mteichtahl/trace/templates/scaffold/empty/README.md

# __TR_NAME__

Run by [trace](https://github.com/mteichtahl/trace): pushes open their own pull requests, which merge themselves when the build passes; failures are triaged and fixed by the worker. The rules for agents are in `.trace/rules.md`.
