mteichtahl/trace/templates/scaffold/kicad/hardware/README.md

# Hardware

Put the KiCad project here (File → New Project in KiCad, saved in this folder). The build runs ERC and DRC on every project it finds (`tracectl check`).
