mteichtahl/trace/templates/scaffold/kicad/firmware/README.md

# Firmware

Put the firmware here. `tracectl firmware detect` recognises Cargo (embedded Rust), PlatformIO, Zephyr, ESP-IDF, the Pico SDK, Arduino and Makefiles; register a target with `tracectl config set firmware.targets ...`.
