mteichtahl/trace/docs/user-journey.md

# trace: user journey from definition to fabrication

Oct 27, 2026 · @Marc Teichtahl

A trace project moves through nine stages, from a written intent to a board running its own tests on the bench, and every stage ends at a gate a person passes. The agents do the measuring; people make the calls that cost money or cannot be undone.

## Who uses it and how it behaves

Three roles, mapped onto trace's existing permission classes:

| Role | Permission class | What they do in the journey |
| --- | --- | --- |
| Owner | admin | States the intent, signs every gate, approves spend (the order) |
| Contributor | user | Captures schematics, places parts, answers agent questions, raises issues |
| Reviewer | guest | Reads the design record, comments at gates, never changes the design |

Principles the journey follows:

1. **One record.** Requirements, decisions, runs and evidence live in the project database. Every screen is a view of it; nothing lives only in a chat.
2. **Evidence, not claims.** A stage is done when its gate criteria are measured, each linked to a run id. An agent's opinion never passes a gate.
3. **People decide, agents prepare.** Agents propose and measure; a person approves requirements, architecture, the layout, the release and the order. Every task a person does runs through a guided skill that enforces a minimum quality bar, and every decision a person is asked to make comes with trace's recommendation and the reasons for it.
4. **Every requirement is traceable.** From the line in the brief, through the part and the net, to the test that proved it on the bench.
5. **Going back is normal.** A failure at any stage reopens the earliest stage it touches, and the record shows why.
6. **The user is told only when it matters.** A gate is ready, an agent is stuck, or a decision is needed. Everything else is in the record. Whatever trace does say leads with a short summary in plain words, with the detail one tap away.

## The journey at a glance

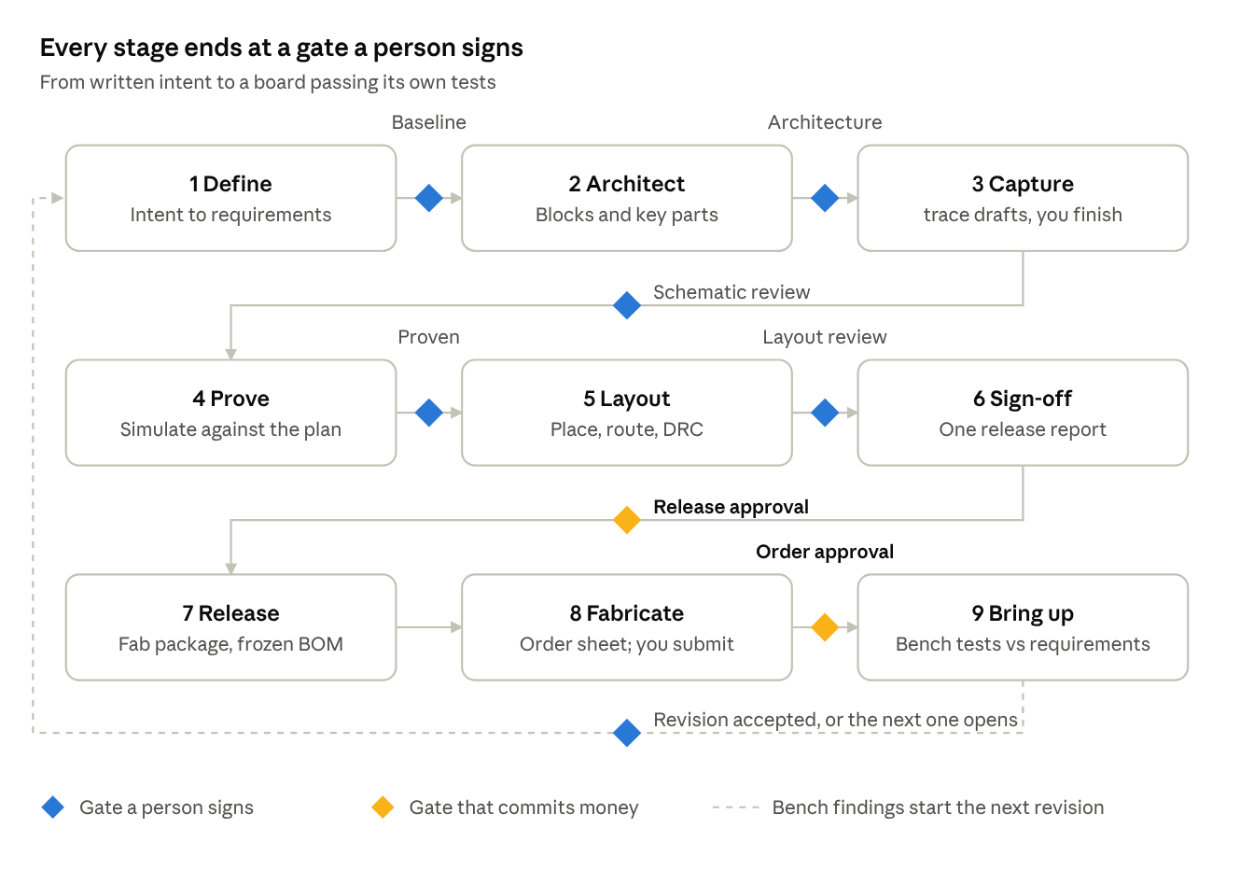
[picture p35: docs/ux/journey.png]
The journey: nine stages and eight gates


*the journey · 9 stages, 8 gates*

Stages 1 to 6 are where the design changes; from Release on, the design is frozen and the gates commit money. Bench findings loop back as a new revision rather than edits to the released one.

## Stage by stage

Each stage lists what the person does, what trace does, what the person sees, and the gate that closes it. Tool names are the ones trace has today.

### 1. Define

- **Person:** writes the intent in plain words (what it does, where it lives, power, interfaces, size, cost, quantity) and attaches any specs or reference datasheets.
- **trace:** the Verification agent extracts candidate requirements (`verify.requirements extract`), the AMS agent drafts analog specs (`ams.spec`), and each asks about gaps: missing limits, conflicting numbers, untestable wording.
- **Sees:** a requirements list, each with kind, acceptance criterion and source line, marked proposed or accepted.
- **Gate, requirements baseline:** every requirement accepted or struck, each has a measurable criterion, and the owner signs.

### 2. Architect

- **Person:** chooses between architectures the agents propose, or sketches one.
- **trace:** proposes a block diagram, sizes the key circuits (`calc.*`), picks candidate parts (`parts.search`, `parts.lookup`), pulls their datasheets into the library, and checks stock and lifecycle. Key parts follow the same in-stock order as Capture: in stock at JLCPCB/LCSC for the build quantity, then in stock elsewhere, and only then out of stock, with the reason written on the part.
- **Sees:** the block diagram, a key-parts list with price, stock and lifecycle, and the trade-offs between options.
- **Gate, architecture review:** blocks and key parts approved; every requirement maps to at least one block; every key part in stock for the build quantity or its exception signed.

### 3. Capture

- **trace:** drafts the schematic from the approved architecture: one sheet per block, parts from the key-parts list with MPN and LCSC fields filled, and every other part chosen in stock first, in the same order as key parts: in stock at JLCPCB/LCSC for the build quantity, then in stock elsewhere, and only then out of stock, with the reason written on the part, support circuits sized with `calc.*`, and each sheet annotated with the requirements it serves.
- **Person:** finishes and corrects the sheets in KiCad and pushes them. trace re-checks every push: ERC, each part's use against its datasheet limits (cited by page), missing fields, and BOM cost.
- **Sees:** the drafted sheets, then a review list per sheet: what the person changed from the draft, ERC findings, datasheet conflicts, BOM gaps, and any part not in stock with an in-stock alternative (parts.alternatives).
- **Gate, schematic review:** ERC clean or waived with a reason, no open datasheet conflicts, every part in stock for the build quantity (parts.bom\_check) or its exception signed, and the firmware pin plan matches the schematic.

### 4. Prove

- **Person:** reviews results and waives what cannot be simulated.
- **trace:** writes the test plan (`verify.plan`) and runs it: SPICE, corners and Monte Carlo yield, op-amp stability and noise (`ams.*`), logic and formal checks for any HDL (`verify.*`), and FPGA synthesis and timing (`fpga.*`).
- **Sees:** the coverage matrix, requirement by requirement: verified, failing, untested or waived, each linked to its run.
- **Gate, design proven:** every pre-layout requirement verified or waived; no failing item.

### 5. Layout

- **Person:** sets the outline, stackup and fixed parts (connectors, mounting holes, anything mechanical), then adjusts trace's placement.
- **trace:** proposes a placement from the floorplan (blocks grouped, decoupling at its pins, connectors on the edge), re-checks the person's adjustments (`pcb.placement_check`), routes (`pcb.autoroute`: OrthoRoute for the dense core, then Freerouting), matches lengths, runs DRC with schematic parity, and renders the board.
- **Sees:** the proposed placement as a render and an overlay, then the routing report, unrouted count, DRC and length-match findings.
- **Gate, layout review:** zero unrouted, DRC clean or waived, length groups in tolerance, mechanical fit passes or each clash is waived, renders approved.

### 6. Sign-off

- **Person:** reviews the release report and decides.
- **trace:** runs EMC prechecks and, where warranted, an openEMS model (`emc.*`), checks signal integrity, re-runs the whole plan on the final files, and checks the BOM for the build quantity (`parts.bom_check`).
- **Sees:** one release report: coverage, EMC pre-compliance estimates, BOM cost and stock for N boards, open waivers.
- **Gate, release approval:** the owner approves. This is the last point where change is cheap.

### 7. Release

- **Person:** nothing beyond approving.
- **trace:** builds the fabrication and assembly package (`kicad.fab`: Gerbers, drill, BOM, placement, JLCPCB files), freezes a BOM snapshot with prices, tags a release, and stores it all as one artifact set.
- **Sees:** the release, with its files, its revision and the report that approved it.
- **Gate:** none; the package is a product of the approval.

### 8. Fabricate

- **Person:** signs the order gate, then uploads the package and pays on JLCPCB's site, and records the order number in trace.
- **trace:** prepares everything JLCPCB needs (Gerbers, BOM and CPL in its columns, board options), re-checks LCSC stock and price on the day, and tracks the order once its number is recorded.
- **Sees:** an order sheet with the files, options, expected cost and any stock change since sign-off; then the order's status.
- **Starts:** signing the release approval starts the Implementation agent on the package (`kicad.fab`) and today's stock check (`parts.bom_check`, then `fabricate.order.stock`). The person's "The order sheet matches the release" waits for both: until they are met, the next step is trace's, and trace starts that work itself when nothing is working on it.
- **Gate, order approval:** an admin signs before the files are handed over. trace never pays. The stage closes at a second gate, boards received and inspected with firmware and bench ready (see Using the fab wait).

### 9. Bring up

- **Person:** puts the board on the bench and wires the instruments.
- **trace:** steps through a bring-up checklist with current-limited supplies (`hil.psu`), builds and flashes firmware (`firmware.*`), runs the plan's hardware items (`hil.*`), and records results against requirements.
- **Sees:** the same coverage matrix, now with bench evidence, and any failures turned into issues routed to a specialist.
- **Gate, revision accepted:** every requirement verified on hardware or carried to the next revision as an issue.

## Beyond the core journey

The nine stages cover a new design up to its first accepted board. Seven additions close the gaps around them: a way in for existing designs, a firmware track, mechanical fit, deliberate change, work during the fab wait, the stages after acceptance, and a running view of cost and schedule. Hard gates still hold for every stage; the firmware track and the fab-wait work are the current stage's own work, not the next stage started early.

### Starting from an existing design

A project can start from an existing KiCad design instead of an intent. The Design import skill reads what exists, rebuilds the record the journey needs, and enters the journey at the earliest stage whose gate the design cannot yet pass.

1. **Read:** trace reads the schematic, board, BOM and any docs, firmware or test results in the repository (`kicad.*`, the knowledge base).
2. **Reverse-build:** it drafts the intent and requirements from what the design does (rails, interfaces, parts and their ratings), and the architecture from the sheet hierarchy.
3. **Confirm:** the person corrects the drafted intent and requirements through Intent builder and Requirements review, marking each requirement as stated by a person or inferred from the design.
4. **Assess:** trace runs every gate's checks against the design as it stands (ERC, DRC, the datasheet-limit check, stock, coverage) and shows which gates it would pass today.
5. **Enter:** the project starts at the first gate that fails; earlier gates are signed on the import evidence.

An imported board that is already built enters at Bring up as revision A, so its bench results become the first evidence.

### The firmware track

Firmware runs as a track beside the hardware stages, with its work tied to each stage's gate, so a board arrives with firmware ready to flash and tests ready to run. Its gate criteria are added to the hardware gates; it has no gates of its own.

| Stage | Firmware work | Added to the gate |
| --- | --- | --- |
| Define | Firmware requirements: behaviours, timing, power states, update method | Firmware requirements accepted with the rest |
| Architect | Toolchain, RTOS or bare metal, peripheral budget per block | Every interface has a peripheral; no peripheral claimed twice |
| Capture | Pin plan agreed with the schematic: each MCU pin's function, alternate function and net | Pin plan matches the schematic; no conflicting alternate functions |
| Prove | Drivers and logic built and unit-tested on the host; the MCU simulated where a model exists (Renode for STM32 is the natural first) | Firmware builds clean; unit tests pass; size fits flash and RAM (`firmware.size`) |
| Layout | Nothing new; pin swaps made for routing are checked against the pin plan | Pin plan still matches after pin swaps |
| Fabricate | Bring-up firmware and test scripts finished while boards are made | Release build tagged with the hardware revision |
| Bring up | Flash, run, fix (`firmware.*`, `hil.*`) | Firmware requirements verified on hardware |

The firmware-only template keeps this track and drops Capture, Layout and Fabricate. A firmware change after release is a change request against the firmware alone, without reopening the hardware.

### Mechanical fit

When the intent names an enclosure, the board is checked against it in 3D before the layout gate, so a connector that misses its cut-out is found on screen, not in the hand.

- **Define:** the intent builder asks for the enclosure as a model (STEP or STL) or as limits (inside size, mounting points, cut-out positions, height above and below the board).
- **Board setup:** the outline, mounting holes and fixed parts are taken from the enclosure model where one exists.
- **Layout:** trace exports the board as STEP (`kicad.export`), places it in the enclosure, and checks clearances: parts against walls and lids, connectors against cut-outs, height against the limits. A new fit-check tool does the geometry; `render.model` renders the result.
- **Gate:** the layout gate adds "mechanical fit passes, or each clash is waived", and the release stores the board-in-enclosure render.

Without an enclosure, the intent's size and height limits are checked against the board alone.

### Changing the design on purpose

A deliberate change (a new or changed requirement, a part going end of life, a better idea) goes through a change request, so its effect on the work already done is known before anyone edits the design.

1. **Raise:** anyone on the project raises a change request through the Change request skill, stating what changes and why.
2. **Analyse:** trace follows the traceability chains from the change to every requirement, block, sheet, board area, test and piece of evidence it touches, and marks that evidence stale.
3. **Show the impact:** the earliest stage that must reopen, the gates that will need signing again, the stale evidence to re-run, and the expected cost and time from the running view, with trace's recommendation (approve, reject, or defer to the next revision) and its reasons.
4. **Decide:** an admin approves or rejects it, like a gate.
5. **Apply:** the project returns to the earliest affected stage; only stale evidence is re-run, and everything else carries forward.

A released revision is never edited. A change after release always opens the next revision, and a firmware-only change opens a firmware revision without reopening the hardware.

### A stage is signed only when its work is settled

A gate checks the design as it will stand, so no stage is reviewed or signed while its work is still moving (src/core/journey.ts `pendingBlockers`, `withPending`; src/api/pending-changes.ts `pendingOf`, `stillWorking`). The current stage's gate is locked while:

- **a change is open** for that stage or an earlier one: a change trace made, or a person's own edit (a change whose stage is not known holds it too; one from a later stage does not). Accept or discard it first. A change with no design content does not hold it: one that carries only the project's record (a finished job's runs) or only the documents (src/core/change-contents.ts `changeContent`, read from its files). What the gate is signed on cannot change with it: evidence a criterion cites from it counts only once it is accepted, and a requirement its record edits still takes the project back to Define when it is accepted. The documents still hold Sign-off, which checks them, and the gates into Fabricate wait for every change (test-esp32 #101, #116).
- **an agent is still working** on the project: a job queued, running or paused (the weekly look for work and a specialist's own sub-jobs aside). Let it finish, or stop it.
- **trace cannot look** (GitHub or the job list not answering): it stays locked rather than guessing.

While any of these holds, the gate page shows what is pending and how to settle it instead of the review: no evidence is opened, nothing is signed, and gate.sign refuses with the same words. The next step becomes settling it: reviewing the change, or watching the job. The page opens for review on its own once nothing is pending.

### Nothing goes to Fabricate while it is changing

What is ordered must be the design as accepted, with nothing still moving. Three rules hold this (src/core/journey.ts `guardsFabricate`, `pendingBlockers`, `applyChange`):

- **Fabricate is locked while anything is pending.** The gates that lead into Fabricate (the release approval at Sign-off, whose signature passes Release, and the order approval) cannot be signed while a change trace made is still open (accept or discard it first), while a requirement changed after the baseline is not agreed again, or while trace cannot check (GitHub not answering): it stays locked rather than guessing. The gate shows each reason, and the next step becomes settling the change instead of signing.
- **A changed requirement or architecture takes the project back to its stage.** When a requirement or the intent behind it changes after the requirements baseline (a person strikes or rewords it, or a change trace made alters it and is accepted), the project returns to Define; when the architecture criteria or the chosen architecture change after the architecture review, it returns to Architect. The signatures from that stage on stop counting, the stage's own person criteria are agreed again (Requirements review, Architecture choice), its trace-owned evidence is checked again, and every stage after it is done again, since it was built on what changed. A decision made again the same way, with the same words, changes nothing. A requirement change found only when a gate is about to be signed (an agent's change merged on its own) does the same, and the signature is refused with the reason.
- **After a requirement change, only what it reaches is redone** (src/api/reopen-scope.ts). Every gate from Define is still signed again, but signing one does not start the next stage's agents from the top. A stage whose work the changed requirements do not reach keeps its evidence: its criteria are met again as they were, it starts no agent and no documents job, and its gate is ready to sign at once. What a change reaches comes from the record's traceability: a change of a requirement's words reaches the architecture blocks and schematic sheets that serve it (and the stages built on them, and the layout, which is not traced); a change of its acceptance criterion alone reaches none of them, since Prove checks the design against the new criterion. Prove and Sign-off are reached by any change, and Prove runs again only the changed requirements' tests. A stage that is redone is asked to redo only that part and say what it kept. The Overview lists the gates to sign again and which keep their evidence. A reopen for anything else (a failure, a changed decision) still redoes every stage after it.
- **After release, a change starts the next revision.** A released revision (its release cut, or the project past Release) is never edited. The same changes start the next revision (A → B) at that stage instead (src/core/journey.ts `applyChange`, `startRevision`): the gates before it carry into the new revision signed, saying so; the stages from it on start again; waivers taken for "this revision only" from that stage on are closed. The released revision's signatures, orders and boards stay exactly as they were.

### Using the fab wait

The Fabricate stage now runs until the boards are on the bench, and its work fills the one to three weeks JLCPCB takes, so bring-up starts the day the boards arrive. This is Fabricate's own work, so hard gates still hold.

- **Firmware:** the bring-up and release builds finished and tagged with the hardware revision.
- **Bring-up plan:** the power-on sequence with expected readings and limits per step, built from the schematic and the test plan.
- **Bench:** the bench wiring view drawn and the Bench setup skill run against a powered-off bench, so instruments, limits and wiring are ready.
- **Test scripts:** every hil test item scripted and dry-run against recorded or simulated data.
- **Incoming inspection:** when boards arrive, the Incoming inspection skill checks them against the release (count, visible assembly faults, parts JLCPCB did not place, photos against the render).

The Fabricate gate becomes "boards received and inspected, firmware and bench ready", signed before Bring up starts.

### After the first board

An accepted revision can continue through three more stages, chosen per project. A one-off prototype stops at acceptance; a product carries on.

| Stage | What happens | Gate |
| --- | --- | --- |
| 10 Certify | trace builds the lab test pack from the compliance requirements (standards, test setups, firmware test modes, the pre-compliance estimates); the person books an accredited lab; results come back as evidence against the requirements | Every compliance requirement passed at the lab, or a change request raised |
| 11 Produce | Design-for-manufacture and design-for-test review; a manufacturing test and programming procedure (and fixture, if needed) from the test plan; a golden board; volume quotes at the production quantity | Production release signed: the files, the test procedure and the programming image for volume |
| 12 Sustain | A scheduled task re-checks every part's stock and lifecycle weekly; a part going short or end of life raises a change request with in-stock alternatives; field issues are raised against requirements | No gate; it runs until the product is retired |

Certify replaces pre-compliance estimates with real results, which is why it needs a person to book and attend the lab. Sustain is the only stage that runs on its own schedule rather than a person's request.

### Cost and schedule

The design record carries a running view of what the project has spent, what it has committed and what it is forecast to cost, beside where its time went and when the next gate is expected. A person sees the cost of a decision before making it, and the change request and gate skills show the same figures.

**Cost**, by revision and stage:

- **Spent:** orders paid (recorded by Order submit), lab fees (Certify), and cloud use: GPU and CPU jobs and agent model use, attributed to the project through its AWS cost-allocation tags.
- **Committed:** signed orders not yet paid, booked lab time.
- **Forecast:** the BOM at the build quantity from today's prices, the next order's quote, and the cloud use of the remaining stages at this project's own past rate.
- **Budgets:** two, each optional and per revision, never added together. The build budget is what the order may cost (boards, parts, case; the project's budget requirement): orders paid, committed and the order's forecast count against it. The cloud-work allowance is what trace's own cloud work may cost: the Overview warns as the current stage nears its share of it. Raising one never raises the other.

**Schedule**, by stage:

- **Actual:** each stage's start and end, split into time the agents and people were working and time it waited on a person (a question or a gate).
- **Forecast:** the next gate's expected date, from the remaining work, JLCPCB's quoted lead time, and how long this project's gates have taken to sign.
- **Waiting:** what is waiting on whom right now, oldest first.

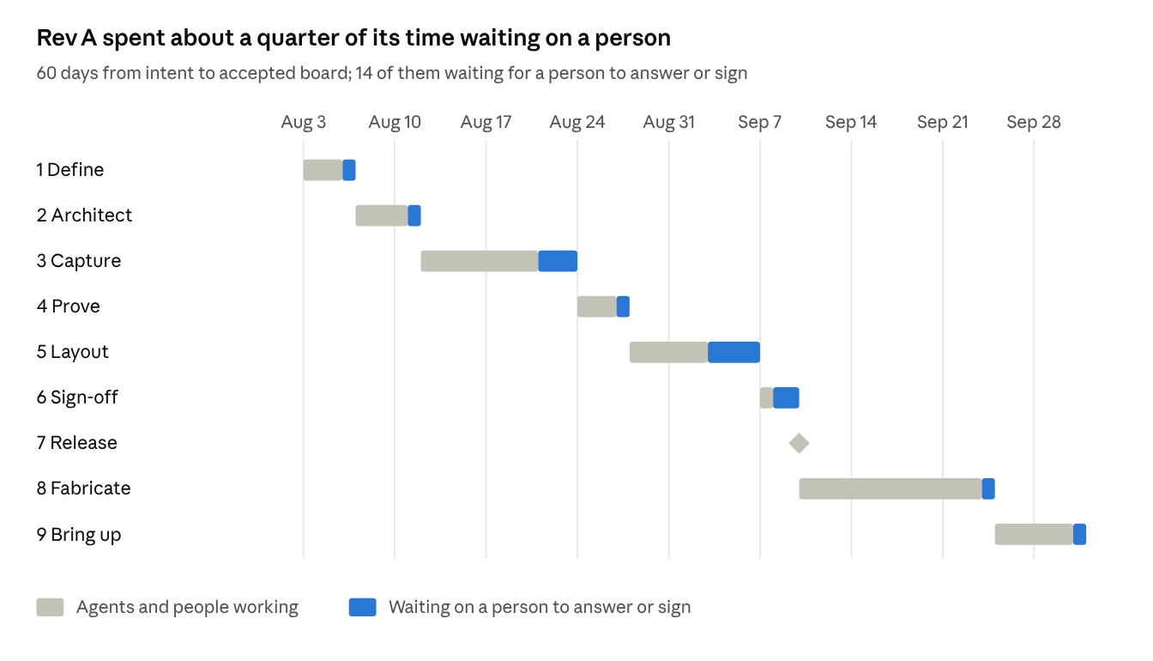
[picture p36: docs/ux/schedule-timeline.png]
Cost and schedule: stage timeline example


*stage timeline · soil sensor rev A, illustrative dates*

In the example, the blue segments are the time to fix: Capture and Layout each waited days for a signature. The view makes that visible, and the notifications rule (a gate is ready to review) is what shortens it.

## Across every stage

**The design record.** One project page holds the stage the project is in, the next gate and what it still needs, the requirements with their status, open questions for people, and the run history. Each gate leaves a signed snapshot: who approved, when, the evidence, and the waivers taken.

**Revisions.** A release starts a revision (rev A, rev B). Bring-up findings open the next one, and requirements, waivers and test results carry forward so nothing is re-proven by hand.

**Gates are hard.** No work in a stage starts until the gate before it is signed; agents queue the next stage's work but do not run it. Any admin may sign a gate, with one signature, and the signature records who, when, the evidence and the waivers.

**Templates.** Each project starts from a template that keeps only the stages it needs: board (all nine), FPGA (no Capture or Layout; Prove covers synthesis and timing, Release is a bitstream), firmware (Define, Architect, Prove, Release, Bring up) and mixed (all nine, with FPGA and firmware items in Prove).

**Going back.** Any failure reopens the earliest stage it touches:

| Found at | Typical cause | Reopens |
| --- | --- | --- |
| Prove | Circuit misses a spec at a corner | Capture, or Architect if a part must change |
| Layout | Cannot route, or EMC precheck fails | Layout, or Capture for a pinout or part change |
| Sign-off | A key part goes out of stock or end of life | Architect, with `parts.alternatives` as a starting point |
| Fabricate | Stock gone on order day | Sign-off, with a substitute re-proven |
| Bring up | A requirement fails on the bench | The stage the root cause lives in, as a new revision |

**Asking people.** Agents ask through the project's issues and the web app, never by stopping silently. A question names what it blocks, offers options where it can, and cites what it already read (knowledge base, datasheets). A gate never opens on a timeout.

**Notifications.** The person hears about four things only: a gate is ready to review, an agent is stuck, a question blocks progress, and money is about to be spent.

**Events, not polling.** trace acts when something happens, not by checking on a timer: a push, a finished run, a signed gate, a reply to a question, a review comment. The web app keeps one live connection open, so every screen changes the moment the record changes and nobody refreshes a page. trace checks on a timer only where the other side sends no event, and then it says so.

**Fast, and the person in control.** Every click is answered at once, even when the work behind it takes hours: what started, what it is doing now, and how long it is likely to take. Long work can be paused, cancelled or moved up the queue at any time; a cancel stops within seconds and says what was kept. Nothing runs that a person, or a rule a person set, did not start, and trace never changes a design out of sight.

**Saying when trace will look next.** Wherever trace has to check on a timer, the screen shows what it is waiting for, when it last looked, when it will look next, and a Check now button. For example: "Waiting for JLCPCB to confirm the order. Checked 2 minutes ago; next check in 13 minutes." When checks slow down because nothing is changing, the next-check time shows that too.

| What trace waits on | How trace hears about it | What the person sees |
| --- | --- | --- |
| Pushes, pull requests, reviews, test runs | GitHub sends an event | The change, at once |
| Agent and worker jobs | The job reports each step as it happens; a specialist waiting on the worker hears the moment it ends | Live progress and the current step |
| The pull-request update queue | GitHub sends an event on each merge and each finished build; a half-hourly run is a safety net | The queue moves at once |
| Graphics card jobs (renders, routing) | AWS sends a job-state event to a queue made for that job; one check at 30 seconds, one at 90 seconds, then every 5 minutes in case an event is lost | Live state, the moment it changes |
| Building the agents' container image (installer) | Checked every 30 seconds: the installer runs on your computer, where AWS cannot send it events | Last checked, a live countdown to the next check, Check now |
| Knowledge base updates | Checked every 10 seconds while one runs (Bedrock sends no event when an ingestion job finishes) | Each check as it happens, with the next check time and Check now |
| Part stock and prices at JLCPCB | Checked daily and at every gate (no event feed known) | Last checked, next check, Check now |
| JLCPCB order status | Checked on a timer once an order is placed (no event feed known) | Last checked, next check, Check now |
| Bench instruments (for example a scope capture) | Checked every tenth of a second; the instrument sends no event | A progress bar during the capture |

**Summary first, detail on request.** Every interaction leads with a summary a person can act on, and keeps the detail behind it, one tap away. This holds for messages, questions, notifications, findings, gate cards, reports and skill steps alike.

- **The summary:** one or two sentences that say what happened or what is needed, and the recommendation when a decision is asked for.
- **The detail:** the evidence, numbers, runs, sources and alternatives, opened by tapping the summary. Nothing a person needs to decide is only in the detail; nothing in the summary lacks detail behind it.
- **Visuals follow the same rule:** a small picture in the summary, the full-size view with its data behind it.

**Plain, contextual language.** trace writes the way a good colleague talks, fitted to the reader and the moment.

- **Simple and clear:** short sentences, everyday words, one idea per sentence, the point first.
- **No unexplained acronyms:** a term is spelled out in words, or explained the first time it appears in an interaction (for example "the parts list (BOM)"), and every technical term can be tapped for a one-line definition from the glossary at the end of this document.
- **Contextual:** wording fits the stage and the person. A notification names the board, the stage and what is needed; a reviewer who has not seen the project gets the context a regular contributor does not need.
- **Checked like everything else:** a writing check runs on what trace sends a person (summary present, acronyms explained, sentence length), and a message that fails it is rewritten before it is sent.

**Visuals.** Wherever a picture can show what words describe, trace shows it, and a person can ask for one at any point ("show me the power sheet", "render the bottom side"). Skills open with the visual for their step, findings point at a place on a picture rather than a coordinate, and every image is stored with the run that made it, so it is evidence like any other. Slow images (photographic renders, turntables) are made when asked or at a gate, never on every push.

| Stage | Shown by default | On request | Made by |
| --- | --- | --- | --- |
| Define | Requirements traced to the intent | A requirement's source page from a spec or datasheet | `datasheets.page_image`; traceability view (new) |
| Architect | Block diagram per option; key parts side by side | Datasheet figures for a part; a comparison chart of the scores | Block diagram (new); `datasheets.page_image` |
| Capture | Each drafted sheet, with notes and findings marked on it | Any sheet; a part's datasheet figure beside its symbol | `kicad.export` (sch\_svg, sch\_pdf); finding overlays (new) |
| Prove | Waveforms and sweep plots per test; the coverage matrix | Any run's waveforms; corner and Monte Carlo spreads | Plots from `sim.*` and `ams.*` run data (new) |
| Layout | Placement by block; DRC and placement findings on the board | Top and bottom renders; a single net highlighted; a 3D view | `kicad.export` (pcb\_svg, render); `render.board` |
| Sign-off | Release report with coverage and EMC charts | Photographic renders; a turntable; field plots | `render.board`, `render.turntable`; `emc.run` output |
| Release | Board renders stored with the release | The Gerber layers as images | `render.board`; `kicad.export` |
| Fabricate | The order sheet with board renders | JLCPCB's preview beside trace's render | `render.board` |
| Bring up | Wiring diagram for the bench; scope captures per step | Any capture or measurement plotted against its limits | `hil.scope_capture`; bench wiring view (new) |

Most images come from tools trace already has; the rows marked new (traceability, block diagrams, finding overlays, plots from run data, the bench wiring view) need building; each is specified, with an example, in the next section.

## The five new visuals

Each new visual is specified below with an example drawn for the soil sensor from the walkthrough. The examples are illustrative: the parts, values and findings are made up to show the shape of each view.

### Traceability view

The traceability view shows every requirement between the intent it came from and the evidence that proves it, so a person can follow any line from a sentence in the brief to a run on the bench. It is the main view in Define and the backbone of every gate.

- **Columns:** intent statements, requirements, evidence. Waivers and test items appear in the evidence column with their own marks.
- **Status:** each evidence box is verified, failing, untested or waived; a failure colours its whole chain back to the intent, so the person sees what promise is at risk.
- **Interaction:** tap any box to open its source (the intent line, the requirement record, the run with its plots); filter to one stage, one kind or one status.
- **Data:** the `requirements`, `test_items` and `test_results` tables, plus a new link from each requirement to its intent line.

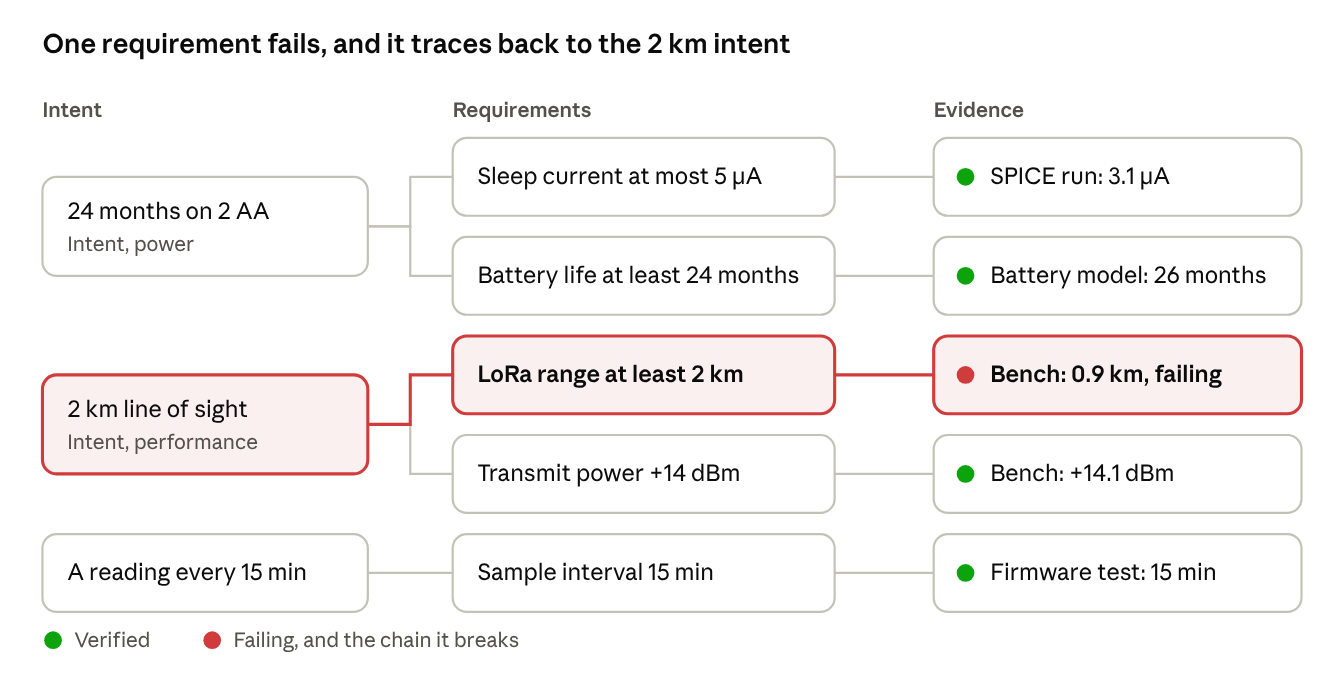
[picture p37: docs/ux/traceability-view.png]
Traceability view example


*traceability view · soil sensor rev A, illustrative*

In the example, the bench range test fails and the chain lights up back to "2 km line of sight": that is the intent the next revision has to keep.

### Architecture block diagram

The block diagram is how the Architecture choice skill shows each option, and the map trace drafts the schematic from. One diagram is drawn per option, in the same layout, so options can be compared side by side.

- **Each block shows:** its name, the key part with its stock status, and the requirements it serves.
- **Each connection shows:** what flows along it (a rail and its voltage, a bus, an RF path).
- **Interaction:** tap a block for the part's datasheet, price breaks and alternatives; tap a requirement to jump to its traceability chain; switch between options with the layout held still.
- **Data:** a new architecture record in the project database (blocks, connections, key parts, requirement mapping), written by the architecture step and read by schematic drafting, which turns each block into a sheet.

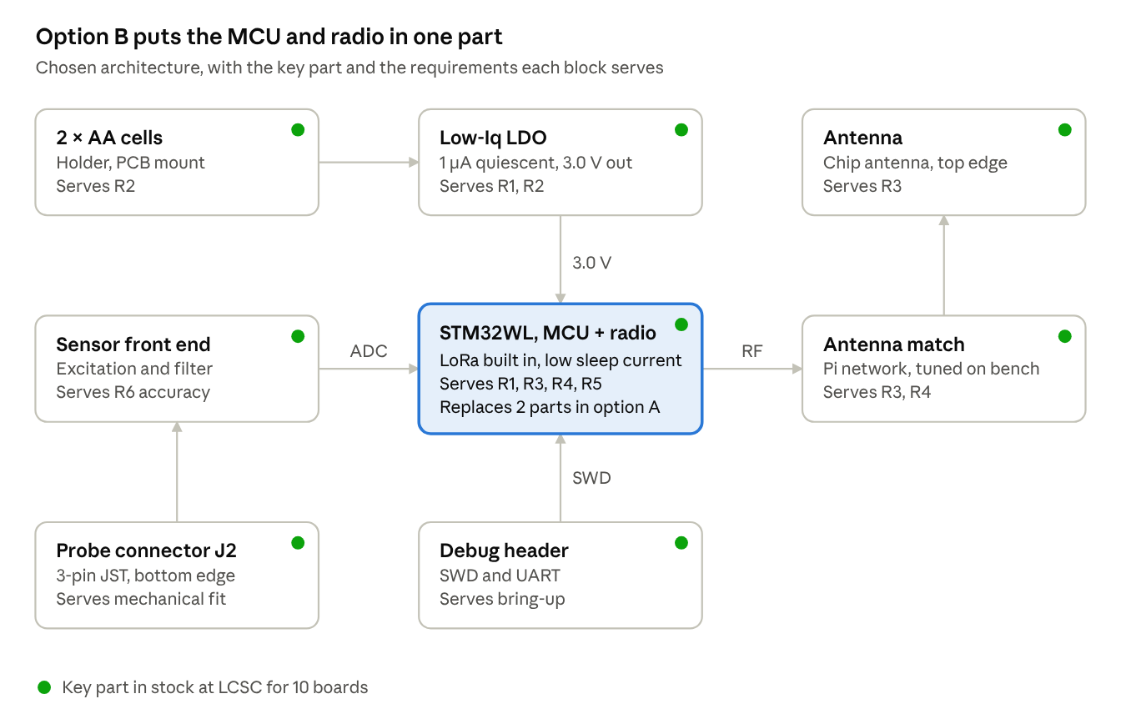
[picture p38: docs/ux/block-diagram.png]
Architecture block diagram example


*architecture block diagram · soil sensor option B, illustrative*

A requirement served by no block, or a key part not in stock, shows on the diagram before the architecture gate, not after.

### Findings marked on sheets and boards

Every finding from ERC, DRC, the placement check, the datasheet-limit check and the EMC precheck is drawn where it is, on the schematic sheet or the board, with a numbered marker that matches its entry in the list beside it. A person fixes what they can see instead of hunting for a coordinate.

- **On sheets:** the symbol, pin or net is circled; a datasheet conflict links to the cited page image.
- **On boards:** the part, track, zone or gap is marked, with the measured distance drawn when the finding is a distance.
- **Severity:** findings that block the gate are red; findings that must be fixed or waived are amber; waived findings stay visible but grey.
- **Interaction:** tap a marker or a list entry to zoom to it; after the next push, fixed findings fade out and new ones appear.
- **Data:** the findings trace already records with each run (type, location, items, evidence), drawn over the `kicad.export` SVG of the sheet or board layer.

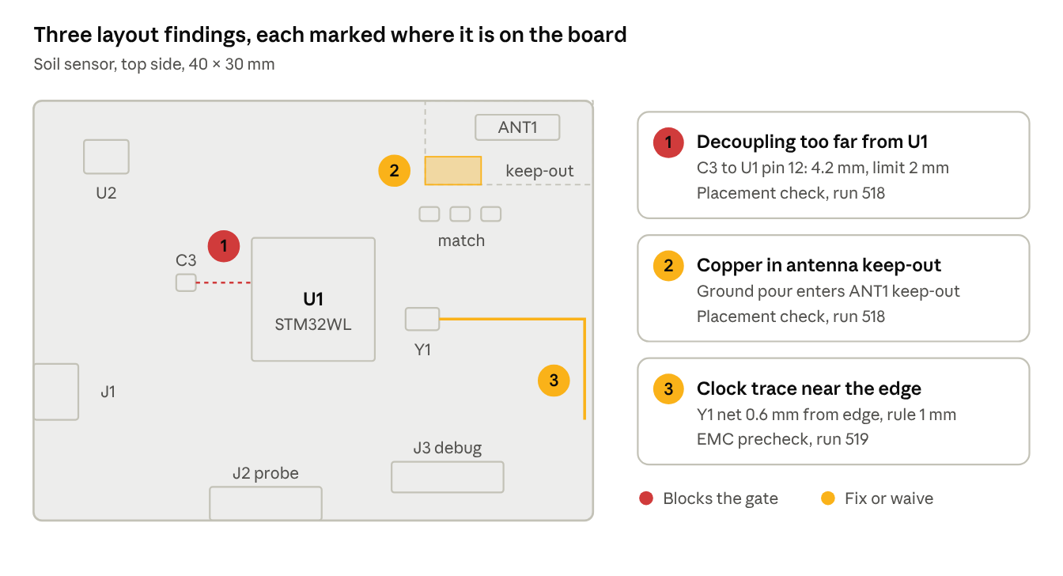
[picture p39: docs/ux/findings-overlay.png]
Findings overlay example


*findings overlay · soil sensor board, illustrative*

In the example, finding 1 blocks the layout gate; findings 2 and 3 can be fixed or waived through the Waiver skill.

### Plots from run data

Every simulation and measurement run gets a plot drawn from its own recorded data, with the requirement it is judged against drawn on it. The person reads the verdict and the margin at a glance, and the plot stays with the run as evidence.

- **Plot types:** waveforms (transient runs, scope captures), sweeps (one value against a parameter), spreads (corners and Monte Carlo as a median with a range), Bode plots (op-amp loop gain), and spectra (EMC estimates against the CISPR limit line).
- **Always on the plot:** the limit or target from the requirement, the margin to it, and the run id.
- **Interaction:** hover a point for its value and conditions; tap it to open the run; overlay the same plot from an earlier revision to see what changed.
- **Data:** the measurements trace already stores with each run (`sim.*`, `ams.*`, `hil.*`), with the requirement's acceptance criterion as the reference line.

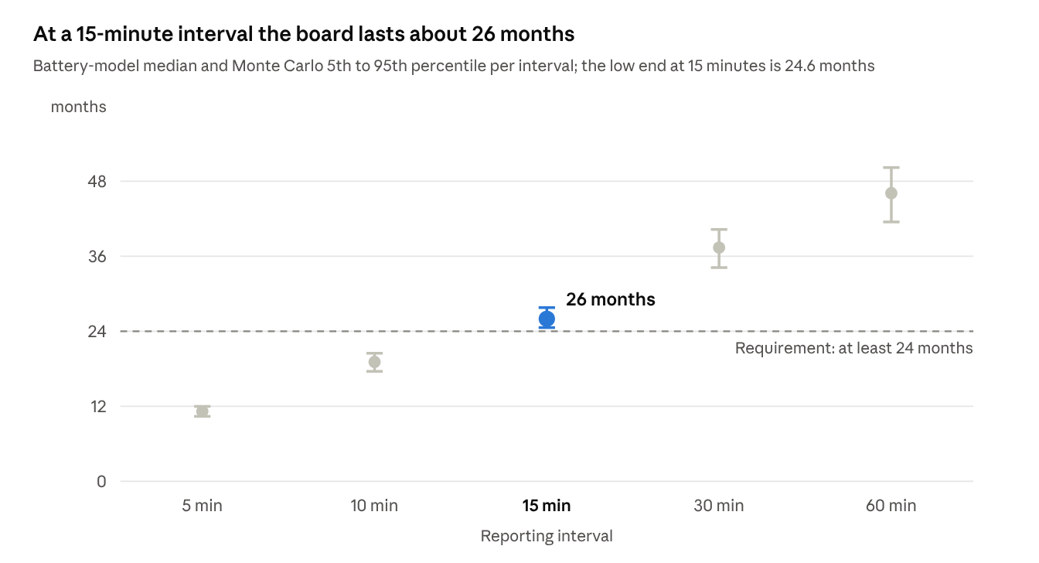
[picture p40: docs/ux/run-plot.png]
Plot from run data example


*battery-life model and Monte Carlo sweep · soil sensor rev A, illustrative values*

In the example, even the low end of the Monte Carlo spread at the chosen 15-minute interval stays above the requirement; a 10-minute interval would fail it.

### Bench wiring view

The bench wiring view is how the Bench setup skill shows the person what to connect, and the record of how the bench was wired when the results were taken. trace builds it from the test plan's hardware items and the bench configuration.

- **Shows:** each instrument with its settings, each wire with what it carries, and each connection point on the board by its reference and net (connector pin or test point).
- **Safety marks:** power paths are drawn apart from signal wires and carry their current limit; a supply without a limit cannot be drawn as connected.
- **Checks:** the three Bench setup checks appear under the drawing and tick as each passes: supply limits set, every instrument answered its identity query, every wire matched to a net.
- **Interaction:** tap a connection point to see it on the board render; tap an instrument for its saved settings; the person ticks each wire as connected.
- **Data:** the bench configuration (`hil.instruments`, `hil.serial`, `hil.can`), the test plan's hil items and the board's net and test-point list; a new record links each wire to a net.

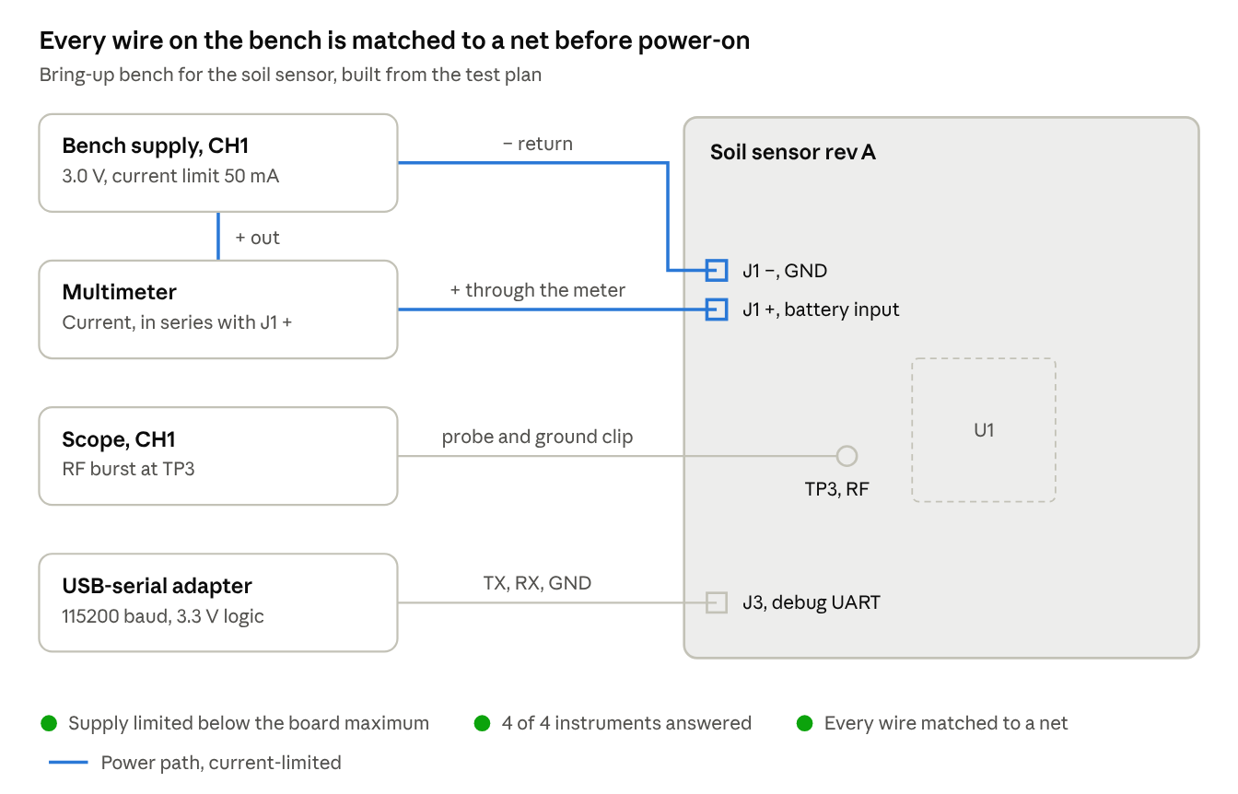
[picture p41: docs/ux/bench-wiring.png]
Bench wiring view example


*bench wiring view · soil sensor rev A bring-up, illustrative*

The view is stored with each bring-up run, so a later reader knows exactly how the board was wired when a result was taken.

## Guided skills for every person's task

Every task a person does is run by a skill that guides them through it and will not accept the result until it meets a minimum quality bar. The bar is checked by a tool that returns pass or fail with the reasons, never by the model's opinion; what passes is written to the project database, and what fails says exactly what is missing.

**Every decision comes with a recommendation.** Whenever trace asks a person to decide, in a skill, a question, a gate or a notification, it states which option it recommends and why. A recommendation has four parts:

- **The option:** one clear choice, never "it depends".
- **Why:** the evidence behind it, cited (the requirement, the run, the datasheet page, the stock or price, the cost and time from the running view).
- **What it gives up:** the trade-off the person accepts by taking it.
- **The alternatives:** each other option with the reason it was not recommended.

The person is always free to choose otherwise. When they do, the skill asks for their reason in a line and records it beside the recommendation, so a later reader sees both. Where a choice is purely the person's preference (a colour, a name), trace says so instead of inventing a recommendation. Every skill's quality bar includes: a decision that differs from the recommendation has a recorded reason.

| Skill | Stage | Guides the person through | Will not submit until |
| --- | --- | --- | --- |
| Design import | Start | Bringing an existing design into trace | Every drafted requirement is confirmed or struck; the entry stage is shown with the failing gate checks that set it |
| Intent builder | Define | Writing the product intent | Every item below is answered (spec follows the table) |
| Requirements review | Define | Accepting, editing or striking each proposed requirement | Each accepted requirement has one testable criterion with number and unit, a kind and a source; no duplicates or conflicts left open |
| Architecture choice | Architect | Comparing the proposed architectures and picking one | Each option was scored on the same criteria; the choice states why; every requirement maps to a block |
| Schematic finish | Capture | Correcting and completing trace's drafted sheets | Every change from the draft has a reason; ERC run on the final push; no part without MPN and LCSC fields |
| Pin plan review | Capture | Agreeing each MCU pin between schematic and firmware | Every used pin has a function and net; no alternate-function conflicts; schematic and firmware agree |
| Waiver | Any | Waiving a requirement, finding or check | States the reason, the risk if wrong, and where it will be verified instead (a later stage or the bench) |
| Change request | Any | Proposing a deliberate change to the design | What changes and why are stated; the impact (stages, gates, stale evidence, cost, time) has been reviewed |
| Board setup | Layout | Outline, stackup, mounting and fixed parts | Outline closed; stackup has layer count, thickness and copper weights; each fixed part has a mechanical reason |
| Placement adjust | Layout | Moving parts trace placed | Each move has a reason; placement check passes, or its findings are waived |
| Case design | Layout | The board's enclosure: process, clearances, the case and its order files | Process and material within JLC3DP's limits; every clearance change has a reason; the fit check passes or each clash is waived; the case is within the process's design rules |
| Gate signing | Every gate | Reviewing the evidence before signing | Every criterion shows its evidence run; every waiver taken at this stage has been opened and acknowledged |
| Release review | Sign-off | Reading the release report | Coverage, EMC estimates, BOM cost and stock and open waivers each acknowledged |
| Order submit | Fabricate | Placing the order on JLCPCB | The options entered match the order sheet; the order number and paid cost are recorded |
| Incoming inspection | Fabricate | Checking delivered boards against the release | Count, assembly faults and unplaced parts recorded; each board has a serial; photos stored |
| Bench setup | Bring up | Wiring instruments and buses | Each power supply has voltage and current limits; every instrument answers its identity query; wiring matches the plan |
| Bring-up run | Bring up | Powering up and running the hardware tests | Each power-on step passed its limits before the next; every failure is recorded as an issue |
| Certification run | Certify | Preparing for, attending and recording the lab test | The lab, standard and test setups are recorded; every compliance requirement has a lab result or a change request |
| Production release | Produce | Handing the design to volume manufacture | DFM and DFT findings closed or waived; the test procedure ran on the golden board; the volume quote is recorded |
| Question answer | Any | Answering a question an agent raised | The answer is specific enough to unblock the agent, and cites its source when it is a fact |

### Intent builder

The intent builder is a conversation, not a form. It asks one topic at a time, reflects back what it heard as draft statements, and pushes back on vague answers. The person can stop and return; the draft is kept.

Each statement trace drafts from an answer goes into the person's draft at once and shows in the Draft intent panel as Draft, where the quality bar checks it and the person can accept, edit or reject it. No agent job, branch or change is needed to write the intent. Submit intent records the statements in the person's words, beside people's other decisions in the journey record (a person's own statement is theirs, like an edit of an agent's line), so they are live at once; the agents' own proposals stay in the project database. trace's chat makes the same decisions on a statement already in the record as the panel's Accept, Edit and Reject: asked to fix a missing connector, a unit or an untestable line, it rewords the statement or sets its interface fields in the person's draft, where it shows as Not submitted and the quality bar checks it, and Submit intent records it like the person's own edit. A topic that does not matter is marked by a "don't care" statement in it, which the chat notes the same way.

Topics it covers, in order:

1. **Purpose:** what the product does, in one sentence, and who uses it.
2. **Environment:** operating and storage temperature, enclosure, ingress protection, vibration, where it is installed.
3. **Power:** source, input voltage range, power budget, battery life if any, behaviour on brown-out.
4. **Interfaces:** each one with type, connector, protocol, rate and direction.
5. **Performance:** the numbers that define success (accuracy, latency, resolution, range, throughput).
6. **Physical:** board size limits, mounting, height, connector positions, and the enclosure as a model or as limits.
7. **Compliance:** target standards and class (for example CISPR 32 class B), safety, markings.
8. **Build:** quantity per run, target unit cost, assembly preference.
9. **Constraints:** parts or vendors that must be used or avoided, reuse of earlier designs.
10. **References:** attached specs, datasheets, sketches, prior boards.

Quality bar, all checked before the intent can be submitted:

- Every topic is answered or explicitly marked "don't care", or "unknown, decide by" a named stage.
- Every quantity has a number and a unit; ranges have both ends.
- No vague words stand alone: "fast", "small", "low power", "robust" and similar are flagged until a number replaces them.
- Every interface is fully specified (type, connector, protocol, rate, direction). The draft panel shows the five fields
  under each interface statement and names the ones not given. Editing an interface statement shows the fields beside
  the words: a field the person changes is kept as typed, and the others are read again from the new words, so fixing
  a missing field never needs an agent's job.
- No internal conflicts: the power budget fits the source, the size fits the connectors, the cost fits the quantity.
- Each statement can become a testable requirement; those that cannot are flagged for rewording.
- Open questions are listed with an owner.

What it produces: the intent document in the project record, and the candidate requirements that open Requirements review.

### Requirements review

The skill walks the person through trace's candidate requirements one at a time, each shown beside the intent line or spec page it came from. For each, the person accepts, edits, merges or strikes it; the skill rewrites vague wording with them until it can be tested.

Steps:

1. **Read the source:** the candidate is shown with the sentence or table row it was drawn from.
2. **Decide:** accept, edit, merge with another, or strike with a reason.
3. **Make it testable:** one criterion per requirement, with a number, a unit, the conditions it holds under, and the method that will verify it (sim, formal, spice, hil, inspection, drc).
4. **Classify:** kind (functional, electrical, timing, emc, mechanical) and priority (must or should).
5. **Resolve conflicts:** the skill pairs requirements that cannot both hold (a power budget and a battery life, a size and a connector count) and asks which one gives.
6. **Cover the intent:** every intent statement maps to at least one requirement, or is marked as covered by none, with a reason.

Quality bar:

- Every accepted requirement has exactly one testable criterion with number, unit, conditions and verification method.
- No two accepted requirements conflict or duplicate each other.
- Every requirement cites its source (intent line, spec page or person).
- Every intent statement is covered or explicitly left out with a reason.
- Struck requirements keep their reason, so a later review can see why.

Produces: the requirements baseline in `requirements`, ready for the baseline gate.

### Architecture choice

The skill sets two or three proposed architectures side by side and has the person score each against the same criteria before choosing. It will not let a choice be made on a single criterion, or on one that was not stated before scoring started.

Steps:

1. **Agree the criteria:** start from cost, risk, part availability, power, size and schedule; the person adds, removes or weights them before seeing any scores.
2. **Read each option:** block diagram, key parts with stock and price, how each requirement is met, and the risks trace sees.
3. **Score:** each option on each criterion, with a one-line reason per score.
4. **Choose and state why:** trace recommends one option, with the scores and evidence behind it and what it gives up; the person takes it or picks another, and states the deciding criteria in their own words. A reason is asked for whenever the choice is not the recommendation, or another option scores higher than it.
5. **Map:** confirm every requirement maps to a block in the chosen option; unmapped ones go back to Requirements review or get a block.
6. **Accept the key parts:** each key part of the option going ahead, with its part number, supplier code, stock against the build quantity and unit price from its newest parts check, follows the in-stock order, or its exception is written.

Quality bar:

- At least two options were compared, unless the person states why only one is possible.
- Criteria and weights were fixed before scoring.
- Every score has a reason; the choice names the criteria that decided it.
- Every requirement maps to at least one block.
- Every key part is in stock for the build quantity or carries a written exception.

Produces: the chosen architecture, the decision record with rejected options, and the key-parts list.

### Schematic finish

The skill takes the person sheet by sheet through trace's drafted schematic, pointing at what the draft left for a person and what it was unsure of. Every push is re-checked, and the skill shows what the person changed from the draft so each change carries its reason.

Steps:

1. **Walk each sheet:** the block it implements, the requirements it serves, and trace's open notes (assumptions, values it could not size, parts it was unsure of).
2. **Resolve the notes:** confirm, correct or replace each one.
3. **Edit in KiCad and push:** trace re-runs ERC, the datasheet-limit check and the BOM check on every push.
4. **Explain the changes:** every difference from the draft (part swapped, value changed, net added) gets a one-line reason.
5. **Clear the findings:** fix or waive each ERC finding and each datasheet conflict (through the Waiver skill).
6. **Check sourcing:** every part has MPN and LCSC fields and follows the in-stock order.

Quality bar:

- No draft note left open.
- Every change from the draft has a reason.
- ERC run on the final push: clean, or each finding waived.
- No datasheet conflict open; each cites its page.
- Every part has MPN and LCSC fields, and is in stock for the build quantity or carries an exception.
- Every sheet names the requirements it serves.

Produces: the finished schematic at a recorded commit, with its change log against the draft, ready for the schematic gate.

### Waiver

The skill runs whenever a person wants to set aside a requirement, a check finding or a test. A waiver is a decision to accept a risk, so the skill makes the person state the risk and where it will be caught instead.

Steps:

1. **Name what is waived:** the requirement, finding or test item, shown with its evidence and trace's recommendation (waive, or fix now) with its reasons.
2. **Give the reason:** why it cannot or need not be met or checked now.
3. **State the risk:** what goes wrong if the reason is mistaken, and how bad that would be (cosmetic, degraded, failure, safety).
4. **Say where it is caught instead:** a later stage, a bench test, or nowhere (accepted for good).
5. **Set the scope:** this revision only, or until a named condition changes.

Quality bar:

- Reason, risk and severity are all given; "not needed" alone is refused.
- A waiver rated safety must name where it is verified instead; it cannot be accepted for good.
- Every waiver names its scope.
- A waiver with a later check creates that check as a test item in the plan.

Produces: a waiver record linked to what it waives; it is listed at every later gate until it closes.

**Withdrawing or correcting a waiver** (src/core/journey.ts `withdrawWaiver`, `withdrawProblem`; the app's components/waiver-actions.tsx). Each waiver in force, wherever it is listed (the Decisions page, the gate), has two actions for its author or an admin; anyone else reads who may. A waiver recorded by answering a question is the person's own and behaves the same.

- **Withdraw** asks why in a sentence, kept in the decisions log with who and when. What it waived counts again: a criterion it covered is not met unless another waiver covers it, and a finding is open again where the rule check is read.
- **Take it again** opens this skill filled in from the waiver, to correct what was wrong (its severity, its reason). Taking the new one withdraws the old one in the same step, and the record keeps both.
- **A signed gate stands on it.** A waiver a live signature acknowledged cannot be withdrawn or taken again, since a signature is never edited: an admin reopens that stage first (return the current gate and reopen it), which takes the signature back, and the gate is signed again on what the record then holds. The refusal says so.

### Board setup

The skill sets up everything trace's placer needs before it can place: the outline, the stackup, the mounting and the parts whose position is fixed by the mechanics. It draws the answers from the intent's physical section and asks only for what is still open.

Steps:

1. **Outline:** size and shape from the intent, corner radii, cut-outs and keep-out zones.
2. **Stackup:** layer count, board thickness, copper weights and dielectric, chosen from JLCPCB's standard stackups unless there is a reason not to; trace shows the impedance each gives for the controlled-impedance nets (`calc.impedance`).
3. **Mounting:** hole positions, sizes and clearances.
4. **Fixed parts:** connectors, switches, LEDs, displays and anything else whose position the enclosure sets, each with its position and side.
5. **Rules:** minimum track, gap, via and annular ring set to what JLCPCB can build for the chosen options.

Quality bar:

- The outline is a closed shape and matches the intent's size limits.
- The stackup states layer count, thickness, copper weights and dielectric, and every controlled-impedance net has a width that meets its target.
- Every fixed part has a mechanical reason (an enclosure drawing, a panel cut-out or a stated position).
- Design rules are within JLCPCB's capability for the chosen options.

Produces: the board file with outline, stackup, rules and fixed parts, ready for trace to place the rest.

### Placement adjust

The skill presents trace's proposed placement as a render with an overlay of blocks, critical nets and its placement findings, and guides the person through moving what is wrong. Each move is re-checked at once so the person sees what it fixed or broke.

Steps:

1. **Review by block:** each block's group, its critical parts (regulators, crystals, high-speed interfaces) and trace's reasons for where they sit.
2. **Check the critical items:** decoupling at its pins, crystal near its pins, switching loops tight, connectors on the edge, thermal parts with room to shed heat.
3. **Move parts in KiCad and push:** the placement check and floorplan re-run on every push.
4. **Explain the moves:** each moved part gets a one-line reason (mechanical, thermal, routing, assembly).
5. **Lock:** the person locks what must not move before routing starts.

Quality bar:

- Every moved part has a reason.
- Placement check passes: no courtyard overlaps, nothing outside the edge or in a keep-out, decoupling within distance; or each finding is waived.
- Fixed parts from Board setup have not moved.
- Parts the router must not move are locked.

Produces: the placed board at a recorded commit, ready for autorouting.

### Case design

The skill builds the board's enclosure with trace (docs/enclosure-cad.md; built as docs/enclosure-build.md describes)
and shows the case as a render beside its fit check. The case is a script in the repository, rebuilt from the board.

Steps:

1. **Process and material:** trace recommends MJF PA12-HP at JLC3DP and says why; the person can pick another print
   process or CNC, within the service's size and wall limits.
2. **Clearances:** 0.5 mm from board edge to wall and 1.0 mm above the tallest part by default; a part that needs more
   room (a mating face, a heatsink) gets its own, with its reason.
3. **Review the case:** the case around the board, its openings and screws; changed by its settings, in chat, by
   editing `mechanical/case.py`, or by handing in a STEP.
4. **Fit check:** every clash and every gap under its clearance, named by part, with the process's design rules.
5. **Order files:** the files to upload and the options, on an order sheet a person submits and pays.

Quality bar:

- Process and material within JLC3DP's limits.
- Every clearance change has a reason.
- Fit check passes, or each clash is waived.
- Within the process's design rules.

Produces: `mechanical/case.json`, `mechanical/case.py`, the case's STEP, STL and 3MF files, the fit check that is the
layout gate's evidence for "the board fits its enclosure", and the order sheet.

### Gate signing

The skill runs at every gate. Because gates are hard and need only one admin's signature, it is the only check before work moves on, so it makes the signer open the evidence rather than sign a summary.

Steps:

1. **See the criteria:** the gate's criteria, each marked met, not met or waived by the checker tool, and trace's recommendation to sign or return, with its reasons.
2. **Open the evidence:** for each criterion, the run or record behind it (a coverage row, a DRC report, a BOM check); the skill records that each was opened.
3. **Acknowledge the waivers:** every waiver taken in this stage, with its reason, risk and where it will be caught.
4. **Note concerns:** anything the signer is uneasy about but will not block on, recorded as a note or an issue.
5. **Sign or return:** sign, or send the stage back with the reasons.

Quality bar:

- The checker tool reports every criterion met or waived; the sign button is disabled otherwise.
- The signer opened the evidence for every criterion and every waiver.
- A return names what must change.
- The signer is an admin on the project.

Produces: the gate record (signer, time, criteria with evidence, waivers acknowledged, notes) and the start of the next stage's work.

### Release review

The skill guides the person through the release report before the release gate, the last point where change is cheap. It reads the report in a fixed order so nothing is skimmed, and ends in Gate signing.

Steps:

1. **Coverage:** every requirement verified or waived, with the waivers listed by severity.
2. **EMC and signal integrity:** prechecks and openEMS estimates against the compliance target, each labelled as a pre-compliance estimate.
3. **BOM:** cost per board and for the build quantity, stock today, lifecycle, and parts with a single source.
4. **Fabrication:** board options, DRC against JLCPCB's capability, assembly coverage (parts JLCPCB can place, parts placed by hand).
5. **Changes since the last revision:** what changed and why, for a revision after the first.
6. **Decide:** release, or return to the stage the concern belongs to; trace recommends one, with its reasons.

Quality bar:

- Each of the five areas is acknowledged in turn, on its own step.
- No requirement is untested; failing requirements block release, and only waivers can stand in.
- Every part with a single source, or not active in lifecycle, is acknowledged. The parts check (`parts.bom_check`) records each line's lifecycle and the sellers that have it in stock; a part it has neither for is shown as not known, and the person checks it.
- The expected cost for the build quantity is stated.
- The decision is made: release, or return to a stage with a note saying what has to change. A return needs only that: the release gate is returned with the note, and the stage it names is reopened.

Produces: the approved release report, which the Release stage stores with the package. The report is the `report.md` of the Verification agent's newest `verify.report` run, read from the record: coverage, the interference prechecks and estimates, the parts list check against the build quantity, and every waiver still open. Its open items say "None" only when nothing is open. The review's evidence names that run.

### Order submit

The skill guides the person through placing the order on JLCPCB's site, since trace prepares the order but never pays. It works from trace's order sheet and checks that what was ordered matches what was released.

Steps:

1. **Re-check stock:** trace re-checks LCSC stock and price for the build quantity; any change since sign-off is shown, and a part now short sends the project back to Sign-off.
2. **Download the package:** Gerbers, BOM and CPL from the release.
3. **Enter the options:** the skill lists each board option (layers, thickness, colour, finish, copper weight, impedance control, quantity, assembly side) for the person to enter on JLCPCB.
4. **Review JLCPCB's part matching:** confirm each BOM line matched the intended LCSC part, and record any part JLCPCB will not place.
5. **Pay and record:** after paying, the person enters the order number, the paid cost and the quoted ship date.

Quality bar:

- Stock was re-checked on the day of the order and every line is available.
- Every option entered matches the order sheet; the person confirms each one.
- Every BOM line matched the intended LCSC part, or the substitute is acknowledged.
- Order number, paid cost and ship date are recorded.

Each step shows what the record holds for it (src/api/order-submit.ts, web/src/components/skills/order-steps.tsx): today's parts check line by line with what changed since the parts check the release was approved on; the package's files (the newest `kicad.fab` run) with the three to upload first, each opening in the app; every option to enter, from the board check (`kicad.board`), the build plan and the package, with the options no record decides marked as JLCPCB's defaults, each ticked as entered; the package's parts list with each line's LCSC part, marked matched or not placed by JLCPCB; and the order gate and the order. Submitted before the order gate is signed, once the options are entered and the parts matched, it meets "The order sheet matches the release" and keeps the draft; after paying, the order is recorded and the skill submitted again.

Produces: the order record, linked to the release; trace tracks it from the order number.

### Bench setup

The skill guides the person through wiring the bench before the first power-on, so trace can drive it safely. It builds the wiring list from the test plan's hardware items and checks each instrument as it is connected.

Steps:

1. **See what the plan needs:** the instruments, buses and probe points the bring-up and hardware tests call for.
2. **Connect and identify:** each instrument is connected and answers its identity query (`hil.idn`); serial and CAN ports are found (`hil.ports`).
3. **Set the supply limits:** voltage and current limits per supply channel, starting from the board's expected draw with a margin, never above the board's absolute maximum.
4. **Wire to the board:** each probe, supply and bus connection matched to its net and test point, confirmed by the person.
5. **Record the bench:** the configuration is saved (`hil.instruments`, `hil.serial`, `hil.can`) so tests reuse it.

Quality bar:

- Every power supply channel has a voltage limit and a current limit, below the board's absolute maximum.
- Every instrument the plan needs answers its identity query.
- Every connection is matched to a named net or test point.
- Hardware use is enabled (`TRACE_HARDWARE=1`) only on this bench machine.

Produces: the saved bench configuration, ready for the bring-up run.

### Bring-up run

The skill steps the person and trace through the first power-on of a new board, one stage at a time, so a fault is caught at the step that exposes it, not after it has damaged something. trace drives the instruments; the person watches, probes and confirms.

Steps:

1. **Inspect:** a visual check for solder bridges, missing or rotated parts and polarity, against the render and placement file.
2. **Unpowered checks:** resistance from each rail to ground, to catch shorts before power is applied.
3. **Power each rail:** one at a time where the design allows, current-limited, with voltage and current read back and compared with the expected values.
4. **Clocks and reset:** oscillators running, reset released.
5. **Firmware:** build and flash (`firmware.*`), then confirm the board talks (serial or CAN).
6. **Run the hardware tests:** the plan's hil items, in order, each recorded as a result against its requirement.
7. **Record failures:** each failure becomes an issue routed to a specialist, with the run evidence attached.

Quality bar:

- Each step passed its limits before the next started; any reading out of limits stops the run.
- No rail was powered with a short reading or without a current limit.
- Every hardware test item has a recorded result (pass, fail, or blocked with a reason).
- Every failure is an issue linked to its requirement and evidence.

Produces: bench results in the coverage matrix and the issues that open the next revision, or the evidence for the revision-accepted gate.

### Question answer

The skill runs when an agent raises a question it cannot answer from the record, the knowledge base or the datasheets. It shows what the agent already looked at and what the question blocks, so the person answers once and in enough detail.

Steps:

1. **See the context:** what the agent is doing, what the question blocks, and the sources it already searched.
2. **Pick or write:** the agent offers its options with the one it recommends and why; choose one, or write an answer.
3. **Make it specific:** a quantity gets a number and unit; a choice names the option; a fact names its source.
4. **Say whether it lasts:** a one-off answer, a rule for the project, or a requirement change. trace adds a rule to `.trace/rules.md` through a change of its own, saying who decided it and which question it answers; every agent follows it from the default branch once the change is accepted, and Settings lists each rule and where it stands. A requirement change goes through Requirements review.

Quality bar:

- The answer resolves what the question blocks; "it depends" or "you decide" is refused unless it names what to decide on.
- Quantities have numbers and units.
- A stated fact cites its source.
- An answer that changes a requirement goes through Requirements review rather than straight into the design.

Produces: the answer on the agent's job, and when it lasts, a rule or a requirement change.

### Design import

The skill brings an existing design into trace and decides where it enters the journey. It shows what trace inferred beside where it inferred it from, so the person corrects the record rather than writing it from nothing.

Steps:

1. **Point at the design:** the KiCad project, plus any firmware, docs and test results in the repository.
2. **Review the inferred intent:** each statement shown with the sheet, part or document it came from; correct it, or mark it unknown.
3. **Review the inferred requirements:** through Requirements review, each marked stated or inferred.
4. **See the assessment:** every gate's checks run against the design as it stands, with pass or fail per criterion.
5. **Confirm the entry stage:** the first failing gate, or Bring up for a board already built; trace recommends the entry stage and says why.

Quality bar:

- Every inferred requirement is confirmed, edited or struck; none stays merely inferred.
- The entry stage matches the first failing gate, or the person states why it should be later.
- Gates before the entry stage are signed on the import evidence through Gate signing.

Produces: an intent, a requirements baseline, an architecture record and gate records for the earlier stages, with the project placed at its entry stage.

### Pin plan review

The skill sits between the schematic and the firmware, so a pin that works on the drawing but cannot carry its function in silicon is found before layout. It shows the MCU as a pin map coloured by function.

Steps:

1. **See the map:** every MCU pin with its net, the function the firmware expects, and the alternate functions the part allows.
2. **Resolve conflicts:** two functions on one peripheral instance, a function on a pin that cannot carry it, a boot or debug pin used for something else, an off-board module whose pin order differs from its connector's; trace proposes a fix for each and says why.
3. **Keep room:** spare pins brought to test points or a header where the person wants them.
4. **Agree:** the schematic and the firmware pin configuration are generated from or checked against the same plan.

Quality bar:

- Every used pin has a net and a function the part supports on that pin.
- No peripheral instance is claimed twice.
- Boot, reset and debug pins keep their roles, and a boot strapping pin something else drives has an external pull
  (not the part's internal pull alone), or the change is waived.
- Every off-board part (a display module, a sensor board, a battery) has the pin order its datasheet gives, pin for pin
  the same as the connector it plugs into, or the difference is waived (a straight cable would reverse its supply).
- The firmware pin configuration matches the schematic.

Produces: the pin plan, checked again after any pin swap in Layout.

### Change request

The skill runs whenever someone wants to change the design on purpose. It shows the cost of the change before anyone commits to it.

Steps:

1. **State the change:** what changes (a requirement, a part, a block, the firmware) and why.
2. **See the impact:** trace follows the traceability chains and shows the stages that reopen, the gates to re-sign, the evidence that goes stale, and the expected cost and time from the running view, with trace's recommendation (approve, reject, or defer to the next revision) and its reasons.
3. **Choose the scope:** this revision (if not yet released) or the next one; hardware and firmware, or firmware only.
4. **Submit for approval:** an admin approves or rejects it through Gate signing.

Quality bar:

- The reason is stated, and a changed requirement goes through Requirements review.
- The impact was shown and acknowledged before submission.
- A change to a released revision opens the next revision; it never edits the released one.

Produces: an approved or rejected change request; on approval, the project returns to the earliest affected stage with stale evidence marked for re-run.

### Incoming inspection

The skill runs when boards arrive from JLCPCB, before any of them are powered. It compares what arrived with what was released.

Steps:

1. **Count:** boards received against boards ordered.
2. **Look:** a photo of each side of each board, compared with the release render; the skill points at areas to check closely (fine-pitch parts, polarised parts, the parts JLCPCB did not place).
3. **Record faults:** bridges, missing or rotated parts, damage, each against its board and reference.
4. **Fit hand-placed parts:** the parts JLCPCB did not place, listed with their positions.
5. **Label:** a serial for each board, so every later result belongs to one board.

Quality bar:

- The count is recorded, and every board has a serial and photos.
- Every fault is recorded against a board and a reference.
- Every part JLCPCB did not place is fitted or marked as not fitted.

Produces: the inspection record per board, and the boards cleared for bring-up.

### Certification run

The skill guides the person through formal compliance testing at an accredited lab. trace prepares everything it can; the person books the lab and attends.

Steps:

1. **Read the test pack:** the standards and classes from the requirements, the test setups, the firmware test modes, and the pre-compliance estimates with their margins.
2. **Book:** the lab, the dates and the test plan agreed with the lab, recorded in trace.
3. **Prepare:** boards and firmware for the test modes, cables and support equipment as the setups list.
4. **Record results:** each test's result against its requirement, with the lab's report attached.
5. **Handle failures:** each failure raises a change request with the lab's data attached.

Quality bar:

- The lab, standard and test setups are recorded before testing.
- Every compliance requirement has a lab result or a change request.
- The lab's report is stored with the results.

Produces: compliance evidence against the requirements, and the Certify gate's record.

### Production release

The skill hands a certified design to volume manufacture. It makes sure the factory can build and test the board without the people who designed it.

Steps:

1. **Review for manufacture:** DFM findings from trace (panelisation, fiducials, part orientation, spacing for volume assembly) fixed or waived.
2. **Review for test:** every requirement that needs a production test has a test point and a test step; programming access is reachable.
3. **Write the procedure:** the manufacturing test and programming procedure, built from the test plan, with pass limits.
4. **Prove it on a golden board:** the procedure run end to end on a known-good board.
5. **Quote:** the volume quote at the production quantity, recorded with its lead time.

Quality bar:

- DFM and DFT findings are closed or waived.
- The test procedure ran on the golden board and every step passed.
- The production files, procedure, programming image and quote are stored together as the production release.

Produces: the production release, and the start of Sustain.

All nineteen are defined in `src/core/skills.ts`. Each check is computed from the record (`src/api/skill-checks.ts`), and the web app runs every skill in Focus mode. A check the record cannot answer yet says so and names what is missing: for example the import assessment in Design import, the bench wiring in Bench setup and the lab's records in Certification run.

## What trace is missing for this journey

This list was drawn up against `main` at commit `b2d6f29` (27 October), when trace was strongest in Prove, Layout and Sign-off, and the journey's ends (Define, Architect, Fabricate) and its spine (stages and gates) were thin. The last column says where each gap stands at `a9a80e6` (30 October): the spine is built; drafting, placement and two of the checks behind the gates are not.

| Gap | Stage | At `b2d6f29` | Needed | At `a9a80e6` |
| --- | --- | --- | --- | --- |
| No notion of stage or gate | All | Work is routed per issue or PR; nothing tracks where a project is | A project state machine with hard gates and gate records (signer, date, evidence, waivers) in the project database | Built: the journey record (`src/core/journey.ts`), kept in the central bucket: stages, gates with their criteria and signatures, waivers and the decisions log; `gate.sign` and `gate.return` |
| No project templates | All | One shape for every project | Board, FPGA, firmware and mixed templates, each with its own stages, and Certify, Produce and Sustain as options | Built: board, FPGA, firmware and mixed, with Certify, Produce and Sustain as options |
| No import of existing designs | Start | Nothing infers intent or requirements from a design | Reverse-building intent, requirements and architecture from a KiCad project; gate assessment to pick the entry stage | Partly: the Design import skill; the assessment that runs every gate's criteria against the imported design is not in the record yet |
| No intent intake | Define | `verify.requirements extract` works from a spec's text by rules | A guided intake that turns a plain-language brief into requirements and questions | Built: the Intent builder skill and the intent record (`design.intent`): statements by topic, open questions with an owner, and each requirement's link to the statements it comes from |
| No architecture agent | Architect | Parts, datasheets and calculators exist; nothing proposes a block diagram or compares options | An architecture step, or a sixth specialist, that writes blocks and maps requirements to them | Built as a record every specialist proposes into (`design.architecture`: options, criteria, scores, blocks and the requirements each serves), chosen through the Architecture choice skill; the sixth specialist is Thermal |
| No schematic drafting | Capture | KiCad tools only read and check | Writing KiCad schematic sheets from the architecture: symbols, MPN and LCSC fields, support circuits, net labels. The largest new build | Not built |
| No datasheet-limit check | Capture | Datasheet params and part fields are readable | A check of each part's operating point against its datasheet limits, cited by page | Not built: the schematic gate names it as the evidence for its datasheet criterion |
| No firmware track before bring-up | Capture to Fabricate | `firmware.build`, `firmware.size`, `firmware.flash` exist | A pin plan checked against the schematic; host unit tests; MCU simulation (Renode is the natural first) | Partly: the pin plan and its check against the schematic's netlist (`design.pins`), and firmware criteria on the gates; no MCU simulation |
| No placement | Layout | `pcb.placement_check` and `pcb.floorplan` only report | A placer that writes footprint positions from the floorplan, respecting parts the person fixed | Not built: the `pcb.*` checks still only report |
| No mechanical fit check | Layout | `kicad.export` writes STEP; `render.model` renders models | A fit-check tool for clearances between the board and the enclosure | Not built; the engine is chosen ([enclosure-cad.md](enclosure-cad.md)) |
| No change requests | All | Changes arrive as issues and PRs with no impact analysis | Change requests that walk the traceability chains and mark stale evidence | Partly: the Change request skill (what changes, why, which revision) hands the request to the agents; nothing walks the traceability chains or marks evidence stale yet |
| No release object | Release | `kicad.fab` writes a package to a folder | A release record: revision, package, frozen BOM, approving report, git tag | Partly: signing the gate the Release stage follows copies the record into the repository on a `trace/release-…` branch, and Build lists each release by revision and commit; no frozen BOM or git tag yet |
| No order preparation or inspection | Fabricate | `kicad.fab` writes JLCPCB files | A JLCPCB order sheet, order tracking by order number, and incoming inspection records per board serial | Mostly built: orders recorded by people and followed by DHL tracking, and boards by serial with their incoming inspection (`board.record`, `board.check`); the order sheet reads its board options from the release package's run (`kicad.fab` records them, JLCPCB defaults marked as not decided) and its parts from the newest parts check at the build quantity, and says "ready to place" only once both are met; its cost is the build plan's target, said as such, as no quote is recorded yet |
| No bring-up checklist | Bring up | `hil.*` and `firmware.*` exist; `verify.plan` supports hil items | A staged power-on sequence with limits and stop conditions, built from the plan | Partly: bring-up readings against each step's limits, checked by the Bring-up run skill (the unpowered step first, a current limit on every rail); linking each failure to its issue is not in the record yet |
| No revisions | All | One design, versioned by git only | Revisions that carry requirements, waivers and results forward | Partly: stages, signatures, orders and releases carry their revision (A first), and returning a gate can reopen an earlier stage; nothing opens the next revision or carries requirements, waivers and results forward yet |
| Nothing after acceptance | Certify to Sustain | Pre-compliance estimates only | A lab test pack, DFM and DFT review, a manufacturing test procedure, and a scheduled lifecycle watch | Partly: Certify, Produce and Sustain are optional stages, Certify and Produce with their gates; the lab test pack, DFM and DFT review, manufacturing test procedure and lifecycle watch are not built |
| No cost or schedule view | All | Run records hold no cost; nothing records stage times | A ledger of spent, committed and forecast cost (with AWS cost-allocation tags per project) and stage timing with waits | Built: the cost ledger per project, priced from the AWS price list, with Cost Explorer's actuals and the stage timeline (`cost.get`, `usage.month`) |
| No screen follows the live updates yet | All | Job status and tools' waits can be held until something changes (the API's `job` and `tools.waits`), with each wait's line and Check now; nothing shows them yet | The web app follows them: each wait's line, a countdown to its next check, and a Check now button | Built: the web app's Wait line and live connection (`web/src/components/wait-line.tsx`, `web/src/lib/live.ts`) |

## Decisions

Decided with Marc on 27 October 2026; the stages and gaps above reflect them.

| Question | Decision | What follows |
| --- | --- | --- |
| Who draws the schematic? | trace drafts, a person finishes | Schematic drafting becomes the largest new build |
| Who places parts? | trace proposes, a person adjusts | A placer that respects parts the person fixed |
| How strict are gates? | Hard everywhere | Agents queue the next stage but do not start it |
| Who signs a gate? | Any admin, one signature | No second signature, even on Release and Order approval |
| First fab and assembler | JLCPCB | Builds on the files `kicad.fab` already writes |
| Does trace order? | Prepares only; a person submits and pays | No payment handling in trace |
| Fixed or per-project journey? | Templates per project type | Board, FPGA, firmware and mixed |

## Glossary

The terms trace explains when a person taps them. Each definition is the one-line version shown in the app.

| Term | In plain words |
| --- | --- |
| ADC | Analogue-to-digital converter: the part of a chip that turns a voltage into a number |
| BOM | Bill of materials: the full parts list for a board, with quantities and part numbers |
| CISPR 32 | The international standard for the radio interference electronic equipment may give off |
| CPL | Component placement list: where each part sits on the board, for the assembly machine |
| DFM | Design for manufacture: checking a board can be built reliably in volume |
| DFT | Design for test: making sure each board can be tested in the factory |
| DRC | Design rule check: KiCad's check that the board layout obeys its spacing and size rules |
| EMC | Electromagnetic compatibility: not causing, and not suffering from, radio interference |
| End of life | A part the maker has stopped making, or soon will |
| ERC | Electrical rule check: KiCad's check that the schematic's connections make sense |
| Gerbers | The files a board maker uses to make the bare board, one per layer |
| HIL | Hardware in the loop: tests that run against the real board on the bench |
| JLCPCB | The board maker and assembler trace prepares orders for first |
| KiCad | The open-source electronics design program trace reads and writes |
| LCSC | JLCPCB's parts supplier; its part codes tell JLCPCB which part to fit |
| LDO | Low-dropout regulator: a simple part that lowers a supply voltage to a steady level |
| MCU | Microcontroller: the small computer chip that runs the firmware |
| Monte Carlo | Running a simulation many times with parts varied within their tolerances, to see the spread of results |
| MPN | Manufacturer part number: the maker's own code for a part |
| Pin plan | Which job each pin of the microcontroller does, agreed between schematic and firmware |
| RF | Radio frequency: the radio side of a design, such as the antenna and its matching parts |
| SPICE | The standard way to simulate an electronic circuit before building it |
| STEP | A 3D file format used to share models of boards and enclosures |
| SWD | Serial wire debug: the connection used to load and debug firmware on an Arm chip |
| UART | A simple two-wire serial connection, often used for log messages |
