mteichtahl/trace/docs/external-access.md

# External access: letting other systems talk to trace

Status: built, October 2026: merged to `main` on 28 October from the branch `claude/external-access`.

## Summary

Other systems reach trace through **connected systems**: an admin creates one per outside system, gives it a name,
what it may do (read, or read and write) and which projects it is on (as a contributor or a reviewer, like a person).
trace gives back a client id and a secret, shown once. The system swaps them for a short-lived token at the
installation's sign-in address and calls trace in one of two ways:

| Way in | For | Address | Speaks |
| --- | --- | --- | --- |
| **External API** | scripts, pipelines, other services | the `external` runtime's `/invocations` | the same `{ action, ...args }` JSON as the people's API |
| **MCP endpoint** | AI agents and MCP clients | the `mcp` runtime's `/invocations` | MCP (streamable HTTP), one tool per allowed action |

Both are off until an admin turns on **External access** in the installer (`external.enabled`). With it off nothing
below exists in the account. With it on but no connected systems, nothing can get in: every token must come from a
connected system that is enabled.

People keep using the existing API runtime and web app. Nothing about how a person signs in changes.

```
  outside system ──client id + secret──▶ Cognito /oauth2/token ──access token (1 h)──┐
                                                                                      │ Bearer
           ┌──────────────────────────────────────────────────────────────────────────┤
           ▼                                                                          ▼
  trace-external (AgentCore, HTTP)                                   trace-mcp (AgentCore, MCP)
    authorizer: scope trace-external/read|write                        authorizer: same scopes
    verifies again; looks up the connected system                      no AWS permissions of its own
    perform(action) with the system's principal  ◀──── forwards each tool call with the caller's token
    (the API's code and checks, its own role:
     no Cognito, only what systems' actions need)
```

## Decisions

Each has the recommendation that was taken, and the alternative not taken.

| Decision | Taken | Why | Not taken |
| --- | --- | --- | --- |
| How a system proves who it is | OAuth client credentials: one Cognito app client per connected system, with a secret | The standard for machine-to-machine; every MCP client and HTTP library supports it; Cognito rotates secrets (two at a time) and revokes by deleting the client | API keys stored by trace: a second credential system to build and secure; signing in as a "robot person": passwords and refresh tokens, and no scopes |
| Where systems come in | Two new AgentCore runtimes, `external` and `mcp`, beside the people's API runtime | The people's runtime keeps its exact authorizer (its two app clients). A mistake in the new door can't lock people out | Widening the people's runtime's authorizer to scopes: one door for both, but a fault there stops every person |
| How the MCP endpoint enforces access | It forwards every tool call to the `external` runtime with the caller's own token | One place decides access (the `external` runtime, running the API's `perform`); the MCP runtime holds no AWS permissions | Running `perform` in the MCP runtime too: one hop less, but a second copy of the API role to keep tight |
| What the `external` runtime may do in AWS | A role of its own, made by the same function as the API's (`src/infra/api-grants.ts`) with only what the actions open to systems touch, and no Cognito at all | It faces the internet: a bug in the allow-list must not hand an outside system the people's admin powers (creating people, changing groups, signing people out, managing app clients) | Running it with the API's role: one role less, but every Cognito admin action one bug away from the internet |
| Library gateway | Unchanged | It runs with its own role and can't tell callers apart, so it stays internal (README "Library gateway") | Opening it to systems: it would reach the shared library for anyone with a token |
| What a system can be on | Projects, with a part, exactly like a person; never an admin | The existing access model applies unchanged: a reviewer reads, a contributor writes; a project it's not on does not exist for it | A per-system policy language: more to learn, and a second model to audit |
| What a system can do at all | A fixed list of actions (below), further limited by its scopes | Some actions are a person's by nature: signing gates, answering questions asked of a person, waivers, decisions, orders, chats, preferences. An allow-list fails closed when new actions are added | A deny-list: every new action would be open to systems by default |
| Revocation | Disabling a system stops it at once; deleting it also deletes its Cognito client | The `external` runtime checks the access store on every call (cached 30 s), so a disabled system's tokens stop working within 30 seconds, not when they expire | Waiting for the token to expire (up to an hour) |
| Secrets | Shown once, never stored by trace. Rotation adds a second secret; the old one is removed when the admin says so | Cognito holds the secret; nothing to leak from trace's stores | Keeping secrets in Secrets Manager for later display: a store of every outside system's keys |
| Token lifetime | 1 hour; systems should reuse a token until it nears expiry | Cognito charges per machine-to-machine token request; reuse keeps cost near zero | 5 minutes: safer if leaked, but twelve times the requests |
| Address | The AgentCore runtime URLs, given in full on the admin screen with copy buttons and ready-made snippets | Works with no extra infrastructure | A friendly `/api/external` and `/mcp` on the web app's address through CloudFront: a later step, noted below |

## Connected systems

A connected system is a row in the access store (`services` table) plus a Cognito app client:

| Field | Meaning |
| --- | --- |
| `client_id` | the Cognito app client id; also the system's `sub` (Cognito sets a client-credentials token's `sub` to its client id) |
| `name` | a short name, unique, `^[a-z][a-z0-9-]{1,39}$` (for logs and the app: "service:ci-dashboard") |
| `description` | what it is for, up to 500 characters |
| `scopes` | `read`, or `read` and `write` |
| `disabled` | stops it at once |
| `created_by`, `created_at` | for the audit trail and the admin screen |
| last used | not a column: one small object per system beside the store, `access/services-seen/<client_id>.json` (below, "External API") |

Its project assignments live in the existing `assignments` table, keyed by its `sub`, with a part. Its class is
derived, never stored as admin: a system with the `write` scope counts as a **user** (so it can be a contributor), one
with only `read` counts as a **guest** (always a reviewer). Taking `write` away writes every part it holds down to
reviewer (logged as a part change), and the class caps it at every check besides. The assignment log records every
change, as for people; the system's own changes (connected, scopes, disabled, secrets added and removed, deleted, never
a secret's value) go to a `service_log` table beside it. `classOf` never answers admin for a service principal,
whatever groups it carries.

Cognito side: one resource server `trace-external` with scopes `read` and `write`, created by the stack. Each
connected system's app client is created by the API runtime when an admin asks (`CreateUserPoolClient`, client
credentials only, a secret, the chosen scopes, access tokens of one hour), named `<prefix>-svc-<name>`.

## The principal

A verified service token becomes a `Principal` like a person's, with two more fields:

```ts
{ sub: client_id, email: null, groups: ['trace-users'] | ['trace-guests'], kind: 'service', name: 'ci-dashboard',
  scopes: ['read'] | ['read', 'write'] }   // scopes: the token's, within what the system has now
```

`src/api/service-auth.ts` (`ServiceVerifier`) builds it: `Verifier.verifySigned` checks signature, issuer, time and
`token_use` without a client list, and the access store decides the client. `whoami` answers `kind`, `name` and
`scopes` for a system.

So every existing check (`require_`, `partIn`, `projectsFor`, the `job` ownership check) works unchanged. Logs and
records show `service:<name>` where they would show a person's email. A token is accepted only when all of these hold:

1. signature, issuer and time, as today (`src/api/jwt.ts`);
2. `token_use` is `access`, there is no `username` claim (a person's token always has one), and `scope` contains
   `trace-external/read` or `trace-external/write`;
3. `client_id` is a connected system in the access store, and it is not disabled;
4. the token's scopes are a subset of the scopes the system has now (an admin who removed `write` is obeyed at once).
   Write always brings read: a token that asked for `write` alone is given both, as the store holds them.

## What a system may do

The allow-list (`SERVICE_ACTIONS` in `src/api/service-policy.ts`) and the scope each needs. Anything not here answers
"no access", the same words as a project that isn't yours.

| Scope | Actions |
| --- | --- |
| `read` | `whoami`, `projects`, `installation.layout`, `status`, `settings.get`, `runs`, `run`, `artifact`, `jobs.list`, `job`, `journey.get`, `requirements.trace`, `design.get`, `build.get`, `cost.get`, `files.list`, `files.url`, `graph.neighbourhood`, `ontology.describe`, `record.get`, `artifact.lineage`, `artifact.stale`, `kb.search`, `tools.list`, `tools.waits`, `tool` (read-only tools) |
| `write` | `task` (at most 3 queued or running per project), `job.control` (its own jobs), `settings.set` (opens a pull request a person merges), `kb.sync`, `tool` (tools that record runs) |

The ontology's four (`src/api/actions-ontology.ts`, docs/ontology.md) let a system read trace's records the way
trace names them: `ontology.describe` lists every class and property in plain words, with its Si2 alignments (with
`term`, one term and the tables that store it); `record.get` gives one record of a project as JSON-LD, named by its
identifier (`urn:trace:…`) or as `<kind>:<key>` (`requirement:REQ-001`, `criterion:capture.erc`); `artifact.lineage`
gives what a run was made from, what it made and the runs made from that; `artifact.stale` says whether the newest
run of each tool still stands against the default branch's files, and why not.

`tool` never runs the tools of the shared datasheet library or the parts search (`parts.*`, `datasheets.*`,
`SHARED_TOOL_PREFIXES`), whatever the scope: they read and write the library every project shares, and the parts
search spends the installation's paid distributor quota. `tools.list` leaves them out for a system and the MCP tools'
descriptions never offer them; a person still uses them as before.

`task` by a system is refused, in words, when it already has three tasks queued or running on that project ("This
system already has 3 tasks running on owner/repo. Wait for one to finish."), counted from the project's job index
(`taskCap`). A running job whose heartbeat stopped is not counted, so a lost one never blocks a system for good.

Never, whatever the scope: anything that needs an admin; signing or returning gates; answering questions; waivers;
design decisions; orders; chats; preferences and `me.*`; memory; prompts; skills; people and assignments; voice; the
inbox. These are a person's by the rules in `docs/user-journey.md` (gates are signed by a person; trace prepares orders
and a person submits them).

The scope is checked first, then the project part, so `write` on a project where the system is a reviewer still reads
only. In `perform` (`src/api/actions.ts`) a service principal is refused an action off the list before its arguments
are parsed, then the scope is checked on the parsed arguments (`tool`: by the tool), then the usual access check runs;
so the policy holds wherever a service principal comes from. A test enumerates every action not on the list and checks
it is refused to a system with both scopes. `job.control` by a system also needs write on the job's project and the job
must be one it started (the job index's `requestedBySub` is its client id).

## External API

`POST /invocations` on the `external` runtime, exactly the people's API contract (`src/api/server.ts`): body
`{ action, ...args }`, `Authorization: Bearer <access token>`, answers `{ ok, result | error }`, 401 for a token that
isn't accepted, 403 `no access`. `GET /ping` for health. One difference: an unexpected error answers
`internal error (ref <8 hex digits>)`, and the detail is only in the runtime's log, on the line with that `ref`; the
people's runtime still says what went wrong.

Same code: `TRACE_AGENT_MODE=external` starts the API server (`startExternal` in `src/api/server.ts`, the same handler
with the principal resolution injected) with the service verifier in place of the people's. It runs with its own role
(below, "Infrastructure") and reads the API runtime's environment plus `TRACE_EXTERNAL_RESOURCE_SERVER` (default
`trace-external`) and `TRACE_RATE_TABLE`; services.* answer "External access is off" there (a system is never an admin
anyway, and the role could not do them).

Request limits, per system, in two lines (`src/api/rate-limit.ts`); over either, 429 with `Retry-After`:

- **In the container**: a token bucket, 10 requests a second bursting to 20. Cheap, and it turns a flood away before
  anything else is asked. On its own it would not be enough: AgentCore starts a container per runtime session, and the
  caller picks the session id, so a system that sends a new one with every request reaches a fresh container each time.
- **Shared, across every container**: fixed windows counted in DynamoDB (`<prefix>-external-limits`,
  `TRACE_RATE_TABLE`): at most 10 requests in any one second and 300 in any one minute. Each window is one item
  (`<client_id>#s#<second>`, `<client_id>#m#<minute>`), counted with `UpdateItem ADD n :1` on the condition
  `attribute_not_exists(n) OR n < :limit`; a refused condition is the limit (`Retry-After` 1 s, or the rest of the
  minute). Items expire by TTL a few minutes after their window. **When DynamoDB itself fails** (throttled,
  unreachable, the table missing) the request goes ahead (**fail open**) and the runtime logs it once, then again
  only after it has answered and failed anew. The limit protects capacity and cost, not access (the verifier and the
  allow-list decide that on every call); failing closed would let an outage of the counter shut every system out,
  and the container's bucket still holds.

Every request is logged as the API logs (who is `service:<name>`). When a system last called is written as one small
object per system beside the access store, `access/services-seen/<client_id>.json`, with a plain put, at most once
every five minutes per system per container; `services.list` reads them. Never a write to the access store on the
request path: its writes are a download, a change and a conditional put, and racing them from every fresh container
could make people's admin changes fail.

The API copies a project's database from GitHub to read it. In the external runtime those copies go in a fresh
temporary folder under `/tmp/trace-external/svc-<hash of the client id>/`, never in the session storage
(`/mnt/workspace`): AgentCore keeps that per runtime session id, which the caller chooses, so two systems sending the
same id would otherwise share it.

## MCP endpoint

`TRACE_AGENT_MODE=mcp` on an AgentCore runtime with the MCP protocol: a stateless streamable-HTTP MCP server on
`0.0.0.0:8000/mcp` (what AgentCore requires).

- **Tools**: one per allowed action the caller's scopes permit, named `trace_<action>` with dots as underscores
  (`trace_journey_get`), described in plain words (`src/mcp-remote/descriptions.ts`), with an input schema made from
  the action's zod arguments (`z.toJSONSchema`). `tools/list` hides write tools from a read-only system.
- **Calls**: forwarded to the `external` runtime with the caller's own bearer token
  (`src/api/runtime-url.ts`), and the answer returned as pretty JSON text (cut above about 200 KB, saying so). An
  `ok: false` answer (and a 429) is a tool result with `isError` set, so the model reads it and adjusts. A 401 or 403
  becomes an MCP error ("not allowed: …"). Timeout 120 s. The runtime session id sent onward is a hash of the token's
  `client_id` claim and the client's `mcp-session-id` when it sends one, else random; never the client's own id, so
  two systems that pick the same MCP session id never share a runtime session (or its storage).
- The token's `scope` and `client_id` claims are read **unverified**, only to shape `tools/list` and the session id
  (AgentCore's authorizer has checked the token before the request arrives); access is decided by the `external`
  runtime on every call.
- The runtime's role can write its own logs and traces and nothing else; it makes no AWS call. It finds the `external` runtime
  from `TRACE_EXTERNAL_RUNTIME_ARN` and `AWS_REGION` (`invocationUrl`), or `TRACE_EXTERNAL_URL` when set (an override).
  `GET /ping` answers health.

Connecting an MCP client (Claude Code, for example):

```json
{ "type": "http", "url": "<mcp url>", "headers": { "Authorization": "Bearer <access token>" } }
```

Clients that do OAuth themselves are pointed at the token address with the client id and secret.

## Managing connected systems

API actions, admins only:

| Action | Arguments | Result |
| --- | --- | --- |
| `services.list` | | `{ enabled, services, token_url, api_url, mcp_url, resource_server }`: every system with its scopes, projects and parts, disabled, last used (to within about five minutes), and `secrets: [{ id, created_at }]` (never a value) |
| `services.create` | `name`, `description?`, `scopes`, `projects?: [{ repo, part? }]` | `{ service, client_id, secret (only here), token_url, api_url, mcp_url, resource_server, scope }`; the app client is deleted again if the record cannot be written |
| `services.update` | `name`, `description?`, `scopes?`, `disabled?` | `{ service }`; a scope change updates the app client (full configuration); down to read only, every part becomes reviewer |
| `services.assign` | `name`, `repo`, `part?` | `{ name, repo, part, … }` (a read-only system is always a reviewer) |
| `services.unassign` | `name`, `repo` | `{ removed }` |
| `services.rotate` | `name` | `{ secret, secret_id, … addresses }`, shown once; the old one keeps working |
| `services.retire_secret` | `name`, `secret_id` | `{ removed: true }`; never the last secret |
| `services.delete` | `name` | `{ deleted, app_client: 'deleted' \| 'already gone' }`: disables the system first, then deletes the Cognito client (already gone: fine), then the record and every assignment; logged. A failure part way leaves it disabled, never still let in |
| `services.history` | `name` | `{ entries: [{ at, by, action, repo, detail, text }] }`: its assignment log and its own log, newest first, in words |

With external access off (no `TRACE_EXTERNAL_RUNTIME_ARN` on the API runtime), every one but `list` and `history`
answers "External access is off for this installation. Turn it on in the installer (External access)."

App clients are created with `GenerateSecret`, `AllowedOAuthFlows: ['client_credentials']`,
`AllowedOAuthFlowsUserPoolClient: true`, `AllowedOAuthScopes` (`<rs>/read`, and `<rs>/write`), `AccessTokenValidity: 60`
with `TokenValidityUnits.AccessToken: 'minutes'`, `ExplicitAuthFlows: ['ALLOW_REFRESH_TOKEN_AUTH']`,
`PreventUserExistenceErrors: 'ENABLED'`, `EnableTokenRevocation: true`. `UpdateUserPoolClient` resets whatever is left
out, so every update sends that whole configuration again (`serviceClientBody` in `src/api/aws.ts`).

The same from the command line: `tracectl services create NAME --scope read|write --project OWNER/REPO[:reviewer]`,
`list`, `show`, `disable`, `enable`, `assign`, `unassign`, `rotate`, `retire-secret`, `delete`.

In the web app: **Admin → Connected systems**, a table (TanStack, like People) and a create sheet. After creating,
one screen shows the client id and the secret with copy buttons and the words "This secret is shown once", the token,
API and MCP addresses, and three ready-made snippets: get a token with curl, call the API, and add the MCP endpoint
to an MCP client. Each system's page shows its projects and parts, scopes, last used, secrets (by id and date, never
the value), its history, and Disable, Rotate secret and Delete (with a typed confirmation).

### A leaked secret

Disable the system first (it is shut out within 30 seconds, whatever its tokens), then rotate (a new secret), retire
the old secret, give the new one to the system, and enable it again. Rotating alone is not enough: the old secret keeps
working until it is retired, and a token already issued with it lasts up to an hour, which disabling stops. The admin
screen's Keys section and `tracectl services rotate` say the same.

## Infrastructure

Only with `external.enabled` (`src/infra/external.ts`, the `ExternalAccess` construct; the installer's **External
access** switch). With it off the template is the same as without the feature (`test/infra/external.test.ts`).

- A Cognito resource server on the people's pool, identifier `trace-external`, scopes `read` ("read the projects the
  system is on") and `write` ("start work and change settings on the projects the system contributes to").
- `CfnRuntime` `<prefix>_external` (dashes become underscores, as for `<prefix>_api`): the agent image, its own role
  `<prefix>-agent-external-<region>` (below), HTTP protocol, the API's network, session limits and file system,
  `Authorization` passed through. Authorizer
  `{ discoveryUrl (the API's), allowedScopes: ['trace-external/read', 'trace-external/write'] }`, with no
  `allowedClients`: connected systems' clients are made at run time, and AgentCore requires every configured check to
  pass. Its environment is the API's (built once in `stack.ts`) with `TRACE_AGENT_MODE=external`, plus
  `TRACE_TOKEN_URL`, `TRACE_EXTERNAL_RESOURCE_SERVER` and `TRACE_RATE_TABLE` (the rate-limit table). It is never told
  its own ARN or the MCP runtime's.
- `CfnRuntime` `<prefix>_mcp`: same image, MCP protocol, the same authorizer, its own role `<prefix>-agent-mcp-<region>`
  (pull the agent image, write its own runtime's logs, X-Ray spans, `cloudwatch:PutMetricData` in the
  `bedrock-agentcore` namespace, and the span destination's `logs:PutResourcePolicy`; nothing else). Environment:
  `AWS_REGION`, `TRACE_AGENT_MODE=mcp`, `TRACE_PREFIX`, `TRACE_EXTERNAL_RUNTIME_ARN` (the external runtime: the code
  makes its address with `src/api/runtime-url.ts`), `TRACE_EXTERNAL_RESOURCE_SERVER`, `TRACE_COGNITO_ISSUER`,
  `TRACE_TOKEN_URL`, and the observability settings every runtime gets. It listens on port 8000; `TRACE_EXTERNAL_URL`
  overrides the address when set.
- The external runtime's role, `<prefix>-agent-external-<region>`: `grantApiRuntime` in `src/infra/api-grants.ts`, the
  function that also makes the people's API role, without what only people's actions need. Traced from each allowed
  action: pull the image, its own runtime's logs and spans, the GitHub token, the access store read only (the
  verifier's lookup, `projects`), `PutObject` on `access/services-seen/*` only (last used, below), each project's
  journey record (read, conditional writes: its first import, `job.control`'s holds), the agents' facts, job index
  and bench (read), the shipped orders' watches (read: `build.get`'s wait lines), the memory records and their inactive
  marks (read: `graph.neighbourhood` with `memory`), Retrieve on the knowledge bases, `InvokeAgentRuntime` on the
  workers, and `dynamodb:UpdateItem` on the rate-limit table. **No `cognito-idp:*` at all**, nothing of the central
  database, prompts, chats, pending projects, cost actuals, the order watch or its key, integrations or dictation.
- A DynamoDB table `<prefix>-external-limits` (on demand, TTL attribute `ttl`): the shared rate limit's counters
  (below). Only the external role may update it; it holds nothing worth keeping and is deleted with the stack.
- The people's API role gains one statement, `ManageConnectedSystemClients`: `cognito-idp:CreateUserPoolClient`,
  `UpdateUserPoolClient`, `DeleteUserPoolClient`, `AddUserPoolClientSecret`,
  `DeleteUserPoolClientSecret`, `ListUserPoolClientSecrets` on the pool's ARN. Nothing else of it changes. Under that
  grant the code holds a backstop (`HttpCognito` in `src/api/aws.ts`): a new client must be named
  `<prefix>-svc-<name>`, and every other of those calls must name a client that is a connected system in the access
  store, with the name its record gives (one exception: `services.create` may delete a client it has just made, before
  its record exists). So a bug in `services.*` can never change or delete the people's CLI or web client.
- The people's API runtime gets `TRACE_EXTERNAL_RUNTIME_ARN`, `TRACE_MCP_RUNTIME_ARN`, `TRACE_TOKEN_URL`
  (`<the pool's domain>/oauth2/token`) and `TRACE_EXTERNAL_RESOURCE_SERVER` (it has `TRACE_PREFIX` already), so
  `services.create` can give the addresses.
- Outputs: `ExternalApiUrl` and `McpUrl` (the full invocation URLs,
  `https://bedrock-agentcore.<region>.amazonaws.com/runtimes/<ARN, ':' and '/' encoded>/invocations?qualifier=DEFAULT`,
  made in the template with `Fn::Split`/`Fn::Join`: what `encodeURIComponent` makes of a runtime ARN), `TokenUrl`,
  `ExternalResourceServer`.
- Observability: both runtimes join the dashboard and get `ExternalLogGroup` and `McpLogGroup` outputs, as the API's
  `ApiLogGroup`.
- Names: the prefix must make runtime names AgentCore accepts (`^[a-zA-Z][a-zA-Z0-9_]{0,47}$`); the settings refuse one
  that doesn't, rather than cutting it short. Every prefix the settings accept (21 characters at most) fits.

## Cost

AgentCore runtimes cost nothing while idle. Cognito charges for machine-to-machine use per app client and per token
request: a system that reuses its token for the hour makes about 720 requests a month. The admin screen says so beside
**Create**.

## Later

- A friendly address on the web app's domain (CloudFront `/api/external/*` and `/mcp`), so systems don't see AgentCore
  URLs.
- People connecting their own MCP clients (Claude, for example) with their own sign-in, through OAuth authorization
  code on the CLI's hosted domain. Today a person uses `tracectl mcp` locally.
- Events out: webhooks to a connected system when a gate is signed or a job finishes, from the journey events that
  exist already.
