mteichtahl/trace/web/src/mock/docs/high-level-design.pdf

HIGH LEVEL DESIGN

# Soil sensor

Revision B · 2026-11-05

Made by trace from the project’s records at commit a41e9d0c2b17

Every figure and value in this document names the record it came from. A value marked pending has not been worked out yet.

Soil sensor · High level design · Revision B

## Revisions

Revision | Date | Commit | What changed
A | 2026-10-21 | 9c02e1f | First release
B | 2026-11-05 | a41e9d0 | Released

## Contents

## 1 Overview

The soil sensor measures soil moisture and temperature in a field and reports them over a long-range radio (LoRa) link to a gateway every 15 minutes. It runs for two years on two AA cells and sits in a sealed printed case on a stake.

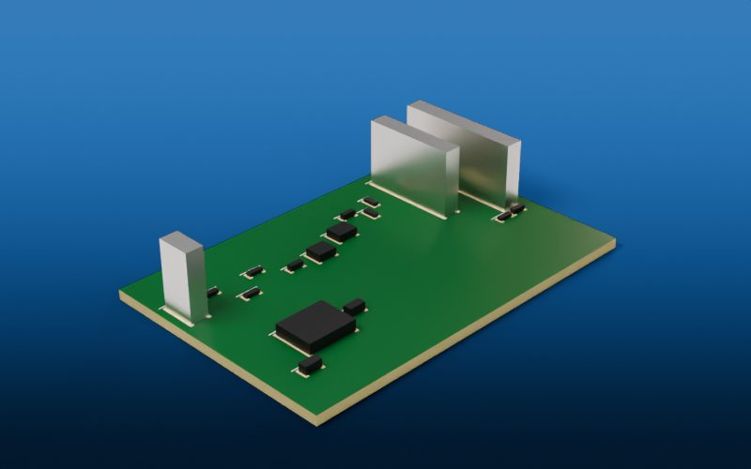
[picture p52: figure]

Figure 1: The populated board, Rev B, from the front left.

Commit a41e9d0c2b17 | Page 1 of 3

## 2 System context

Figure 2: What the sensor talks to: the probe in the soil, the gateway over the radio, and a laptop over USB-C when it is set up.

## 3 Requirements

Id | Requirement | Status
R-001 | Reports moisture within 3 % volumetric water content | accepted
R-002 | Runs two years on two AA cells | accepted
R-004 | Runs from one lithium cell, 3.3 V out | verified
R-006 | Reaches a gateway 2 km away in open field | accepted

## 4 Architecture

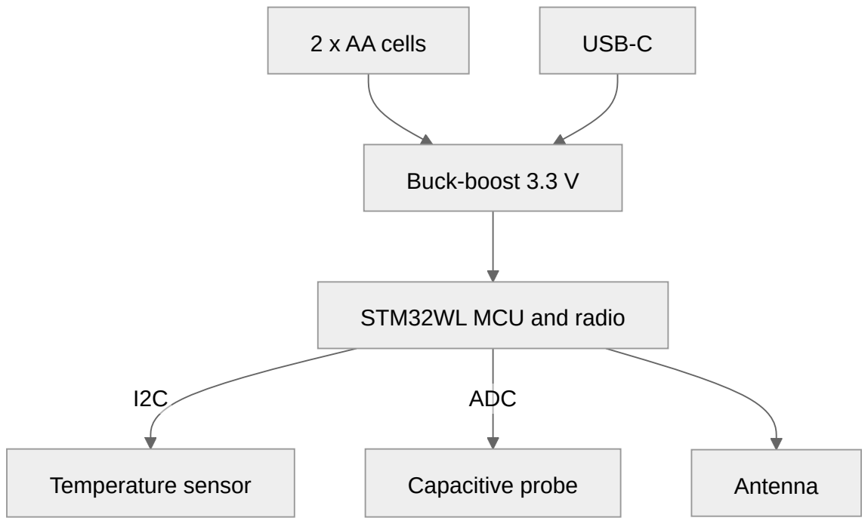
[picture p53: figure]
ADC; 2 x AA cells; Buck-boost 3.3 V; USB-C; STM32WL MCU and radio; Temperature sensor; Capacitive probe; Antenna

Figure 3: The board’s blocks: power from the cells or USB-C, one microcontroller with its own radio, and the two sensors.

## 5 Data flow

Probe reading | Average of 8 | Frame: moisture, temperature, battery
LoRa uplink | Gateway

Figure 4: How one reading becomes one uplink every 15 minutes.

## 6 Key parts

Pending: The key parts, why each was chosen, and their stock.

## 7 Power and thermal summary

Pending: The power budget at a glance and the tightest margins.

## 8 Mechanical summary

Pending: Size, mounting and the case, with the in-case render.

## 9 Journey

Define | Architect | Capture | Prove | Layout

Figure 5: Where the project is: Capture, with the schematic being finished.

## 10 Decisions

- One chip for the controller and the radio (STM32WL55): fewer parts and lower sleep current than a separate radio.
- Buck-boost regulator (TPS63900): keeps 3.3 V from fresh cells down to 1.8 V.

## 11 Risks and open questions

Pending: What could still go wrong and who owns each open question.

## 12 Glossary

Pending: Every acronym and term used in this document.
