mteichtahl/trace/web/src/mock/renders/board-bottom.jpg

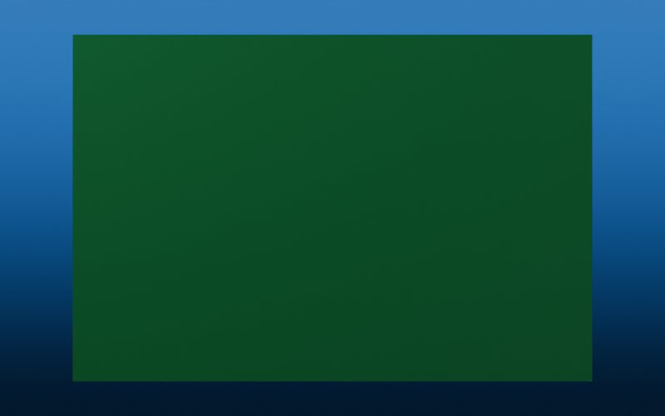
web/src/mock/renders/board-bottom.jpg
