mteichtahl/trace/web/src/mock/renders/board-in-case.jpg

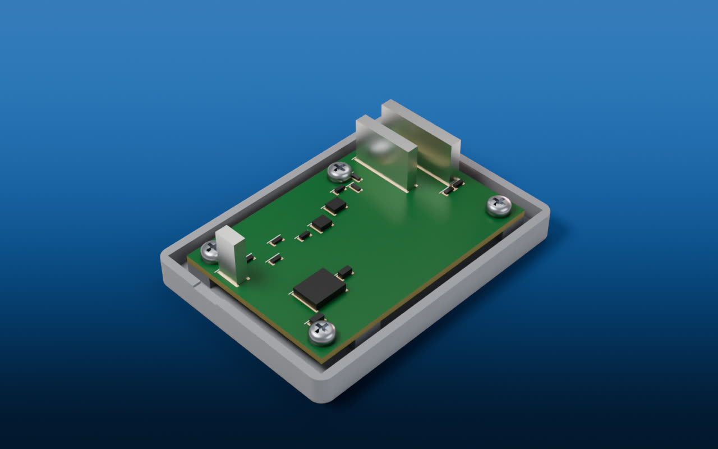
web/src/mock/renders/board-in-case.jpg
