mteichtahl/trace/web/src/mock/renders/board-top.jpg

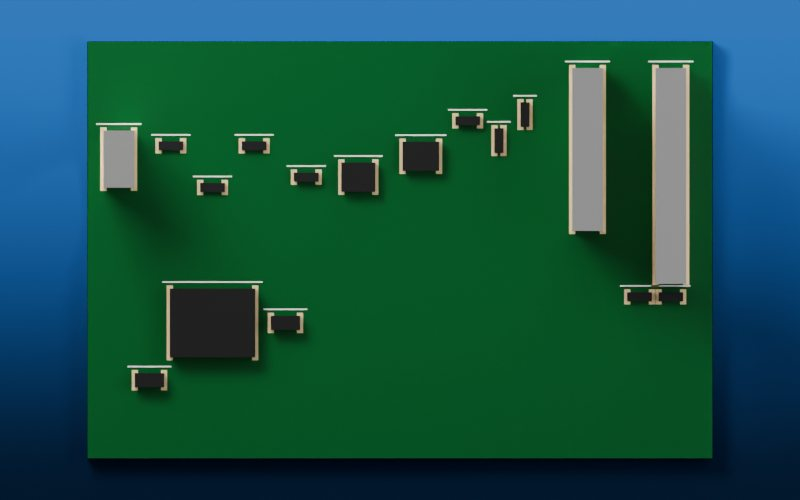
web/src/mock/renders/board-top.jpg
