mteichtahl/trace/web/src/mock/renders/case.jpg

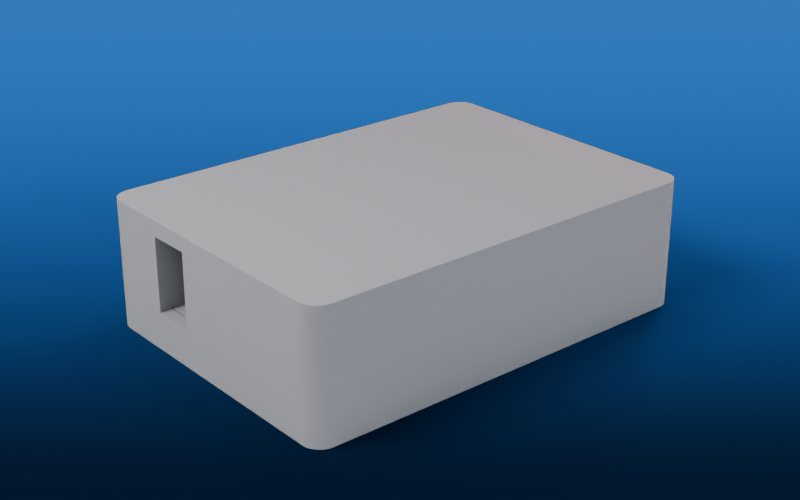
web/src/mock/renders/case.jpg
