mteichtahl/trace/web/src/mock/renders/exploded.jpg

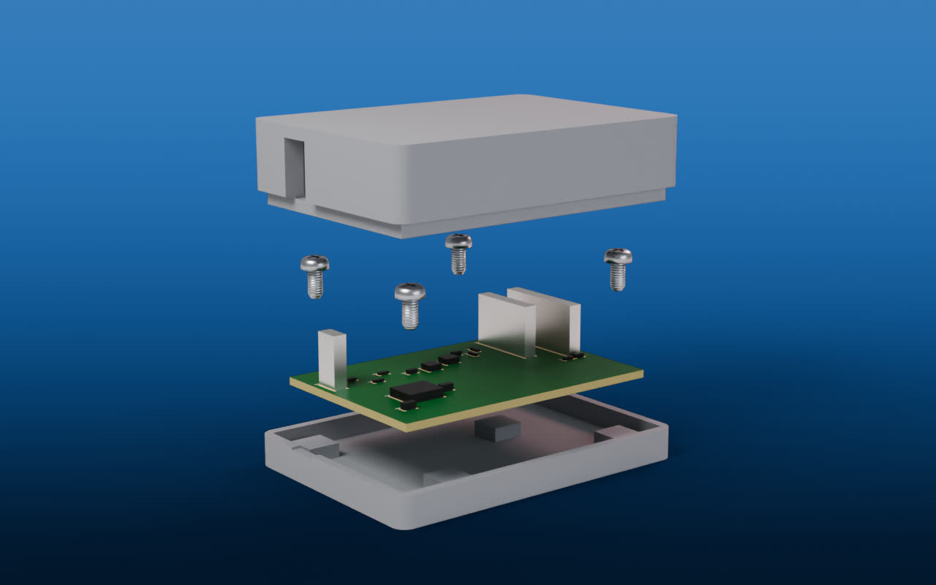
web/src/mock/renders/exploded.jpg
