mteichtahl/trace/templates/sample/mech/enclosure.stl

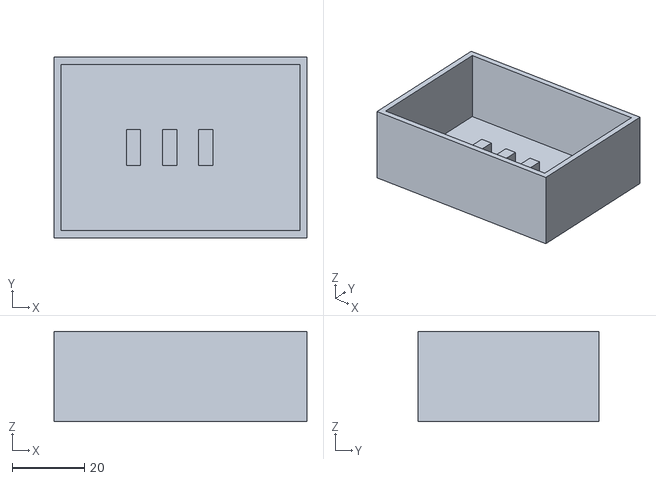
[picture p65: CAD file, 2026-10-27]
templates/sample/mech/enclosure.stl
70.0 x 50.0 x 25.0
