mteichtahl/trace/test/fixtures/showcase/case-base.stl

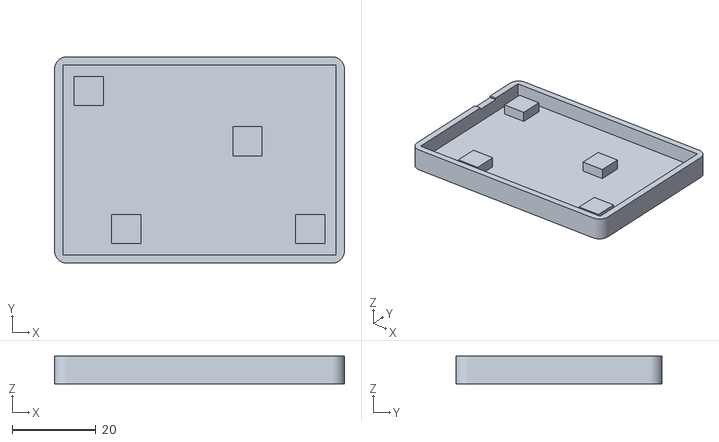
[picture p66: CAD file, 2026-11-04]
test/fixtures/showcase/case-base.stl
69.4 x 49.4 x 6.60
