mteichtahl/trace/test/fixtures/showcase/case-lid.stl

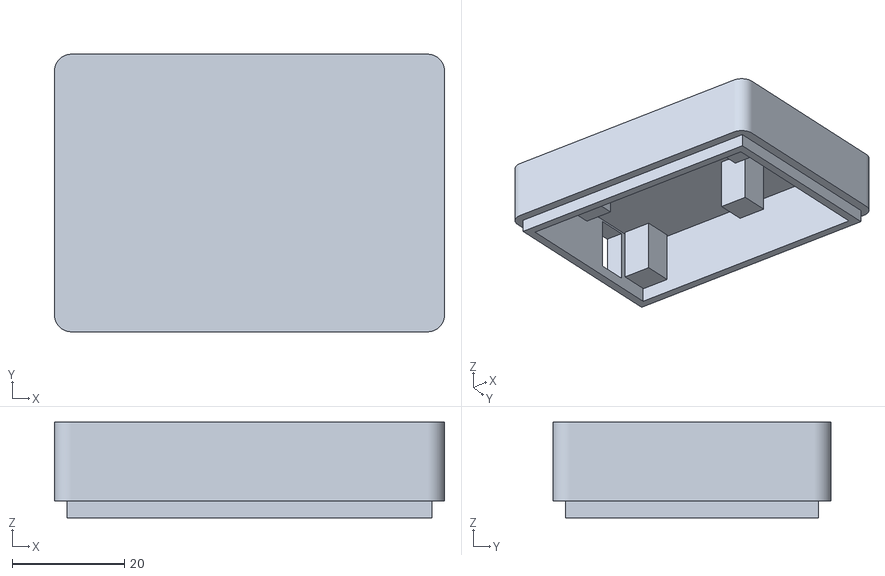
[picture p67: CAD file, 2026-11-04]
test/fixtures/showcase/case-lid.stl
69.4 x 49.4 x 17.0
