mteichtahl/trace/(list of files, drawings)

Other design files:
test/fixtures/vendor3d/easyeda-C165948.json
