mteichtahl/trace/web/src/mock/files/soil-sensor.kicad_pcb

## KiCad design web/src/mock/files/soil-sensor.kicad_pcb (2026-10-26)

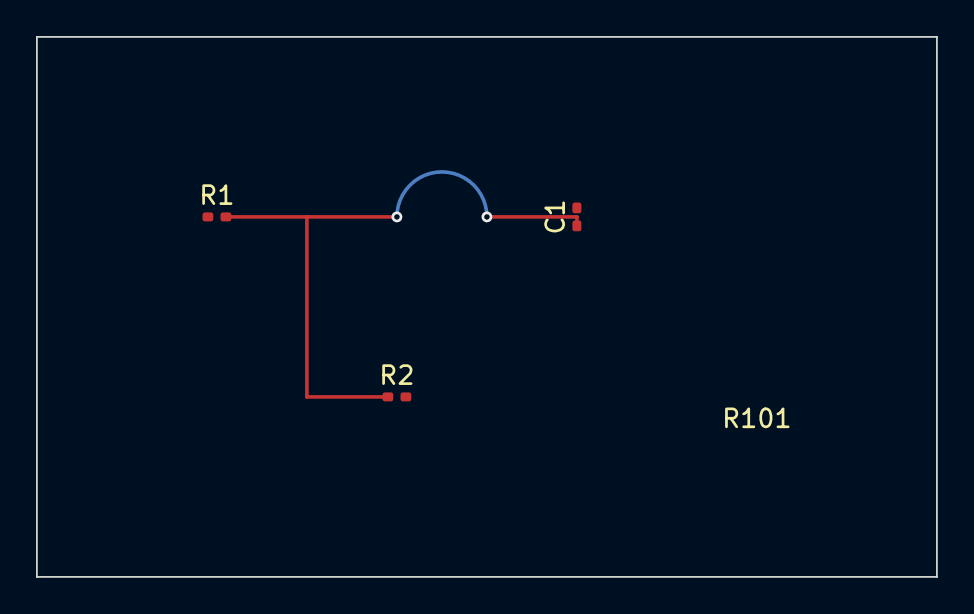
[picture p68: board soil-sensor.kicad_pcb from above]

Board: 4 copper layers, 50.0 x 30.0 mm, 4 parts (1 on the bottom side), 2 nets.

Parts:
C1: 100n; C_0402_1005Metric
R1, R2: 10k; R_0402_1005Metric
R101: 4k7; R_0402_1005Metric

Connections:
GND: C1.2, R2.2
MID: C1.1, R1.2, R2.1, R101.1
