mteichtahl/trace/examples/sensor-node/hardware/sensor-node.kicad_pcb

## KiCad design examples/sensor-node/hardware/sensor-node.kicad_pcb (2026-10-26)

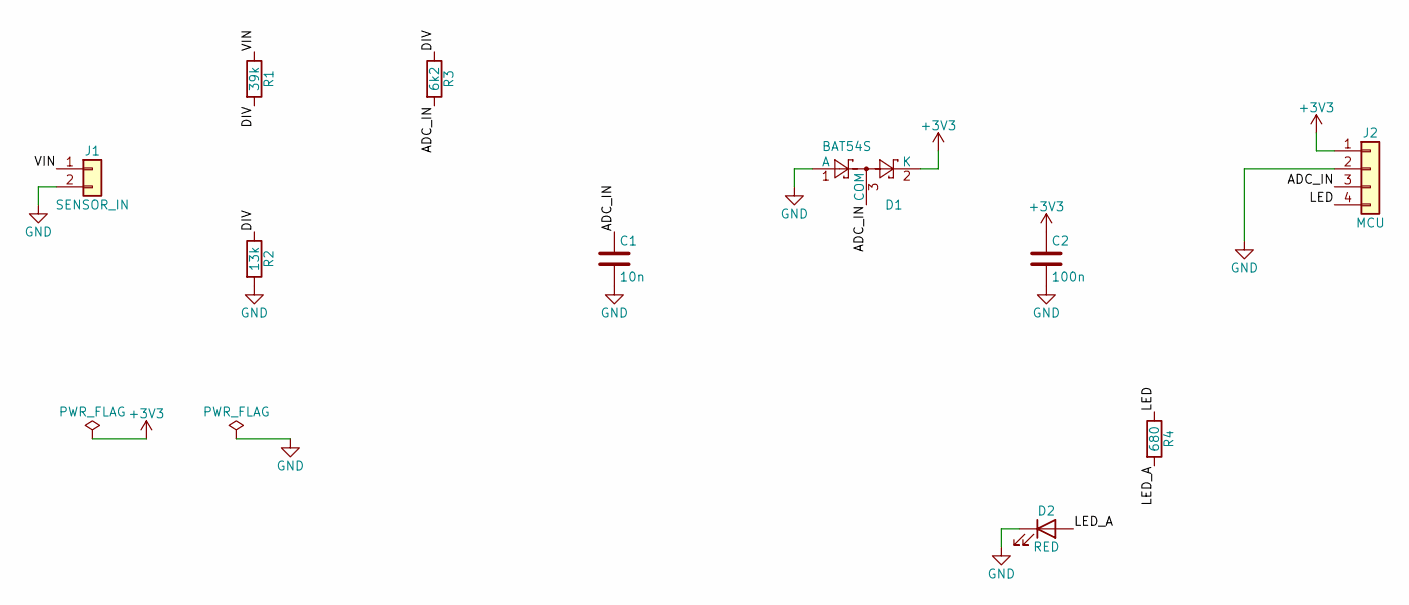
[picture p69: schematic sensor-node.kicad_sch, Sensor node: 12 V sensor input to a 3.3 V ADC]

Parts:
C1: 10n; C_0603_1608Metric; MPN CL10B103KB8NNNC; LCSC C1589
C2: 100n; C_0603_1608Metric; MPN CC0603KRX7R9BB104; LCSC C14663
D1: BAT54S; SOT-23; MPN BAT54S-7-F; LCSC C83574
D2: RED; LED_0603_1608Metric; MPN KT-0603R; LCSC C2286
J1: SENSOR_IN; PinHeader_1x02_P2.54mm_Vertical; MPN PZ254V-11-02P; LCSC C492401
J2: MCU; PinHeader_1x04_P2.54mm_Vertical; MPN PZ254V-11-04P; LCSC C2691448
R1: 39k; R_0603_1608Metric; MPN 0603WAF3902T5E; LCSC C23153
R2: 13k; R_0603_1608Metric; MPN 0603WAF1302T5E; LCSC C22797
R3: 6k2; R_0603_1608Metric; MPN 0603WAF6201T5E; LCSC C4260
R4: 680; R_0603_1608Metric; MPN 0603WAF6800T5E; LCSC C23228

Connections:
+3V3: C2.1, D1.2 (K), J2.1
/ADC_IN: C1.1, D1.3 (COM), J2.3, R3.2
/DIV: R1.2, R2.1, R3.1
/LED: J2.4, R4.1
/LED_A: D2.2 (A), R4.2
/VIN: J1.1, R1.1
GND: C1.2, C2.2, D1.1 (A), D2.1 (K), J1.2, J2.2, R2.2

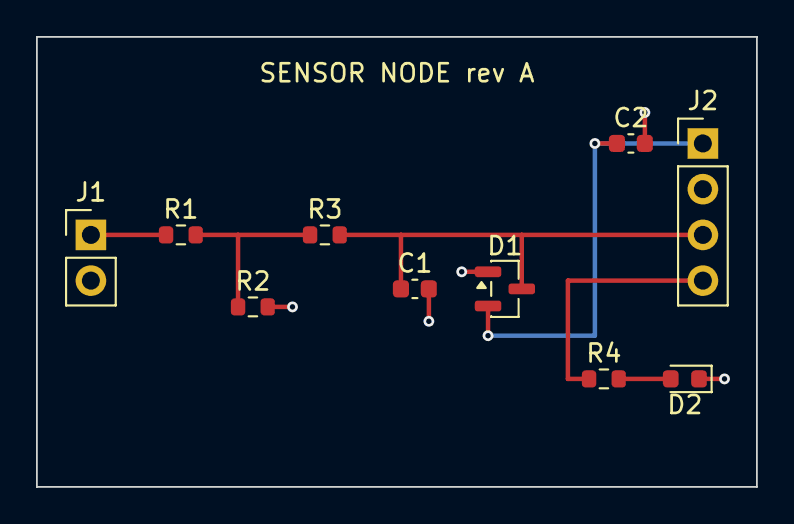
[picture p70: board sensor-node.kicad_pcb from above]

Board: 2 copper layers, 40.0 x 25.0 mm, 10 parts (0 on the bottom side), 7 nets.
