mteichtahl/trace/test/fixtures/vendor3d/board.kicad_pcb

## KiCad design test/fixtures/vendor3d/board.kicad_pcb (2026-11-07)

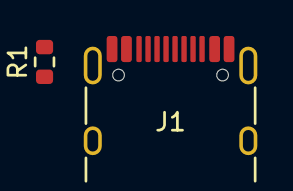
[picture p71: board board.kicad_pcb from above]

Board: 0 copper layers, 3 parts (0 on the bottom side), 5 nets, no tracks yet.

Parts:
H3: MountingHole_2.2mm_M2
J1: TYPE-C-31-M-12; USB_C_Receptacle_HRO_TYPE-C-31-M-12
R1: 5.1k; R_0603_1608Metric

Connections:
/USB_DN: J1.A7, J1.B7
/USB_DP: J1.A6, J1.B6
/usb/CC1: J1.A5, R1.1
GND: J1.A1, J1.A12, J1.B1, J1.B12, J1.SH, R1.2
VBUS: J1.A4, J1.A9, J1.B4, J1.B9
