mteichtahl/trace/test/tools/kicad/fixtures/demo/filter.kicad_sch

## KiCad design test/tools/kicad/fixtures/demo/filter.kicad_sch (2026-10-26)

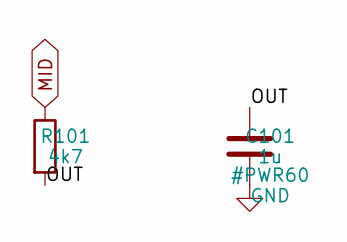
[picture p72: schematic filter.kicad_sch]

Parts:
C101: 1u; C_0603_1608Metric; MPN CL10A105KB8NNNC
R101: 4k7; R_0402_1005Metric; MPN RC0402FR-074K7L

Connections:
GND: C101.2
MID: R101.1
OUT: C101.1, R101.2
