mteichtahl/trace/python/blender/render_board.py

"""Render a PCB exported by kicad-cli (GLB from `pcb export glb`, or VRML from `pcb export vrml --units m`).

    blender -b --factory-startup --python-exit-code 1 -P render_board.py -- job.json result.json board.glb top.png iso.png ...

The exporter's own colours say what each surface is (KiCad writes the board body, copper, mask and silkscreen as
separate shapes with conventional colours); each is re-made as a clean physical surface: the solder mask in
`mask_color`, matte silkscreen, metallic pads, an FR4 edge. Component bodies keep their colours with sensible
roughness. Geometry is never changed: the renders show the board KiCad exports, nothing more.
"""
import os
import sys

sys.path.insert(0, os.path.dirname(os.path.abspath(__file__)))
import common as C  # noqa: E402

from mathutils import Euler  # noqa: E402
import bpy  # noqa: E402


def lum(c):
    return 0.2126 * c[0] + 0.7152 * c[1] + 0.0722 * c[2]


def sat(c):
    mx, mn = max(c[:3]), min(c[:3])
    return (mx - mn) / (mx + 1e-6)


MASK_ALPHA = 0.6
COPPER_METAL, COPPER_ROUGH = 0.3, 0.45


def film(rgba):
    """The colour a mask film passes: its own hue at full brightness (light through green mask comes out green)."""
    m = max(rgba[:3]) or 1.0
    return tuple(c / m for c in rgba[:3]) + (1.0,)


def surfaces(job):
    P = C.principled
    mask = C.hex_rgba(job.get("mask_color", "#1f6b3a"))
    return {
        # a real solder mask is a thin translucent film: the copper under it (every track) shows through it as
        # lighter mask, as in KiCad's own 3D viewer. An opaque mask hid all of a board's tracks (testyyyu); a plain
        # 0.8 alpha left them as faint relief, and showed bare metal rather than mask-coloured copper
        "mask": P("Solder mask", mask, rough=0.38, alpha=MASK_ALPHA, tint=film(mask)),
        "silk": P("Silkscreen", C.hex_rgba(job.get("silk_color", "#f2f2ec")), rough=0.85),
        # the board's own copper (pads, tracks, vias) is satin, not a mirror: a top-down orthographic camera sees a
        # mirror reflect the dim world, so polished copper under the mask read DARKER than the bare laminate beside
        # it (testyyyu's B.Cu tracks) and F.Cu tracks barely showed. Satin copper catches the lights as a real board's
        # does, and reads as lighter mask. Component leads stay polished tin
        "pad": P("ENIG copper", (1.0, 0.76, 0.42, 1), rough=COPPER_ROUGH, metal=COPPER_METAL),
        "copper": P("HASL copper", (0.80, 0.80, 0.78, 1), rough=COPPER_ROUGH, metal=COPPER_METAL),
        "tin": P("Tin", (0.80, 0.80, 0.78, 1), rough=0.28, metal=1.0),
        "fr4": P("FR4", C.hex_rgba("#a89c62"), rough=0.6),
        "black": P("Black plastic", C.hex_rgba("#141416"), rough=0.45),
    }


def orient(objs):
    """KiCad's exports are Y-up; Blender's importers convert, but make sure the board's thin axis is Z (top up)."""
    lo, hi = C.world_bbox(objs)
    size = hi - lo
    thin = min(range(3), key=lambda i: size[i])
    if thin == 2:
        return
    rot = Euler((1.5708, 0, 0)) if thin == 1 else Euler((0, -1.5708, 0))
    for o in objs:
        if o.parent is None or o.parent not in objs:
            o.rotation_euler.rotate(rot)
            o.location.rotate(rot)
    bpy.context.view_layer.update()


def shadowless(o):
    """Board copper casts no shadow worth drawing (35 um), and kicad-cli writes overlapping pads (testyyyu's J1) as
    coincident faces, each of which then shadows its twin: satin copper renders such pads black."""
    if hasattr(o, "visible_shadow"):
        o.visible_shadow = False


def dress(objs, S):
    """Re-make each material as the surface its colour and shape stand for. Returns counts per surface."""
    lo, hi = C.world_bbox(objs)
    bw, bh = hi.x - lo.x, hi.y - lo.y
    counts = {}
    made = {}
    for o in objs:
        olo, ohi = C.world_bbox([o])
        sx, sy, sz = ohi.x - olo.x, ohi.y - olo.y, ohi.z - olo.z
        flat = sz < 0.0002
        large = sx >= 0.8 * bw and sy >= 0.8 * bh
        for i, slot in enumerate(o.material_slots):
            col, metal = C.base_color(slot.material)
            key = None
            if col is not None:
                L, s = lum(col), sat(col)
                gold = col[0] > 0.45 and col[1] > 0.3 and col[2] < 0.35 and col[0] > col[2] * 1.6
                if large and not flat and 0.0003 < sz < 0.005:
                    key = "fr4"                                         # the board body
                elif flat and large and not gold and L < 0.5:
                    key = "mask"
                elif flat and L > 0.55 and s < 0.2:
                    key = "silk"
                elif gold:
                    key = "pad"
                elif flat and s < 0.2 and 0.15 < L <= 0.55:
                    key = "copper"                                      # a board copper layer in a grey finish
                elif col[1] > col[0] * 1.3 and col[1] >= col[2] and L < 0.3 and (flat or large):
                    key = "mask"                                        # KiCad's default mask green
                elif not flat and L < 0.06 and s < 0.35:
                    # a dark component body (KiCad's black plastic is about 0.02). Checked before metal: a glTF
                    # material that gives no metallic factor is metallic 1, which made every IC and resistor body tin
                    key = "black"
                elif metal > 0.5 and s < 0.2 and L > 0.15:
                    key = "tin"
            if key is None:                                             # a component body: keep its colour
                ck = ("keep", tuple(round(x, 3) for x in (col or (0.5, 0.5, 0.5, 1))[:3]))
                if ck not in made:
                    made[ck] = C.principled(f"part {ck[1]}", tuple(ck[1]) + (1.0,), rough=0.45)
                slot.material = made[ck]
                counts["part"] = counts.get("part", 0) + 1
            else:
                slot.material = S[key]
                counts[key] = counts.get(key, 0) + 1
                if key in ("pad", "copper"):
                    shadowless(o)
    return counts


def main():
    job, rest = C.load_job()
    if not rest:
        raise C.JobError("no board model given")
    model, outs = rest[0], rest[1:]
    scene = C.empty_scene()
    sel = C.device_for(job)
    fmt = job.get("format") or os.path.splitext(model)[1].lstrip(".")
    C.log(f"import {os.path.basename(model)} ({fmt})")
    objs = C.import_model(model, fmt, job.get("up_axis", "Z"))
    C.normalise_units(objs, job.get("units"))
    orient(objs)
    counts = dress(objs, surfaces(job))
    res = C.shoot(scene, job, objs, outs, sel)
    res["surfaces"] = counts
    return res


if __name__ == "__main__":
    C.run_main(main)
