mteichtahl/trace/(commit log)

2026-10-26 trace: autonomous repository harness and electronics toolkit (work in progress)
    Generalised from the Potroller loop into a standalone harness, in TypeScript:
    - the loop (open PRs, auto-merge, update queue, CI doctor, worker, deploys) as
    composite actions + workflow templates, with per-project settings in SQLite
    - onboarding for existing and new repositories, doctor, merge driver for the
    project database
    - electronics tools: KiCad, calculators and field solver, SPICE/Verilog
    simulation, a shared datasheet library and parts database
    - CDK stack for Bedrock AgentCore (worker + API runtimes), Cognito with
    per-project read/write grants, and the local web installer
    Still in progress: hard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
    [demo.kicad_pcb, demo.kicad_sch, filter.kicad_sch]
2026-10-26 People in three classes: admin, user (read/write where assigned), guest (read where assigned)
    Classes are Cognito groups (trace-admins, trace-users, trace-guests), so they
    arrive in the signed token; project assignments live in the central
    database. The installer, the CDK stack and the README follow.
    Claude-Session: https://claude.ai/code/session_018vQA2Cd9WJCGfqhdVbMUx6
2026-10-26 Work in progress from the builders (sample project, rendering, agent, API)
    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
2026-10-26 Security fixes from the review; the user API and sign-in
    - Installer reconciles people on every run: one class group each, projects no longer listed are unassigned, and anyone
    still assigned but unlisted is reported
    - TRACE_AGENT_LOGIN repository variable set from the agents' token, with a warning when it is the admin's own account
    - client.db uses a rollback journal in a private directory
    - Installer: key in the URL only for the page and the event stream, cross-site requests refused, repository names validated
    - Onboarding writes a CODEOWNERS section for prs.protected_paths (owner worker.escalate_to) and the ruleset requires
    code owner review
    - Narrower agent token guidance
    - Authentica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
    [common.py, render_board.py, render_model.py]
2026-10-26 Work in progress: GPU job runner, Blender render tools, sample project
    The builders are still working on these; not yet complete.
    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
    [sensor-node.kicad_pcb, sensor-node.kicad_sch]
2026-10-26 Work in progress from the builders (GPU jobs, render, autoroute, sample project)
    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
    [sensor-node.kicad_pcb, sensor-node.kicad_sch]
2026-10-26 Blender render tools (render_board, render_model, render_turntable, render_status) through runJob; fix job dir leak
    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
    [sensor-node.kicad_pcb, sensor-node.kicad_sch]
2026-10-26 Sample project examples/sensor-node (KiCad 10 board, SPICE, Verilog, firmware) with an end-to-end test; trace check prints the build result
    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
    [sensor-node.kicad_pcb]
2026-10-26 Move every tool area under src/tools/ (and their tests under test/tools/); src/tools.ts becomes src/tools/index.ts
    calc, datasheets, firmware, hil, kicad, parts, pcb, render, runs and sim join ams, emc, fpga, layout and verify;
    the memory tools move from src/agent/tools.ts to src/tools/memory/. Imports, repository-relative paths, docs and
    comments updated; 605 tests pass as before.
    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
    [demo.kicad_pcb, demo.kicad_sch, filter.kicad_sch]
2026-10-26 Open items in tools and GPU jobs: spec only in S3, CPU queue selection, input trees and includes, real courtyard polygons, .kicad_dru conditions, random requirement ids with merge rename, autorouter 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
2026-10-26 Open items in agents, harness and API: two-step actions mode with enforced tool limits, cancellable delegations, legacy memory recall, API tool calls run on the project's worker, MCP idle timeout, jo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
2026-10-26 CI fixes: KiCad symbol and footprint libraries, reportlab for the PDF fixtures, and skipped fixture suites no longer load their files while collecting
    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
2026-10-26 Prompts CLI test: don't depend on GITHUB_REPOSITORY
    GitHub Actions sets GITHUB_REPOSITORY, so the preview filled in the real repository where the test expected the
    OWNER/REPO placeholder. The test now clears it (and TRACE_MEMORY_REPOSITORY) for its run.
    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
2026-10-26 Bump the development group across 1 directory with 7 updates
    Bumps the development group with 7 updates in the / directory:
    | Package | From | To |
    | --- | --- | --- |
    | [@opentelemetry/context-async-hooks](https://github.com/open-telemetry/opentelemetry-js) | `2.8.0` | `3.0.0` |
    | [@opentelemetry/core](https://github.com/open-telemetry/opentelemetry-js) | `2.8.0` | `3.0.0` |
    | [@opentelemetry/sdk-metrics](https://github.com/open-telemetry/opentelemetry-js) | `2.8.0` | `3.0.0` |
    | [@opentelemetry/sdk-trace-base](https://github.com/open-telemetry/opentelemetry-js) | `2.8.0` | `2.12.0` |
    | [@types/node](https://github.com/DefinitelyTyped/DefinitelyTyped/tree/HEAD/types/node) | `22.20.5` | `26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
2026-10-26 Fix main's CI after #7 and #8: add vite for vitest 5, keep @types/node on Node 22, rebuild the harness bundle
    #8 (vitest 5) merged without vite, which vitest 5 takes as a peer dependency that .npmrc's legacy-peer-deps does
    not install, so every test run on main stops at startup (ERR_MODULE_NOT_FOUND 'vite'). #7 (@opentelemetry/api
    1.10.0) merged without regenerating harness/dist, which bundles it. This adds vite 8.3.4, rebuilds the bundle, and
    keeps @types/node at ^22 (trace runs on Node 22, engines >=22.13); Dependabot now skips @types/node majors.
    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
2026-10-26 Retry SQLite journal-mode switches that hit a lock
    Switching the journal mode needs an exclusive lock, and SQLite can answer "database is locked" to it (or to reading
    the mode during WAL recovery) without calling the busy handler. Several processes opening the same database at once
    could then fail; CI hit it in the central store's concurrent-writers test on #15 and #11. open() now reads the mode
    first (no lock when it is already set) and retries a locked switch with backoff up to the busy timeout.
    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
2026-10-26 Thermal specialist: envelope, power budget, junction temperatures, PCB calculators, 2.5D / CalculiX / OpenFOAM board models, checks, measurement calibration
    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
2026-10-26 docs: add the user journey from definition to fabrication
    The UX definition for trace: nine stages and their gates, the guided
    skills that hold each person's task to a quality bar, the visuals,
    and the gaps against the current codebase, with example images.
    Claude-Session: https://claude.ai/code/session_01QF2H6bmL7GSbmV9hvK6bHG
2026-10-26 docs: close the user journey's gaps
    Adds design import, the firmware track, mechanical fit, change
    requests, work during the fab wait, the Certify, Produce and Sustain
    stages, and the cost and schedule view, with six new skill specs.
    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
2026-10-26 docs: every decision trace asks for comes with a recommendation
    Adds the recommendation rule (option, evidence, trade-off,
    alternatives; overrides record a reason) and applies it in the
    architecture, question, waiver, gate, change request, release,
    import and pin plan skills.
    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
2026-10-26 docs: event driven, responsive, and say when trace will check next
    trace reacts to events and checks on a timer only where no event
    exists; every timer shows the last and next check with Check now.
    Lists what trace waits on and adds the current timers as a gap.
    Claude-Session: https://claude.ai/code/session_01EvCLqxhnz1hyhfpfiKhrvN
2026-10-26 Digital protocols and timing: bus models (I2C, SPI, UART/RS-232, CAN, 1-Wire, I2S), analog bus simulation, datasheet timing specs and checks, timing budgets, timing diagrams, captures, testbenches
    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
2026-10-26 core: declared waits and an in-process event bus
    waitWithTimer is the one timer loop: it records when it last checked,
    when it checks next and why no event exists, backs off while idle,
    drops back when the state changes, and can be woken by checkNow.
    EventBus.waitFor and trackEventWait cover event-driven waits.
    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
2026-10-26 agents: delegation and job status move onto events
    agent.delegate holds one /delegate/wait call that returns the moment
    the worker ends, instead of asking every 15 s. Jobs emit started, log,
    routed and ended events with a change counter; status can hold until
    something changes and lists open waits with their next check; a
    check-now invocation and API action wake a timer wait.
    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
2026-10-26 waits that have no event say when they check next
    Knowledge base sync and the installer's image build wait run on
    waitWithTimer with the reason no event exists. trace kb sync prints
    the wait line on each change; the installer page shows it with a live
    countdown and a Check now button (POST /api/check-now). The scope
    capture and the workflow schedules document why they are timers.
    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
2026-10-26 hil: say why the CAN receive slices are not a timer
    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
2026-10-26 Run every build on AWS CodeBuild runners, never GitHub-hosted
    - Stack: one CodeBuild runner project per repository (<prefix>-ci-<hash>),
    reaching GitHub through an AWS CodeConnections connection, with a role
    limited to its logs and that connection
    - TraceCi stack (npm run deploy:ci) for trace's own repository (trace-ci)
    - Installer: finds or creates the GitHub connection and waits for it to be
    authorized, then sets TRACE_CODEBUILD_PROJECT in each repository
    - Workflows and templates use CodeBuild runner labels; TRACE_RUNNER and every
    ubuntu-24.04 fallback removed; guard test fails on any other runner
    - doctor checks TRACE_CODEBUILD_PROJECT; README: Where builds run
    - Flat layout now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
2026-10-26 waits are events: a screen follows tool calls' wait lines live
    Every change to an open wait (opened, checked, new state, ended) is an
    event with its plain-language line. A job's waits carry its id and
    count as its changes, so a held job status wakes on them. Tool calls
    run outside any job: the API's tools.waits holds a status call in the
    project's tool session and answers the moment one of their waits
    changes; tools.check_now wakes one. kb.sync returns its lines too, and
    trace remote kb sync prints them live as they happen.
    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
2026-10-26 gpu: wait for Batch jobs on their events
    Batch job-state events go through an EventBridge rule to a stack-wide
    SNS topic. Each wait subscribes its own short-lived SQS queue, filtered
    to its job, checks the job once to close the race, then long-polls the
    queue: the result arrives the moment the job ends. A DescribeJobs every
    5 minutes is the declared safety net; stacks without the topic, or a
    failed subscription, fall back to a declared timer (5 s to 30 s).
    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
2026-10-26 The stack creates the GitHub connection; authorize it once per account and reuse it
    Nothing needs a connection ARN before the first deploy any more.
    - An authorized GitHub connection already in the account and region is reused
    (installer and deploy:ci), and the stack then manages none
    - Otherwise the stack creates <prefix>-github (trace-ci-github for TraceCi),
    always retained, and deploys without the build runners; the installer and
    deploy:ci show the authorize link, wait (saying when they check next), then
    deploy again to add only the runners and their webhooks
    - The SDK no longer creates connections
    - npm run deploy:ci runs scripts/deploy-ci.mjs (src/infra/ci-deploy.ts)
    Co-Author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
2026-10-26 agents: a job's tool waits reach its status
    Tools run in the MCP child that Claude Code starts, so their waits
    were on a record nothing read. Each job's MCP child now reports its
    wait changes to the runtime over loopback (POST /waits/report, a
    per-job token), where they are mirrored under that job; a held
    POST /waits/wakes carries check-now back to the child's timer. The
    delegate wait is opened inside its specialist's job, and
    agent.delegate no longer opens a duplicate.
    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
2026-10-26 Light installer: only AWS credentials and a GitHub token required; everything else derived, defaulted or optional
    Preflight (Bedrock model access, quotas, regions, bootstrap, leftovers) with fixes offered; optional integrations in
    Secrets Manager (trace integrations set); onboarding over the REST API (no gh CLI); CI on CodeBuild-hosted runners;
    prebuilt images with build fallback and layer caching; parallel repo and people steps; trace upgrade and uninstall.
    Fixes two install blockers: global installs lacked package-lock.json/.npmrc for the image and CDK bundling, and a
    re-run could delete the stack's own GitHub OIDC provider.
    Claude-S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
2026-10-26 gpu: a job-events topic per project
    Each project gets its own SNS topic and EventBridge rule, matched on
    the project's own job definitions, so its worker can subscribe,
    unsubscribe and list only on its own topic: no project can touch
    another's subscriptions. Nested layout only, like the CPU queue and
    knowledge bases (a flat stack would pass CloudFormation's 500
    resources); flat installations wait on the declared timer.
    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
2026-10-26 Installer: an optional sample project (work in progress)
    The answer, the sample and tour steps, the page's option, and the GitHub calls that create the repository and commit
    files without the gh CLI. The sample's design files and its tour are still to come.
    Claude-Session: https://claude.ai/code/session_018nyLcg5TSnQCwUfKnsi9s1
2026-10-26 Publish trace's images on ECR Public, set up by API; no console step on the default install path
    Release registry: TraceRelease (src/infra/release.ts, us-east-1) holds the ECR
    Public repositories trace-agent (arm64) and trace-gpu (amd64), with catalog
    data, and the trace-release role. GitHub OIDC lets only the source repository's
    main and v* tags assume it (using the account's provider when it has one), and
    it may only log in and push to those two repositories. The registry address is
    public.ecr.aws/<default alias>. ECR Public assigns that alias once the first
    public repository exists, so `trace release setup` reads it with
    DescribeRegistries after the deploy, waiting if needed, and sets the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
2026-10-26 docs: web app interface design, screens and diagrams
    The design for trace's web app, for review before building: docs/ui-design.md
    covers the shell, every area and screen, chat over AG-UI with CopilotKit,
    file viewers, voice, preferences, operations, knowledge and its graph view,
    memory, agent instructions, theming, tables, accessibility, and the twelve
    decisions to make first. 27 screens are rendered to docs/ui/screens with their
    design sources in docs/ui/source, and the two diagrams in docs/ui/diagrams.
    Design only; no code changes.
    Claude-Session: https://claude.ai/code/session_01Tj7VLqLPjwm5L5LDhC8sYu
2026-10-27 CI falls back to GitHub's runners until the AWS runner exists; the installer sets up trace's own CI
    - Every job picks its runner from TRACE_CODEBUILD_PROJECT: the CodeBuild
    runner when it is set, ubuntu-24.04 until then
    - The installer sets the variable only once a runner exists, and removes it
    where none does, so workflows never wait on a missing runner
    - The installer builds trace's own repository on AWS too (runner only, no
    agents) when its token can configure it: stack prop ciRepositories
    - Removes the TraceCi stack and npm run deploy:ci
    - A timed-out connection wait no longer stops the install
    - doctor: a missing variable is a note, not a failure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
2026-10-27 Hardware in the loop without hardware: the bench emulator (trace hil emulate)
    An emulated PSU, scope and DMM over SCPI sockets, a virtual CAN bus and a firmware console on a pseudo-terminal, all
    modelling the sample board, so every hil tool, thermal.measure and verify items with method hil run with
    TRACE_HARDWARE=1 and no instruments. FakeScpi moves from the tests into src.
    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
2026-10-27 Publishing is part of the install, with no prework
    The installer publishes trace's images by default when the token administers the source repository (the owner's
    install): agents.publishImages is now null by default, derived from the token. Publishing records the registry in
    the source repository's trace-images release, and every install finds it there (derive.ts imageRegistry), so no one
    edits or commits PUBLISHED_REGISTRY. That constant stays as an optional pin for forks.
    The preflight says where the images come from and whether this install publishes. The installer page offers
    'Decide for me' for publishing.
    Claude-Session: https:/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
2026-10-27 docs: per-project Contributor and Reviewer parts in the UI design
    Decided: a person's account class (Admin, User, Guest) is a ceiling, and each
    project gives them a part, Contributor or Reviewer; a Guest can only review and
    admins are on every project. The spec drops the older class-based "Creating a
    project" section, keeps the per-project one, and words every permission in
    terms of parts. New project now follows the six-step flow (About, How it
    starts, Repository, People, Build and budget, Review) with eight icons and
    colours, and Admin > People shows each person's part per project and asks for
    it when inviting. The three affected screens are re-rendered.
    Design only; no code changes. The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
2026-10-27 Sample onboarding: create the project database before writing settings
    A scratch copy has no .git, so the store could not find its root and the settings went to the per-user scratch
    database instead.
    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
2026-10-27 Sample project content (work in progress snapshot)
    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
    [trace-sample.kicad_pcb, trace-sample.kicad_sch, u1-bench-log.csv, uart-console.csv]
2026-10-27 The sample project: a 12 V rail monitor that exercises every agent and every simulation
    templates/sample: a finished 17-part KiCad 10 board (ERC and DRC clean) with an intent, a numbered spec, two original
    datasheets for fictional parts, analog, corner, noise and op-amp models, an LDO power stage, logic with testbenches,
    cocotb and formal properties, an iCE40 top and constraints, protocol captures, a Touchstone file, a thermal bench log,
    an unrouted copy for the autorouters, an enclosure for renders, host-built firmware, and the bench emulator's
    settings. sample-seed.ts fills its project database (requirements, a test plan with every method, coverage, analog and
    protocol specs, thermal envel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
    [enclosure.stl]
2026-10-27 Keep the installation up to date when trace's main branch changes
    - The installer saves the deploy's settings (no tokens) to
    installation/props.json in the central bucket
    - Stack role <prefix>-self-update, assumable through GitHub OIDC only by
    trace's ci workflow on its default branch (sub + job_workflow_ref); it may
    use the CDK bootstrap roles, read the saved settings and the stack outputs,
    look at the GitHub connection, and read the shared agent token
    - ci.yml job update-installation (after tests pass, on main): trace
    update-installation deploys with the saved settings, adds the runners once
    the connection is authorized, and sets TRACE_CODEBUILD_PROJECT
    - The installer sets TRA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
2026-10-27 Fix `npm install -g github:mteichtahl/trace`: build in an isolated copy
    npm leaks the outer --global into a git dependency's prep install, so the
    clone's devDependencies (TypeScript, Vite) never install and `prepare`
    fails with `tsc: command not found`. prepare now builds in place when the
    tools exist, and otherwise runs npm ci + build in a temporary copy and
    copies dist/, harness/dist/ and the agent/ staged files back.
    Claude-Session: https://claude.ai/code/session_014dZPhYFJTq3VonKc2YpDVp
2026-10-27 web: the app's scaffold — Vite, React 19, Tailwind v4, shadcn/ui and trace's theme tokens
    Claude-Session: https://claude.ai/code/session_014dZPhZL8wyEsSssFiw2Coe
2026-10-27 web: lib — typed API calls with the body hash, auth in memory, AppSync live events, preferences, formats, glossary
    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
2026-10-27 web: shared components — stage rail, cards, run and wait lines, Data table, Focus layout, Canvas frame
    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
2026-10-27 web: chat on CopilotKit v2 and AG-UI — Ask trace, markdown, tool cards, ask_person, recall, voice
    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
2026-10-27 web: the shell — rail, top bar, ⌘K, live dot, bell, Ask trace dock, phone tabs, shortcuts
    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
2026-10-27 web: the rail's background fills the full height of long pages
    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
2026-10-27 journey: the record of stages, gates, questions and waivers
    src/core/journey.ts adds the journey tables to the project database (journey,
    stages, gates, gate_criteria, criterion_opens, gate_signatures, questions,
    waivers, decisions), each with a merge rule for `trace db merge`. Templates
    Board, FPGA, Firmware and Mixed (with Certify, Produce and Sustain as options
    and the firmware track's criteria) come from docs/user-journey.md. Pure
    functions work out each stage's state, criteria met counts, the one next step
    for a viewer, what still stops a signature, and the inbox items; writes sign,
    return (optionally reopening an earlier stage), answer questions and take
    waivers, each checked against t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
2026-10-27 journey: order the decisions log by insertion when times tie
    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
2026-10-27 preferences and chats: per-person settings and per-project threads
    src/core/preferences.ts keeps one JSON document per person in the access
    store (dotted keys set or unset one at a time, at most 64 KB), for the
    Preferences screen and saved table views. src/core/chats.ts keeps Ask trace's
    threads in the central bucket under projects/<slug>/chats/: one object per
    thread, an index, and each person's sent messages for recall, all written
    with conditional puts and re-run on a lost race.
    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
2026-10-27 api: the web app's actions, each area in its own file
    The shared action plumbing (deps, context, def, the project database through
    GitHub, the central bucket) moves to src/api/action-kit.ts so the area files
    and actions.ts do not import each other. New actions:
    actions-projects.ts project.members, projects.create (onboard with the
    API's token, register, assign with parts, start the
    journey, record the project for the next installation
    update)
    actions-journey.ts journey.get, journey.criterion.open, gate.sign,
    gate.return, question.answer, waiver.add, inbox
    actions-chats.ts chats.list/get/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
2026-10-27 web: the backend's HTTP layer, config and sign-in
    Router, body limits, error mapping and one-line JSON logs; the SSM config
    cached per container; trace's own sign-in on Cognito's user-pool API
    (USER_AUTH choice-based: passkey, email code, password, authenticator app,
    new password), the refresh token in an HttpOnly SameSite=Strict cookie,
    forgotten passwords, passkey and TOTP registration. The content-hash helper
    the app needs for POSTs through CloudFront's origin access control.
    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
2026-10-27 web: the trace chat agent over AG-UI
    /api/agui streams AG-UI events from Bedrock ConverseStream: text messages,
    tool calls, steps and run state. Backend tools are read-only API actions (and
    start_task) called as the person; frontend tools end the run so the app can
    ask the person and resume. Its system prompt is the catalog's new chat entries
    (chat.role editable; the data fence, context and state locked).
    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
2026-10-27 web: voice (Polly cached in S3, signed Transcribe URLs) and Operations
    Speech is cached by sha256(voice|engine|rate|text) with presigned URLs and word
    marks; dictation gets a presigned Transcribe streaming WebSocket URL. /api/ops
    reads the CloudWatch dashboards and alarms and filters every series by the
    person's class and projects, through the project hash in trace's resource
    names; reviewers see no cost.
    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
2026-10-27 test: the web backend
    Sign-in flows and cookie attributes, refresh and sign-out, the call proxy and
    its event fan-out, the AG-UI event sequences (text, backend tool, frontend
    tool stop, round cap, errors, heartbeats), Operations filtering for admins,
    contributors and reviewers, the voice cache key and the Transcribe URL, and
    the bundle.
    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
2026-10-27 web: gate review and signing, and the project tabs (requirements, design, evidence, runs, build, decisions, cost, settings)
    The gate in Focus mode: recommendation, criteria with Open evidence (recorded with
    journey.criterion.open), waivers to acknowledge, cost and time, notes, Sign disabled
    until every rule holds (tooltip lists what is missing), a confirmation that restates
    the act with a passkey re-check at the release and order gates, Return with a reason,
    the admin-only wait for others, and the gate record as a receipt.
    Project tabs replace the catch-all: traceability in a Canvas frame with failing chains
    coloured, design pictures with findings overlays, coverage and runs, the run page w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
2026-10-27 infra: the web app (TraceWeb)
    A nested WebStack for the address: the private site bucket built from web/,
    the backend Lambda (Node.js 22 arm64, IAM function URL, response streaming)
    bundled by src/web/bundle.ts, a voice cache bucket, and CloudFront with origin
    access control on both origins, an SPA viewer-request function, strict
    security headers and a content security policy. In the parent, after the
    pool: the web app client (USER_AUTH, refresh), AppSync Events with Cognito
    subscribe and IAM publish and an own-channel onSubscribe handler, and the
    /<prefix>/web/config parameter. The pool offers passkeys (relying party: the
    app's address) and passwords first, email codes only with web.sesFrom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
2026-10-27 installer: the web app's settings, plan step and Open trace
    Advanced gains a Web app group (on by default, optional custom domain and
    certificate, optional SES sender for email codes); the plan lists the app's
    address; the done card shows Open trace. README: a Web app section.
    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
2026-10-27 journey: keep the live record in the central bucket, copy it in at release
    The journey record moves out of the repository: src/core/journey-store.ts
    keeps one SQLite database per project at projects/<slug>/journey/journey.db
    in the central bucket, read and written with conditional puts (If-Match /
    If-None-Match) and re-run on a lost race, as the central store and chats are.
    Every write answers the record's version instead of a commit and branch; the
    trace/journey and trace/onboard branch logic is gone.
    A project whose journey an older install kept in .trace/project.db has it
    imported on first read. When a release is cut (the signature the Release
    stage follows), gate.sign copies the record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
2026-10-27 web: accept the web app's tokens, and read them from the header CloudFront forwards
    Origin access control signs every request to the function URL and puts its signature in Authorization, so the
    /api/* viewer-request function forwards the person's token in x-trace-authorization; the backend reads it there.
    The API runtime's verifier accepts the CLI's and the web app's app clients.
    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
2026-10-27 web: the nineteen guided skills in Focus mode, from one skill table
    Each skill's steps, picture, variant and quality bar come from
    components/skills/definitions.ts (docs/user-journey.md). Intent builder and Question
    answer are conversational (the draft from the agent's shared state via useAgent);
    Schematic finish, Placement adjust and Board setup show the picture with findings
    linked to their list, the KiCad push line and reasons for changes from the draft;
    Waiver and Change request are stepped forms ending in waiver.add and task; Bench
    setup, Bring-up run and Incoming inspection are checklists on a picture with a live
    readout and a big Stop. The rest render from the table. Leaving keeps a d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
2026-10-27 web: Operations — status line, controls and refresh Wait line, tiles, alarms, sections with charts and the moment sheet
    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
2026-10-27 web: Admin — people and access, agent instructions (also under project Settings), installation and keys, usage and cost
    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
2026-10-27 web: Inbox — the four kinds, grouped, answered in place with the Decision card
    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
2026-10-27 web: Preferences — nine groups, applied at once with Saved, reset, locks, search and ⌘K, display live, voice, sign-in, your data
    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
2026-10-27 web: shared bits for s2 screens — askTrace() hands Ask trace a question, WaitLine checkLabel, SideSheet (sheet on desktop, drawer on phones)
    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
2026-10-27 web: Knowledge — one search with scope, ranked results with weaker matches, documents, datasheets and parts, agent memory, and the graph view (Cytoscape, lazy)
    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
2026-10-27 web: project Memory tab — long-term with search by meaning, switch off with a reason, bulk, correct it instead; recent activity; changes
    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
2026-10-27 web: Agents and tools — live work, agents table, tools catalogue by family with Try it from the tool's schema, agent and tool pages
    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
2026-10-27 web: New project in Focus mode, Continue on the next step card, tests
    New project's six steps (About with the icon picker, How it starts with the template
    recommendation, Repository with Advanced, People with parts — Guests locked to
    Reviewer, admins locked — Build and budget, Review) end in projects.create with Run
    and Wait lines and Open project. The next step card offers "Continue: <skill>, step n
    of m" from a kept draft. Tests cover the gate's Sign rule, the skill table, each
    form skill's quality bar, drafts, traceability and New project's rules.
    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
2026-10-27 web: viewer libraries — three.js, PDF.js, tracespace, WaveDrom, occt-import-js, fflate, DOMPurify, diff; KiCanvas vendored (not on npm)
    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
2026-10-27 web: the File viewer — one component in three sizes, one toolbar, a viewer per kind (lazy), versions and compare; registered for the chat's File card
    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
2026-10-27 web: mock files for every viewer (parts list, VCD, markdown, code, SVG, generated PDF, STL, fab zip, firmware), and screenshots of the file screens
    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
    [soil-sensor.kicad_pcb, soil-sensor.kicad_sch]
2026-10-27 api: the actions the web app's screens were built against
    requirements.trace, design.get, build.get, order.record, cost.get (actions-record.ts); skill.get,
    skill.draft, skill.drafts, skill.submit with a check function per quality-bar check of the nineteen
    skills, computed from the record or answered not_met with what has to be recorded first
    (skill-checks.ts; drafts per person in the journey store, never copied into the repository);
    policy.get and policy.set with me.get's locks and me.set refusing a locked key; users.list's
    last_seen and name; users.history from the assignment log in words; files.list rows with the
    revision, release, frozen, history (commit, at, versions) and findings; files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
2026-10-27 web: the project tabs, skills and run controls on the actions that now exist
    Requirements shows requirements.trace's note on the missing intent; Design, Build and Cost show the
    API's notes and treat what is not recorded as not recorded (cost: null cloud use, money for admins);
    the order sheet's board picture comes from design.get. Guided skills keep their drafts in the
    journey store (skill.draft, skill.drafts; New project still with preferences), the Waiver submits
    through skill.submit, and every skill lists the checks the record cannot answer yet. RunLine and
    the run page offer only the job's controls (cancel today), with cancel through job.control.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
2026-10-27 Rename the CLI command from trace to tracectl
    macOS ships /usr/bin/trace (kernel tracing). A global `trace` from npm either
    shadows it or is shadowed by it wherever nvm's bin directory is not first on
    PATH (sudo, cron, launchd), so the command is now `tracectl`.
    - package.json bin: tracectl -> dist/bin.js
    - every usage string, error message, prompt, doc and workflow template that
    tells someone (or an agent) to run the command
    - `trace upgrade` re-execs `tracectl upgrade --no-pull`
    - the install action and the agent image provide `tracectl`, and keep a
    `trace` alias (Linux only) for workflows rendered before the rename
    - harness/dist rebuilt
    Unchanged: the product name, the `trace` MCP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
2026-10-27 Installer: show what the checks are doing, and stop the plan hanging
    The Review page could sit on "Working out the plan…" for good: changing how
    CodeBuild reaches GitHub cleared the checks' results without running them
    again, so the plan was asked for with no AWS account and came back as a
    schema error (400), and a check that could not run at all (502) was shown
    only on the Connect tab.
    - The checks now report each step as it starts and ends; the page streams
    them (application/x-ndjson) and shows what is running, "n of m done", and
    every check on request.
    - Review runs the checks itself when they have not passed, shows any error
    with Try again, and only says "Working out the plan…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
2026-10-27 api: identity keyed on the sub; chats.append stores the caller's own turns only, trace's replies through chats.reply
    - hashOf is the hash of the Cognito sub (immutable), never the email; hashesOf adds the email's hash so records made
    before (journey opens, questions asked of a person, chat recall, memory marks and person memory) still match on read
    - a task carries requestedBySub: the job's person memory is keyed on it
    - chats.append: role is always user, authored by the caller (by_hash of their sub); any role sent is ignored
    - chats.reply (new): trace's reply and tool rows, by "trace", accepted only after the caller's own latest turn
    - caps: 500 threads per person per project, 20,000 char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
2026-10-27 journey: the agents' facts beside the record, merged into every view
    projects/<slug>/journey-agent/facts.db (src/core/agent-facts.ts) keeps what
    agents contribute: their questions (exactly one option recommended, a reason
    each), their checks of the criteria trace owns (newest stands), and when they
    are stuck. It is the journey store's conditional-write database (BucketDb,
    shared with JourneyStore). mergeAgentFacts folds the facts into journeyView,
    gateView, inboxItems, signGate, answerQuestion and addWaiver (optional, additive
    arguments); a person-owned criterion never moves from an agent's fact, and a
    person's answer is written in the record under the agent's question id.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
2026-10-27 tools: journey.status, journey.ask, journey.check, journey.stuck for agents
    The worker and the specialists record what they contribute to the journey in
    the agents' facts; journey.ask can wait for the answer on a declared timer.
    Never offered through the API's tool action (API_HIDDEN_TOOLS). The job runner
    names the agent and its job (TRACE_AGENT, TRACE_AGENT_LABEL, TRACE_JOB_ID), and
    the specialist prompt says to ask, check and report stuck through them
    (specialist.journey, locked specialist.journey.people).
    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
2026-10-27 web app: threads save and load on the API's shapes; start_task is a confirm card; replay sends only the viewer's own turns
    - readers for chats.list, chats.get, chats.append and chats.recall, tested against the API's real answers
    (api-answers.json, regenerated with the chats added)
    - chats.append sends {thread, messages: [{text}]} (the person's words only); chats.get {thread}; trace's replies are
    kept by the chat agent (no more client-written assistant or tool rows, no feedback rows in the shared thread)
    - replay: the viewer's own turns and trace's replies to them are the conversation; other people's are shown and sent
    to trace as forwardedProps.others (quoted data), with readOnly; ever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
2026-10-27 web auth: the refresh cookie is __Secure-trace_rt (the old name read once, a name sent twice ignored); start offers the pool's choices for every address
    - start answers the pool's first factors (fixedChoices), not Cognito's AvailableChallenges, which differ between a
    real address and an unknown one; a choice the account has not set up fails at respond as choice_unavailable
    - parseCookies drops a cookie name sent more than once
    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
2026-10-27 web infra: live events in the web stack behind a Lambda authorizer, an exact CSP, the chat model scoped, an optional WAF; costly endpoints need a class
    - AppSync Events moves into the web nested stack, authorized by src/web/events-auth.ts (the app's id token, its own
    channel only; handlerContext.sub for onSubscribe): it names nothing of the pool, so the CSP names its exact hosts
    without a cycle. Plus GitHub's download hosts for files.url links; the theme script is web/public/theme.js
    - ChatModel: the configured profile in this account and the foundation model it routes to (web.modelRegions narrows
    the regions), no more anthropic.* and inference-profile/*
    - web.webAclArn attaches an exi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
2026-10-27 web, infra: live updates when an agent records a journey fact
    The central bucket sends its object events to EventBridge (its own
    NotificationConfiguration property: no custom resource). In the web nested
    stack, beside the events API, a rule on Object Created of
    projects/*/journey-agent/facts.db invokes <prefix>-journey-events, which
    works out the project from the key, reads who is on it from the access store
    (read only), and publishes record.changed { what: journey } to each person,
    and a notification (no project content) for a new question or stuck report
    to the people it is for. stuck.dismiss joins the live-event list.
    Claude-Session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
2026-10-27 tools, infra: journey.ask waits for an answer on events, the timer only as a fallback
    Each project's events topic (nested layout) now exists with or without GPU
    jobs, and a second rule sends it the bucket's Object Created events of its
    journey.db, which only the API writes. journey.ask subscribes a wait queue of
    its own (openWaitQueue, shared with the Batch job wait) filtered to those
    events, reads the record once per write, with safety reads at 30 s, 90 s and
    every 5 minutes, and falls back to its timer (30 s doubling to 5 minutes) for
    what is left of the wait when there is no topic or subscribing or receiving
    fails, saying why and when it looks next. journey.status lists stuck reports
    apar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
2026-10-27 Web app: say `tracectl`, the CLI's name since #40
    The web app's own additions still told people to run `trace login` and named
    "the `trace` CLI". As #40 did for the rest (package bin tracectl, every usage
    string, doc and prompt that tells someone to run the command; the product
    name, the `trace` MCP server, .trace/, env vars and AWS names unchanged):
    - the Cognito invitation email, both forms (src/infra/stack.ts) and its tests
    (test/infra/web.test.ts)
    - the installer's web-app plan line and Advanced note (bootstrap.ts, ui/app.ts)
    - README "Web app": the sign-in and invitation sentences
    - docs/web-build.md, src/web/call.ts, web/src/lib/readers.ts: "the `tracectl` CLI"
    - src/gpu/inflight.ts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
2026-10-27 Self-update adds the projects created in the web app
    projects.create records each new project at
    installation/pending-projects/<owner>/<repo>.json for the deploy that adds its
    own agent, memory, knowledge base and build runner. Nothing read them.
    - src/installer/pending.ts: parse the records; addPending puts them in the
    settings' repositories one at a time, keeping one only if the settings still
    validate (at most 60 projects, no hash clash), and refusing a build-only
    repository, the flat layout (an update cannot grow it) or one whose deploys
    failed MAX_ATTEMPTS (2) times; markAdded / markAttempt; absorb for the
    installer; S3 list/put/remove.
    - src/installer/update.ts (`tracectl up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
2026-10-27 Installer: the sample project starts its journey, as projects.create does
    The sample (#37) is created and onboarded by the installer, not by
    projects.create, so it had no journey record and the web app showed it
    without stages or gates.
    - src/installer/sample.ts: startSampleJourney writes the first journey state
    in the journey store (projects/<slug>/journey/journey.db, found from
    TRACE_HOME exactly as the API's bucketStore finds it): the Mixed template
    (board, logic and firmware, which the sample has), start "import", at
    Define, named after the sample. A journey already there is left alone.
    - src/installer/bootstrap.ts: run in the people step, where the installation's
    AWS credenti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
2026-10-27 Ask trace applies the installation's chat.role override
    The web backend cannot read the prompts store (one database with every
    prompt's override and history; S3 cannot grant part of an object). A new
    API read, prompts.chat, answers only the editable chat.* entries; the
    backend asks for it as the person and keeps it 60 s per container,
    cleared by a prompts write through that container. Locked chat entries
    always come from the code.
    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
2026-10-27 Design record: intent, architecture, pin plan and sheet requirements in the project database
    Agents propose intent statements (with source, linked from each requirement),
    architecture options with blocks, connections, criteria and scores, the pin
    plan, and which requirements each sheet serves, through design.intent,
    design.architecture, design.pins (with a check against the schematic's
    netlist) and design.sheets. People's decisions over them live in the journey
    record's new design_decisions table, which agents cannot write.
    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
2026-10-27 kicad.export keeps each sheet's drawing and the board's in its run
    One SVG artifact per schematic sheet (sheets/<file>.svg), the board SVG and
    the render, with drawings.json naming the file and sheet each draws and its
    page size, so the app can place findings on them.
    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
2026-10-27 API: real intent, architecture, pin plan and drawings; design.decide; computable skill checks
    requirements.trace answers the intent and each requirement's derived_from
    links; design.get the architecture, the pin plan checked against the newest
    netlist, sheet drawings with findings placed and each sheet's requirements;
    graph.neighbourhood gains intent, block, part and sheet nodes. design.decide
    records a person's decision; the design skills' Submit records the same. The
    Intent builder, Requirements review, Architecture choice and Pin plan review
    checks, Schematic finish's serves and Board setup's outline are now computed
    from the record.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
2026-10-27 Web app: block diagram, pin plan, sheets and traceability from the design record
    Design tab draws the chosen (else recommended) option with an option switcher
    and the scores table, the pin plan with agreement state, and each sheet's
    requirements; the traceability view marks proposed intent; the design skills
    carry their decisions in the draft. Mock fixtures in web/src/mock/design.ts.
    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
2026-10-27 Cost ledger: each run's model use and each Batch job priced from one dated table, and a daily Cost Explorer read
    Every Claude run records its tokens per model (the Agent SDK's result message) and every finished
    Batch job its running time, priced from src/core/prices.ts (defaults dated, overridden by the stack
    setting cost.prices, marked estimates) into projects/<slug>/journey-agent/cost.db. A scheduled
    Lambda reads Cost Explorer daily grouped by trace:project, activating the cost allocation tags when
    allowed, and writes per-project actuals and its status into installation/cost/actuals.db.
    Claude-Session: https://claude.ai/code/session_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
2026-10-27 Orders after payment: shipping recorded by people, DHL tracking on a backed-off timer, boards by serial
    JLCPCB gives order status only to approved partner companies, so the person records the shipping
    notice (carrier and tracking number); an hourly order-watch Lambda follows DHL parcels with the
    optional dhl integration, backing off while nothing changes. Boards are recorded by serial with
    each incoming inspection check, as journey tables.
    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
2026-10-27 Bring-up readings and instrument identities recorded against the board and step
    The hil tools take an optional bringup tag (board, step, limits): the reading is stored in the run
    record with pass or fail, and copied live beside the agents' facts so the Bring-up run screen
    updates as it is taken. hil.idn stores each instrument's identity. kicad.fab keeps the parts the fab
    does not place.
    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
2026-10-27 API: build.get, order.update, order.check_now, board.record, board.check, cost.get from the ledger, usage.month
    Build and cost actions move to actions-build.ts and actions-cost.ts. The skill checks for Incoming
    inspection, Bench setup's identities and Bring-up run's limits and shorts are computed from the
    record. The API role reads the ledger and starts order watches; money stays admins' only.
    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
2026-10-27 Web app: cloud cost, shipping, boards and bring-up readings on screen
    Cost and time shows cloud use estimated by kind beside what AWS billed and when Cost Explorer reads
    next; Admin › Usage and cost reads usage.month; Operations' cost tile and the gate's cost line use the
    ledger. The Build tab records shipping (carrier, tracking, delivered) with the carrier Wait line,
    lists boards with their inspection checks and the bench's identities and readings; Incoming
    inspection records boards and checks; Bring-up run shows every reading live. Mock fixtures for both.
    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
2026-10-27 Docs: cost per project, order status, boards and bring-up readings
    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
2026-10-27 Dictation uses each project's own words (Transcribe custom vocabulary)
    The project's worker (and its kb-sync push job, now voice-vocabulary)
    reads the design: reference designators, part numbers, net labels, power
    nets and requirement ids, and writes a Transcribe vocabulary table under
    projects/<slug>/voice/<language>.txt with Transcribe's phrase rules
    (spelled acronyms, number words, no digits, 256 chars, 50 KB) and the
    design's spelling as DisplayAs. CreateVocabulary (tagged with the
    project) or UpdateVocabulary when the table changed, named
    <prefix>-<hash>-<language>; the wait for READY is a declared timer
    because the EventBridge state-change event is sent for creates only.
    /api/voice/li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
2026-10-27 Run record: which agent made each run
    runs gains an agent column (TRACE_AGENT, which each job's MCP server has), added to
    older databases in place; the runs action takes agent to list one agent's runs.
    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
2026-10-27 Job index, queue and pause on the worker
    Each project's worker writes its jobs into projects/<slug>/journey-agent/jobs.db from
    their own events (started, state, routed, steps, waits, ended) with a heartbeat. A
    person's task waits its turn behind a running job of the same agent or
    worker.max_parallel jobs, in an order people can change, told by the project's events
    topic (timer fallback). Pause stops a running task before Claude's next tool call
    (PreToolUse hook), commits and pushes its work on its branch, keeps its transcript;
    Resume continues the same Agent SDK session, or starts fresh told what was done.
    Claude-Session: https://claud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
2026-10-27 Per-project series of trace's job, tool, cost and GPU metrics
    trace.project.* metrics carry the project's hash (trace.project = project-<hash>) and
    the outcome only, recorded on each project's own runtime beside the unchanged
    aggregate series. The agents' dashboard gets per-project widgets; Operations
    attributes them, so contributors and reviewers see their projects' jobs and tool
    calls, and cost stays for admins.
    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
2026-10-27 Flat installations: web-app projects added by updates, and the app says what applies
    The self-update now adds projects created in the web app to a flat
    installation too, while it holds fewer than 15 projects (about 21 of the
    stack's 500 resources each; a carried project is never dropped for the
    cap), and says every time what the flat layout lacks and that the move
    to nested stacks is the installer's. Giving flat per-project topics,
    knowledge bases and the CPU queue was rejected: 9 more resources per
    project would take 20 projects past 500. The update never moves the
    layout itself, since the move deletes every project's memory records.
    A new read, installation.layout (TRACE_LAYOUT from the s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
2026-10-27 App: running jobs, Pause, Resume and Move up, agents' status
    Home's Running now, the project's "trace is doing" and Queued, and Agents and tools
    read the project's jobs (journey.get, jobs.list); RunLine offers Pause (or Hold in the
    queue), Resume, Move up and Cancel as each job's controls allow and says what happened.
    Agents and tools shows each agent's status, Now, Queue and Today; an agent's page its
    work, queue and recent runs (runs now name their agent). job.updated also refreshes
    jobs.list. Mock jobs in web/src/mock/jobs.ts; the API's jobs.list answer in
    api-answers.json.
    Claude-Session: https://claude.ai/code/session_014dZPhZL8wy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
2026-10-27 test: design tools see no project in scope, whatever the runner sets
    On a GitHub runner GITHUB_REPOSITORY (with the test setup's TRACE_HOME) put the trace repository itself in scope, so
    design.intent read an empty journey instead of reporting it cannot read one, and the list had no note. The tests now
    clear the project variables a runner sets.
    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
2026-10-27 infra: the cost Lambda may call pricing:GetProducts; workers read installation/cost/prices.json only
    cost.priceList (enabled by default, optional endpoint): the Lambda runs when
    either the Cost Explorer read or the price list is on, told the region, its
    nearest Price List endpoint, the configured models and the pools' instance
    types. Its role gets pricing:GetProducts on * (no resource types exist).
    Each worker role and the in-Actions role may GetObject that one key and list
    only it; nothing else of installation/. The API gets TRACE_PRICES and
    TRACE_PRICE_LIST so its screens see the overrides too.
    Claude-Session: https://claude.ai/code/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
2026-10-28 Sample tour: the Analog specialist hands off a question to Thermal
    The tour must run every tool in the registry; journey.handoff and journey.handoff_answer had no task. Tour 3 now
    asks the thermal specialist whether the LDO option keeps U1 under its junction limit, without waiting, and the
    thermal job it starts answers.
    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
2026-10-28 Never fail a deploy over a runner's GitHub webhook; choose the connection
    A deploy failed with "Failed to create webhook. GitHub API limit reached or
    permission issue" on CiRunner600177d2 (trace's own runner) and rolled back
    TraceStack. The connection was authorized, but AVAILABLE says nothing about
    whether the AWS Connector app can reach the repository, and the installer's
    automatic choice can reuse any authorized GitHub connection in the account.
    Runner webhooks:
    - Build-only repositories' runners, and projects' runners in the nested
    layout, get their webhook from a custom resource
    (src/infra/lambda/runner-webhook.ts) instead of CloudFormation Triggers.
    When GitHub refuses, the depl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
2026-10-28 Keep test apps from synthesizing into a removed cdk.out on exit
    CI on main went red after #47 (and so on this PR), with every test passing
    but one unhandled error from test/infra/stack.test.ts:
    ENOENT … /tmp/trace-test-*/cdk.out/tree.json.
    test/setup.ts sets CDK_OUTDIR, which turns on every App's autoSynth: it
    synthesizes again on the worker's beforeExit, into the cdk.out the same
    file's afterAll has already removed. An app a test built to throw (assets
    already staged there, never synthesized) then fails writing into the
    missing folder. The webhook Lambda #47 added is staged earlier in the
    stack, which exposed it.
    setup.ts now removes the beforeExit listeners added while the file ran
    alo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
2026-10-28 Say why the agent image build failed, before the rollback deletes its log
    A deploy failed with "the image build failed in BUILD: Error while executing
    command: … docker build …". The message names only the phase and the
    buildspec command, and its log link points at a log group the stack's
    rollback then deletes, along with the build project, so the cause was lost.
    When a build fails, the poll handler now reads the end of that build's
    CloudWatch log and puts it in the error, which CloudFormation and the deploy
    output show: the lines that look like the cause (errors, failures, denials,
    rate limits, apt's "E:", npm ERR!) among the last 200, then the last 8, in
    order, trimmed from the front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
2026-10-28 Fix the image build poll handler returning null to the Provider
    #50 gave isComplete extra parameters (a context, and a logs client with a
    default) so tests could inject a client. Lambda calls every handler with
    (event, context, callback), so the logs parameter received Lambda's
    callback. On a failed build, logs() called that callback with no
    arguments, which ended the invocation with null, and the Provider framework
    failed with "Cannot read properties of null (reading 'IsComplete')". The
    build's real failure, which the change was meant to report, was lost.
    - isComplete takes the event only and calls checkBuild(event, clients),
    which the tests call with their own clients.
    - The tail kept f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
2026-10-28 Fit a failed image build's reason in CloudFormation's response; keep its log
    The deploy failed with AgentImage showing only "Response object is too
    long". A custom resource's response to CloudFormation is capped at 4096
    bytes, and the failure message from #50 overflowed it, so the reason was
    dropped:
    - it carried the whole buildspec command (about 700 characters) and up to
    2400 characters of log tail;
    - the Provider framework sends the message, a Logs line, and the error's
    stack after its first line, so every later line of a multi-line message
    went twice.
    The same failed build makes a 6831-byte response on main, 2910 with this.
    - buildFailure keeps the message within 2400 bytes as UTF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
2026-10-28 Install the Python headers the agent image builds cocotb with
    The agent image build failed (the first failure whose reason reached the
    deploy): pip "Could not build wheels for cocotb". cocotb 2.1.0 publishes
    no arm64 Linux wheel, only its source, so the linux/arm64 image builds it,
    and its C++ extensions include Python.h, which Ubuntu ships in python3-dev,
    not installed. Reproduced: the same source build fails with "fatal error:
    Python.h: No such file or directory" without the headers and succeeds with
    them.
    The GPU image builds on amd64, where cocotb has wheels, and installs
    python3-dev already.
    A test checks the agent image installs python3-dev before it pip installs
    cocotb; it fails wit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
2026-10-28 tracectl services: list, show, create, enable/disable, scopes, assign, rotate, retire-secret, delete, history
    Connected systems from the command line, through the API's services.* actions. create and rotate print the
    secret once with the token, API and MCP addresses and a ready curl line; delete asks for the name unless --yes.
    Claude-Session: https://claude.ai/code/session_014dZPhYAQHMyqscHEr3yutU
2026-10-28 Infra: external access behind external.enabled (scopes, external and MCP runtimes, API role grant, outputs)
    A Cognito resource server trace-external (read, write) on the people's pool, the
    <prefix>_external runtime (the API's image, role and environment in external mode,
    authorized by scope, no allowed clients) and the <prefix>_mcp runtime (MCP protocol,
    same authorizer, its own role for logs and spans only). The API role may manage the
    pool's app clients; the people's API is told both runtimes, the token address and the
    resource server. Outputs ExternalApiUrl, McpUrl, TokenUrl, ExternalResourceServer;
    both runtimes join the dashboard and log group outputs. The API environment is built
    once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
2026-10-28 Web: Admin > Connected systems (list, connect sheet, keys shown once, system page)
    A Data table of connected systems, a sheet to connect one (read only recommended; a read-only system is always a
    reviewer), a Keys panel shown once with copy buttons, addresses and three snippets, and each system's page:
    summary, projects and parts, keys (ids and dates; new secret, retire the old), history, disable and delete with
    the name typed. External access off is a friendly state. Mock fixtures for every services.* action.
    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
2026-10-28 Installer: the External access switch, and tests for external access in the stack
    The switch sits beside the library gateway's (Optional, Knowledge and monitoring),
    off by default, saved as agents.externalAccess and passed to the stack as
    external.enabled; the review row and the deploy plan say it, and the summary after
    installing gives the addresses and that an admin adds each system. Infra tests: with
    it off the template is unchanged; with it on, the scopes, both runtimes' protocol,
    authorizer (scopes, no allowed clients) and environment, the MCP role's limits, the
    API role's statement on the pool, the outputs and the dashboard.
    Clau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
2026-10-28 README: Connecting other systems; screenshot script for Connected systems
    What a connected system is, turning external access on, creating one (web app and tracectl services), getting a
    token, calling the API, connecting an MCP client, what systems can and can't do, revoking and rotating, and cost.
    On a system's page, say why Make a new secret is unavailable while it has two.
    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
2026-10-28 External access: the external runtime gets its own role, with no Cognito
    The internet-facing external runtime ran with the people's API role, which holds
    Cognito admin powers and the connected systems' client grant. It now has its own
    role, <prefix>-agent-external-<region>, made by the same function as the API's
    (src/infra/api-grants.ts grantApiRuntime) with only what the actions open to
    systems touch: no cognito-idp, no central database, prompts, chats, order watch,
    integrations or dictation. The people's API role is unchanged apart from
    ManageConnectedSystemClients, and with external access off the template is
    identical to before.
    Also in the infrastructure for the shared rate limit (next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
2026-10-28 External access: a shared rate limit, last used out of the access store, a task cap, and the review's smaller fixes
    M2: the per-container token bucket is now the first line only. A shared limit
    counts every external container in DynamoDB (TRACE_RATE_TABLE): 10 a second and
    300 a minute per system, fixed windows with a conditional ADD; 429 with
    Retry-After. When DynamoDB fails the request goes ahead and the failure is
    logged once (fail open: the limit guards capacity, not access). last_used is no
    longer written to the access store on the request path: one small object per
    system under access/services-seen/, a plain put at most every five minutes per
    container, read by services.list. A system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
2026-10-28 External access: a leaked secret's steps in the CLI and admin screen; plain service text in tracectl
    L4: tracectl services rotate, the system's Keys section and the rotated-keys
    panel say to disable first, then rotate, retire the old secret and enable again.
    Info: tracectl services show/list/history strip control characters and terminal
    escape sequences from descriptions and log text before printing.
    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
2026-10-28 Build the images without the installer page; name the cause in a failed build's tail
    The deploy failed building the agent image, 3 seconds into its build step:
    `npm run build` ran scripts/bundle-ui.mjs, which since 1a9caef bundles the
    installer page from the web app's components in web/src. The image's source
    leaves web/** out (as does an installed trace), so esbuild could not
    resolve "./components/ui/badge", "./lib/utils" and the rest. Reproduced on a
    copy of the source as the image receives it.
    - build:image: the whole build but the installer page, which only
    `tracectl install` serves. Both Dockerfiles run it. A test checks that
    build is build:image plus the page, so the two can't dri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
2026-10-29 Installer: create the sample again when it was deleted on GitHub
    An earlier run saves the sample as an existing project. When the repository is
    deleted afterwards, re-running the installer configured it as if it were there and
    the checks failed it as a token problem.
    - Page: the GitHub check now asks about each saved project. The sample, when
    GitHub says it is gone, is marked to be created again (sent as a new repository,
    so the checks pass), with a note and a way to leave it out instead. Any other
    saved project the token no longer reaches is left out and named on Projects.
    - Install: apply() checks the sample (recreateMissingSample) and creates and fills
    it again when it is missing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
2026-10-29 Installer: run each check by itself once its input is complete and valid
    No more Check buttons to press first. The page watches what is typed and, after a
    short pause, runs the check it enables:
    - the GitHub token, as soon as it is a well-formed token
    - the AWS account, on the AWS step once the credentials are complete
    - access to the projects, as they are ticked or added (several ticks, one check)
    - a distributor's keys, once every key it needs is in
    - the account again after a fix the installer made, so its effect shows
    A check that failed is not repeated until the input changes; Check again stays as
    a small button to force one. Which checks are due is pure (model.ts dueChecks) and
    unit t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
2026-10-29 Build the agent image in stages so it fits AgentCore Runtime's 2 GB
    The deploy got past the image build and failed creating the project's
    worker runtime: "Limit exceeded for resource of type
    'AWS::BedrockAgentCore::Runtime'. Reason: maxImageSizeMb limit exceeded".
    AgentCore Runtime takes images up to 2 GB, and the limit is not adjustable.
    Measured from Ubuntu noble's arm64 packages (downloaded, unpacked and
    gzipped as a layer) and the image's source copy, about half the image was
    files stored more than once:
    - npm ci's layer, with the dev dependencies: 1422 MB (441 MB gz), kept
    under the later prune's deletions
    - the final `chown -R trace:trace /app`, which rewrote all of /app into a
    la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
2026-10-29 Give the release step's IAM client a region
    Publishing trace's images failed with "Region is missing": the check for
    GitHub's OIDC provider built its IAMClient with credentials only. IAM is
    global, but the SDK still needs a region; it now uses RELEASE_REGION
    (us-east-1), like the rest of the step.
    Claude-Session: https://claude.ai/code/session_014dZPhZ51rSVdWLqN5NPrYV
2026-10-29 Move KiCad, Blender, the FPGA tools, CalculiX and ffmpeg into a per-project tools function
    AgentCore Runtime refuses images over 2 GB. The agent image keeps Node, the SDK, ngspice
    and Verilator (for the in-process co-simulation), and its build fails over 2e9 bytes.
    A new arm64 tools image (agent/Dockerfile.tools) holds the large programs and runs as
    each project's own Lambda function (nested layout), reached through runJob with the S3
    job protocol; kicad-cli goes through it as a kicad job, turntable videos as ffmpeg jobs.
    Flat installations send those kinds to the Batch queue (TRACE_TOOLS_ELSEWHERE).
    Claude-Session: https://claude.ai/c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
2026-10-29 docs: enclosure CAD engine design note (build123d over FreeCAD)
    Records the choice of build123d as trace's enclosure engine, the options
    compared, how it feeds the layout gate's fit criterion, and the decisions
    of 29 October 2026: JLCPCB 3D printing and CNC for cases, clearance
    defaults with per-project and per-part overrides, and three ways to
    change a case. Links it from the README's thermal credits, where FreeCAD
    is mentioned.
    Claude-Session: https://claude.ai/code/session_014dZPhXNFt3Ls4fqXSFfM8H
2026-10-29 Run CI on CodeBuild's Ubuntu 24.04 image
    Once the installation's CodeBuild runner took over trace's CI, the
    typescript job failed before any test: apt could not find nextpnr-ecp5,
    nextpnr-gowin or fpga-trellis. The runner ran aws/codebuild/standard:7.0,
    Ubuntu 22.04 (jammy), which does not have them; the workflows were
    written for GitHub's ubuntu-24.04 runners, where they pass. The default
    runner image is now aws/codebuild/standard:8.0, Ubuntu 24.04.
    The image is not saved in the installer's answers, so existing
    installations take the new default at their next deploy.
    Claude-Session: https://claude.ai/code/session_014dZPhZ51rSVdWLqN5N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
2026-10-29 Tools function: fixes from review
    - keep iverilog in the agent image: sim.logic runs it in-process
    - one Lambda attempt per job (a retried invoke would run it twice)
    - CalculiX goes to the tools function when it is not installed here, not the queue
    - formal on the function uses smtbmc: sby is not guaranteed in the tools image
    - a STEP model travels with its wrapper board (copied beside it, ${KIPRJMOD})
    - kicad-job writes into {dir}/kicad-out, apart from the runner's {dir}/out
    - the size guard fails on a missing image instead of passing
    - the custom runtime posts init errors only during init
    - EEVEE fails early on the function; its spans say function
    - check-imports strips comments first; the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
2026-10-29 test(api/web): keep the test server's idle connections past a slow runner's stall
    On the CodeBuild runner, test/api/web.test.ts failed twice in a row with
    fetch failed / read ECONNRESET at 'journey.snapshot is for admins'. The
    file's last HTTP call is near the top; the tests in between run about
    8 s there, much of it synchronous SQLite. With the event loop blocked
    past the server's 5 s keepAliveTimeout, both the server's idle timer and
    fetch's own one are due when it comes back, and the request goes out on
    the connection the server then closes.
    Reproduced locally by blocking the event loop 6 s before that test (the
    same ECONNRESET; an idle await of 9 s does not reproduce it). With the
    serve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
2026-10-29 Tools function: cost ledger, telemetry, shared uploads, flat layout
    - cost: each call is a ledger row of kind tools (Lambda's billed duration x memory and
    /tmp, and the call; built-in arm64 price, cost.prices.tools overrides). Ledgers made
    before it are rebuilt in place with the new CHECK, every row kept.
    - telemetry: the function gets the OTLP settings the Batch jobs have (service
    <prefix>-tools) and X-Ray write actions; spans continue the worker's trace.
    - uploads: an input of 1 MB or more goes once a week by its content to
    jobs/<slug>/cache/ (a HEAD instead of the upload when it is there), and a warm
    function keeps it in /tmp (3 GB at most). Tools-function jobs only.
    - flat layo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
2026-10-29 Test: hide an installed kicad-cli where the test needs a machine without one
    CI's runner has KiCad (/usr/bin/kicad-cli), so kicadWhere() found it with PATH cleared.
    Claude-Session: https://claude.ai/code/session_014dZPhWrzVRn5UVxB7GQdsr
2026-10-29 Test: keep the API test server's idle connections past the slowest test
    On a loaded CI runner the test before journey.snapshot ran close to Node's 5 s
    keep-alive timeout, and the next fetch reused the socket as the server closed it
    (ECONNRESET, twice on this branch's runs).
    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
2026-10-29 Trust GitHub's immutable OIDC subjects on every role GitHub workflows assume
    The release workflow could not assume trace-release: "Not authorized to
    perform sts:AssumeRoleWithWebIdentity". mteichtahl/trace uses GitHub's
    immutable subject claims (use_immutable_subject, sub_claim_prefix
    repo:mteichtahl@1817657/trace@1433970189), so GitHub sends
    repo:OWNER@OWNER_ID/REPO@REPO_ID:ref:refs/heads/main, and every trust
    policy trace makes matched repo:OWNER/REPO only. Repositories created,
    renamed or transferred after 15 July 2026 get that form by default, so
    the same failure waits for any new project's role and the self-update.
    - src/core/github-subject.ts: the immutable subject's pattern (no
    imp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
2026-10-29 Tools image repository: removed with the stack, and a kept one offered for deletion
    The failed deploy's rollback kept the empty trace-tools repository (Retain under
    retainData), and the next deploy would fail making it again. The tools repository now
    goes with the stack whatever retainData says (its images are rebuilt or copied), the
    stack outputs ToolsImageUri in both layouts, and the installer's preflight offers to
    delete a <prefix>-tools repository the stack doesn't own (delete-tools-repository).
    A removed installation's leftovers include it too.
    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
2026-10-29 mech: move rests and lid posts off parts on a board without mounting holes
    The fallback put a 6 mm rest and post at each corner of the outline, on
    whatever sat there: on the sample board they landed on the J2 header and
    the fit failed. Each pair now goes to the nearest spot from its corner
    (0.5 mm steps along both edges, up to 25 mm) that lies on the board and
    keeps every part's clearance in plan, and a note says how many were
    placed. The sample case now passes; the end-to-end test requires it and
    tests the waiver path with a failing build of its own.
    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
2026-10-29 Release role: allow ECR Public's bearer token when it sends no service name
    The release workflow now assumes trace-release, then fails logging in:
    "not authorized to perform: sts:GetServiceBearerToken on resource: *
    because no identity-based policy allows". ECR Public does not populate
    sts:AWSServiceName when it asks STS for the bearer token
    (aws/containers-roadmap#2896, open), so the StringEquals condition on it
    never matches. StringEqualsIfExists allows the call while the key is
    absent and keeps it to ecr-public.amazonaws.com once AWS sends it; a
    bearer token is only usable with the service that issued it.
    Claude-Session: https://cla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
2026-10-29 tracectl upgrade: a trace run from a clone is updated with git, not npm install -g
    Run from a clone linked with npm link, upgrade's `npm install -g
    github:mteichtahl/trace#main` failed (ENOTDIR: npm cannot rename the
    global package's link to move it aside), and succeeding would have
    replaced the clone with a packed copy. A clone has .git, a packed install
    does not: upgrade now says how to update the clone (git pull, npm ci,
    npm run build) and run `tracectl upgrade --no-pull`, and stops.
    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
2026-10-29 Images get the .npmrc's settings, never a credential in it
    The agent image's build failed at npm ci with E401 ("your
    authentication token seems to be invalid"): stage-image copied the
    clone's .npmrc into agent/npmrc as it was, and a local .npmrc can carry
    a person's token (//registry.npmjs.org/:_authToken=…). In the image it
    is sent with every request, so once it expires every install fails,
    public packages included, and it sits in the build's layers and the
    source asset meanwhile.
    - scripts/npmrc.mjs withoutCredentials: drops //host/: lines and the
    global auth keys (_authToken, _auth, _password, username, password,
    email, cert/key), keeps the settings; stage-image writes agent/npmrc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
2026-10-29 jobs: isolate cad jobs (scrubbed env, own process group); no case script for fork PRs
    A job with isolate (default for kind cad only) runs its program with an
    allowlisted environment (no AWS_*, Lambda runtime, container credentials or
    tokens), detached in its own process group that is killed when the job
    ends, here and in the function's runner (which keeps its credentials for
    S3; on the function HOME/TMPDIR/XDG move into the job folder). The build
    workflow sets TRACE_CHECK_MECH=0 for a pull request from a fork, and
    tracectl check then skips mech.build.
    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
2026-10-29 mech: repository paths by realpath, no symlinks; outline chaining by distance
    paths.ts: every file the mech tools read or write resolves inside the
    repository's realpath, not under .git/, and is not a symbolic link (writes
    with O_NOFOLLOW); case.json board/file must be relative repository paths.
    geom.ts chainLoops joins ends by distance (neighbouring cells), and
    reports open segments and ends; boardFacts errors on an open outline with
    its ends, and on a cutout or a part outside the outline.
    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
2026-10-29 Images get trace's committed .npmrc, not a clone's local edits
    After #72 the tools image still failed npm ci with E401. #72 left a
    clone's credential lines out of agent/npmrc but kept its other settings,
    and a person's .npmrc may also point npm at a private registry
    (registry=… CodeArtifact or a proxy): the image build then goes there
    without the token and every install fails, public packages included.
    In a git checkout stage-image now takes the committed .npmrc (git show
    HEAD:.npmrc), says when the working copy differs, and still leaves any
    credentials out; without git it uses the file there, as before.
    Claude-Session: https://clau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
2026-10-29 Images get the committed lock file while package.json is as committed
    The agent image still failed npm ci with E401 after #73. npm ci installs
    the lock's resolved URLs exactly, and an npm install run in a clone with
    a private registry in ~/.npmrc (CodeArtifact, a proxy) rewrites them to
    that registry; staged into agent/package-lock.json, the image build then
    fetches from it without a token.
    stage-image now stages the committed lock (git show HEAD:package-lock.json)
    while package.json is as committed, saying when the working copy
    differs. A clone that changed its dependencies keeps its own lock, with
    a warning naming any registry other than registry.npmjs.org it resolves
    from and how to re-r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
2026-10-29 API scratch under /tmp, not AgentCore session storage
    The web app's /api/call returned 503s: the API runtime answered after
    30 s to 8 minutes (me.get 481 s, projects 120 s), past the backend's
    50 s wait. Its log showed ENOTEMPTY removing /mnt/workspace/api/
    trace-journey-* folders, "RMDIR failed: directory is not empty" every
    30 s, and credential and timeout errors behind them.
    defaultScratch put the API's per-request copies (tempDb, the bucket
    stores) under TRACE_WORKSPACE, which the stack sets to /mnt/workspace:
    AgentCore's session storage, a network file system. Every request's
    SQLite I/O went over it, and removing the temporary folders failed.
    Nothing there outlives a request, so it is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
2026-10-29 mech: a case must be around the board; an open column fails its gap
    A part with nothing over (or under) it fails ('nothing covers U1 from above'); rays from the board out through
    each side, up and down must meet the case, and an edge gap over max(10 x edge_mm, 20 mm) fails, with 'the case
    is not around the board (likely a different origin or frame; KiCad's y is down)'. fit.enclosed says which.
    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
2026-10-29 mech: the lip hangs inside the base's cavity; rules measure the built sections
    The base's cavity is the inner cavity grown by lip_mm + assembly clearance, so the base keeps its full wall
    beside the lip (it was wall - lip - clearance = 0.6 mm). Default lip_mm 1.2 -> 2.0 so the lip meets MJF's
    2.0 mm. New rule rows with basis 'model' (base_wall, lip_wall, lid_wall, base_floor, lid_top) measured by ray
    probes in the parent. (Also lays in lip_h checking and CNC inner fillets, tested next.)
    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
2026-10-29 mech: refuse a lip deeper than the base has room for
    lip_h_mm may reach from the split down to 0.5 mm above the floor's top (more than MJF's ±0.3 mm tolerance, so
    the lid bears on the wall, not the lip); deeper is exit 2 with the room stated. Checked before any script runs.
    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
2026-10-29 mech: CNC cases fillet their inner corners; the rule measures them on the model
    For a CNC process the base's and lid's pockets get R = depth/10 + 0.5 inside vertical corners (the lip's outside
    corners follow the base's, less the clearance), and the cavity stands off far enough that the board's corners
    keep edge_mm. corner_radius rows (one per part) measure the radius by ray probes from where the walls are.
    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
2026-10-29 mech: material case-insensitive; one lead requirement; around on the part's side; boss rule; typed blocks
    - find_process matches the material ignoring case
    - through-hole leads on the far face need max(above_tallest_mm, below_mm), in heights() and the fit alike
    - a part's 'around' gap is measured to the case on its own side of the board only
    - 'standoff' rule row: standoff_d_mm >= pilot + 2 x the process's minimum wall (default 6.0 -> 7.0)
    - a non-object params/clearance/openings/process, a bad quantity, reasons or part reason is exit 2
    - clearance.parts and openings.skip refs not on the board are noted
    Claude-Session: https://claude.a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
2026-10-30 mech: run --built reads a build-only folder; build-only takes raw settings; files read once
    The cloud's two stages: the case script runs on the project's cad function
    as `build-only` (now checking and completing the raw case.json itself, with
    --capabilities for the process's assembly clearance), and the tools function
    checks its parts with `run --built`, running no script. Part files are
    numbered from 1. The private folder's files are opened once without
    following a link and checked on the descriptor, and a STEP is imported from
    the bytes read, so what is measured is what was checked.
    Claude-Session: https://claude.ai/code/session_014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
2026-10-30 lambda: a urls event runs on a UrlStore; the cad function refuses S3 specs
    handle() takes {"urls": {…}} (validated, the spec read through urls.spec, kind cad-script only) and runs the runner on
    a UrlStore; {"spec": "s3://…"} runs as before, except on the cad function (TRACE_CAD_FUNCTION_ROLE=1), which has no
    S3 and refuses it with a clear error.
    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
2026-10-30 A failure to check a token is 503, not 401: no session ends for it
    The web app showed 401s and 503s together, and signing in again did
    not hold. Three places answered 401 for a failure on trace's side,
    and a 401 ends the session:
    - jwt.ts: signing keys that could not be fetched (Cognito's JWKS
    timing out or erroring) threw AuthError, the error of a bad token.
    They are KeysUnavailable now. The web backend (deps.signedIn, and the
    id token check in the sign-in reply) answers it 503 auth_unavailable.
    - auth.ts /api/auth/refresh cleared the refresh cookie on any 401,
    including that one, so a passing JWKS hiccup during a refresh threw
    away a good session: every later call was a bare "no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
2026-10-30 mech: a custom case.py runs as a cad-script job, then a cad job checks what it built
    runCase compares mechanical/case.py's sha256 with the packaged template (printed-shell.py under the engine's python
    folder, TRACE_MECH_PYTHONPATH or python/): the template or a handed-in file is one cad job as before; anything else
    runs first as a cad-script job (build-only: facts, raw settings, capabilities and the script in; part-<n>.step and
    claims.json out; exit 2 names the script's own error) and then a cad job whose inputs carry those parts under built/
    and whose argv passes --built. The build's answer records the stages (kind, where, seconds, job id). Locally both run
    as child processes.
    Co-Authored-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
2026-10-30 check: the case builds in CI only when the workflow says so; paths checked by fstat
    tracectl check skips the case in CI (GITHUB_ACTIONS or CI) unless TRACE_CHECK_MECH is 1/true/yes, printing
    TRACE_CHECK_MECH_WHY or "TRACE_CHECK_MECH is not set in CI"; outside CI unset builds and 0/false/no skips
    (mechSkipReason in engine.ts). templates/build/kicad.yml sets 1 for pushes and the repository's own pull requests, 0
    with the reason for a fork's. paths.ts: the .git segment check ignores letter case at any depth, and a write checks by
    fstat against lstat that what it opened is the regular file at that path, else closes, removes a file it made and
    refuses.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
2026-10-30 mech: a write is checked by its real path; no script on the tools function, however asked
    From the third review. writeRepoFile opens without truncating, resolves the
    real path of what it opened (so a folder swapped for a link after the check
    is seen, not only the last component) and requires it under the repository
    before emptying the file. The tools function refuses a case script both as
    a urls event and as a cad-script spec in S3, so user code never runs beside
    credentials. A claims file nested too deep to parse is bad input, not a
    crash. The flat-layout message says a custom script is refused in the
    cloud rather than suggesting a fallback that does not happen.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
2026-10-30 A fresh clone runs git in the clone's parent, not the folder it creates
    The web app's requirements page failed: "cannot check out
    mteichtahl/trace-sample: git clone failed: spawn git ENOENT". gitIn's
    cwd parameter defaults to the clone folder (o.dir), and cloneDefault
    called git(['clone', …], undefined) meaning "no cwd"; an explicit
    undefined takes the default, so git clone was spawned in the folder it
    was about to create. Node reports a missing cwd as spawn ENOENT. Every
    fresh clone failed: the worker's tool checkout, and a job's first clone
    of a repository; only a folder kept from an earlier clone worked.
    The clone now runs in the parent, which cloneDefault makes first, and
    gitIn always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
2026-10-30 Tool calls move to a new session when the workers' code changes
    A session keeps the runtime version it started on, and the web app's held
    status calls keep a project's one tool session alive to AgentCore's 8-hour
    limit, so a fix to the workers (#82) reached tool calls hours after its deploy.
    The workers' image content tag (TRACE_WORKER_BUILD, written by the stack) is
    now part of the tool session's id.
    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
2026-10-30 Settings: save name, description, icon, build plan and later stages to the journey record
    The Settings page wrote project.name, project.description, project.icon,
    build.quantity, build.budget, build.unit_cost and stages.later through
    settings.set, but those are not repository settings: the config schema has
    none of them, so every save failed with "unknown setting".
    They are what the project is, and live in the journey record (as
    projects.create writes them). New admin action project.update changes them
    there through updateAbout, which logs a decision; turning a later stage on
    adds it with its gates, turning one off removes it only before it starts.
    The journey reader now passes the icon, bu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
2026-10-30 The bucket stores make their scratch folder before copying into it
    Since the API's scratch moved to /tmp/trace-api (defaultScratch), nothing
    created that folder: tempDb made its own, but BucketDb (the journey, facts,
    job index, cost, bench and shipping stores) called mkdtemp in it directly and
    failed with ENOENT, mkdtemp '/tmp/trace-api/trace-journey-XXXXXX'.
    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
2026-10-30 git trusts the runtime's clones on session storage (safe.directory)
    On AgentCore's session storage the clone's files belong to another uid than
    the runtime's user (trace, 10001), so git refused the repository as dubious
    ownership, and git config, the first command after the clone, said only
    "fatal: not in a git directory". gitAuthEnv now also gives safe.directory=*
    as command-scope config, which git honours, and the agent image sets it in
    its system config for git run any other way. The new test reproduces the
    error with a real git on a repository chowned away from the test's user.
    Claude-Session: https://claude.ai/code/session_014dZPh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
2026-10-30 A deploy that changes the API moves people's calls to new runtime sessions
    The web backend called the API runtime in one session per person, for good.
    A session keeps the runtime version it started on, and the app's calls keep
    it alive to AgentCore's 8-hour limit, so a signed-in person kept the old API
    for hours after a deploy: its old code, and its old TRACE_WORKER_BUILD, so
    tool calls still went to the old worker session (#85 took effect only once
    that session ended). This is why "git config failed: fatal: not in a git
    directory" outlived #89's deploy.
    The stack gives the web backend the API's image content tag
    (TRACE_API_BUILD), and runtimeSession hashes it into the session id.
    Co-Autho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
2026-10-31 Tool calls clone onto the container's disk; workspace removals retry
    "database is locked" on the requirements page: tool calls kept their clone on
    AgentCore's session storage (/mnt/workspace), and the tools' SQLite project
    database there never got its lock, so every call waited out the 30-second busy
    timeout and failed (the 30-second stalls seen before, and why the API's
    scratch had moved to /tmp). Tool calls now keep their clone in
    /tmp/trace-tools for the life of the session.
    Removals on session storage: rmdir right after the files can find the folder
    "not empty" (the storage logs "RMDIR failed: directory is not empty."), so
    removeDir retries, then moves a stubborn folder aside, and never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
2026-10-31 Jobs clone onto the container's disk; early job-index changes wait for the row
    A task (job-mvvr4jvw on mteichtahl/testyyyu) failed 30 seconds after its
    clone with "database is locked": jobs still cloned onto AgentCore's session
    storage, where the project database's SQLite lock never comes free (tool calls
    moved off it in #92). On AgentCore, workspaceDir now gives the container's own
    disk (/tmp/trace-work), kept for the session's life; session storage, which
    AgentCore wipes at each version update anyway, holds no clones.
    The same job also logged "could not write ... into the project's job index:
    a new row needs its kind, title and state": its "started" log line reached
    the index writer befor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
2026-10-31 Verilator verilates on one thread; test setup may take as long as a test
    main's ci for #94 (the tests on a CodeBuild xlarge machine, a fork per core)
    failed where its pull request had passed: Verilator's own pass, run with -j
    <all cores>, failed on the way out with "Internal Error: attempted to destroy
    locked Thread Pool", and two suites' beforeAll outran vitest's 10-second hook
    default. The C++ build stays parallel (--build-jobs) and the verilation runs
    on one thread (--verilate-jobs 1), which also spares the workers' simulations
    the same crash; hookTimeout matches testTimeout (60 s).
    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
2026-10-31 ci: run the TypeScript tests on the project's machine size again, not xlarge
    main has been red since the xlarge machine (36 cores): vitest starts a fork per core, and each Verilator build in
    the verify tests asks for every core as well, so Verilator crashed ("Internal Error: attempted to destroy locked
    Thread Pool") and the API tests' setup timed out (gaps, web). Back on large (8 cores), as before #94; the web job
    running alongside the tests stays.
    Claude-Session: https://claude.ai/code/session_014dZPhZ1CuqoVgHM6Ezc56L
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2026-10-31 Needs you lists the open pull requests trace's jobs opened
    In the browser test, testyyyu's Verification job opened PR #1 and Home still
    said "Nothing needs you": the inbox held only gates, spend, questions and stuck
    agents, though a job's work reaches the project's record only once its pull
    request is merged. The inbox gains a review kind: an open pull request whose
    head branch a job of the project's index worked on, for admins and
    contributors, not blocking, with a button that opens it on GitHub. A person's
    own pull requests are not listed; GitHub refusing the list leaves the rest of
    the inbox as it was and says so under unavailable.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
2026-10-31 A trace job's pull request shows its status live on Needs you
    A review item (#102) now shows its pull request's status under the summary:
    checks running, failing (by name) or passed, and whether it can merge, or that
    it was merged or closed. While the pull request is open the card asks again
    every 15 seconds and when the window regains focus; once it is merged or
    closed it stops, and the inbox refreshes so the item goes.
    pull.status (read) answers one pull request's state, GitHub's mergeable_state
    and its head commit's check runs (null when the token may not read checks).
    Claude-Session: https://claude.ai/code/session_014dZPhZ51rSVdWL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
2026-10-31 The run action's output descriptions are quoted, so GitHub's runner loads it
    A project's trace workflow failed before any step: "Unexpected value
    'structured output); worker-delegate — the worker's'" and "find unexpected
    ':'", Failed to load mteichtahl/trace/main/harness/actions/run/action.yml.
    Outputs are one-line flow mappings, and two descriptions had a comma ("read
    only, structured output") and a colon ("id@layer:version") unquoted. Every
    output description is now quoted, and a test checks that each input and
    output of the harness actions reads back as exactly its known keys.
    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
2026-10-31 Requirements review can be submitted, and moves the baseline gate
    Two gaps stopped the Define stage for every project:
    - "No conflicts or duplicates" ended in "cannot be checked yet" even
    with no duplicates and no conflicting intent, so Requirements review
    could never be submitted. The part no tool checks (the requirements'
    numbers against each other) is now the person's to confirm in Resolve
    conflicts; until they do, the check says what to do.
    - The baseline gate's person-owned criteria (every requirement accepted
    or struck; each measurable) had no act that met them: only agents'
    journey.check (trace-owned criteria) or a waiver changed a criterion.
    Submitting Requirements rev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
2026-10-31 Architecture choice: read and score every option, side by side
    Read each option and Score showed one block diagram, the recommended
    option's, and nothing else: no way to see the other options, their
    summary, why or risks, and no scores, though the steps ask the person
    to read each option and score each on each criterion.
    Those two steps now show every option with a switch (the diagram, what
    it is, why, what it gives up, its risks and any requirement none of its
    blocks serve), and Score adds the options side by side on the fixed
    criteria with each score's reason and the weighted totals. They are the
    Design tab's own pieces (components/project/architecture.tsx).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
2026-10-31 Traceability: a requirement from several intent lines covers each of them
    The graph marked 8 intent lines "not covered" on testyyyu while the
    summary under it said 2: layoutTrace kept one intent per requirement (a
    Map over the links, the last one winning), so a line whose requirements
    were all also linked to another line looked uncovered, and drew no line
    to them. Every link now counts for coverage, failure and the lines
    drawn; the requirement is still placed under its first intent line.
    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
2026-10-31 A lost job says what it was doing and how full its memory was
    Two jobs on testyyyu went silent mid-run and were marked lost after 15
    minutes; the record said only "trace lost contact with it", the job
    dropped out of "trace is doing" without a mention, and trace's chat
    could not read why (its logs are only in CloudWatch).
    The worker now keeps each running job's last 12 log lines and its
    microVM's memory in use and in all with every step write and heartbeat
    (new job index columns tail and vitals). A lost job's step and error
    carry them: "Its last lines: … Its microVM had 7900 of 8192 MB of memory
    in use at its last word (96 %)." The project's "trace is doing" keeps a
    job lost in the last da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
2026-11-01 Needs you card: a long recommended answer wraps inside its button
    A question whose recommended answer is a sentence (the specialist's 'Replace J1 with a fully SMD 16-pin USB-C
    receptacle…') kept its button on one line and shrank the question to one word per line. The buttons now take at
    most 40 % of the card and the recommended answer wraps inside its button.
    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
2026-11-01 tracectl check: skip DRC, and say so, while a KiCad project has no board yet
    Capture draws the schematic before Layout adds the board, and the brief forbids a .kicad_pcb at that stage, so a
    schematic-only push failed CI with 'project test has no board' and the ci-red worker was sent to 'fix' it. DRC now
    reports 'skip … no board yet (hw/test.kicad_pcb); DRC runs once layout adds it'; ERC still runs and still fails
    the check on errors.
    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
2026-11-01 Chat follows trace's reply; a task can carry on an open pull request's branch
    Two things found asking trace to apply an answer to the schematic PR (testyyyu #7):
    - The chat stopped following when the browser itself scrolled (scroll anchoring while the confirm card sized
    itself): any scroll event more than 160 px from the bottom let go. Only the person's own scrolling (wheel up,
    touch, keys, the scrollbar) lets go now, and overflow-anchor is off. Reproduced in a browser: main ends 877 px
    short of the reply, this ends at it; wheeling up still stays put, sending follows again.
    - task and start_task could not name a branch, so follow-up work on an open PR started from main and opened a new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
2026-11-01 trace-worker: pick can claim pull requests; a project's first vocabulary sync
    On testyyyu trace-worker failed on every push to main:
    - pick claims a conflicted or red PR with a comment on it, and a comment on a pull request needs
    pull-requests: write; it had read, so it failed ('Resource not accessible by integration') whenever there was a
    PR to claim, and the conflicted PR (#9) was never handed to the worker.
    - voice-vocabulary: Transcribe answers GetVocabulary for a vocabulary that does not exist yet with a
    BadRequestException worded 'couldn't be found', which the not-found check did not match, so a project's first
    sync threw. vocabularyMissing() takes that wording, with a test.
    C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
2026-11-01 A requirement whose acceptance changes after it was accepted is open again too
    #135 kept a requirement decision's words and reopened it when an agent changed them. A change of only the
    acceptance criterion (what it is tested against) slipped through: on testyyyu, R13's text stayed 'R5-R8 hold
    across 0 to 40 °C' while its acceptance moved from 0.45-0.55 Hz to 0.375-0.625 Hz. A decision now keeps the
    acceptance as well, and stops standing when either changes. A decision kept with the words only is checked on
    the words.
    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
2026-11-01 The harness retries a GitHub read that times out
    A trace-worker pick on testyyyu failed outright when GitHub answered the project database's git blob with a 504
    ('We couldn't respond to your request in time'). Reading the project settings (the default branch, the database's
    contents entry and its blob) now retries a 500/502/503/504 up to three times with a short backoff; a 4xx, or an
    error without a status, is still thrown at once. Only reads, which are safe to repeat.
    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
2026-11-01 An answered hand-off starts the asking specialist again when its job has ended
    A specialist that hands a question off is told not to wait: carry on, finish, and 'the answer is recorded for your
    next job'. Nothing started that next job. On testyyyu the Verification agent handed two failing worst-case tests to
    Implementation and ended; Implementation changed the circuit and answered, and Prove then sat with nothing running
    and both tests still marked failed.
    When a hand-off job ends having answered, the runtime now starts the asking specialist again (unless its job is still
    queued, running or paused, when it reads the answer itself), on the answering job's branch, told the question and the
    an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
2026-11-01 web: guided flow screens (stage guide, changes, review page)
    - Overview: the current stage's guide under the rail (purpose, steps with
    owners, gate meter and criteria, "What happens in <Stage>"); a segmented
    bar with "step N of M" on phones; the stage sheet from any rail stage.
    - Next-step card: "Step 3 of 5 in Capture", trace's recommendation with its
    reason in its own box, an After line, and Accept now for a ready change.
    - "Changes from trace" replaces Waiting on GitHub; a Changes tab (Data
    table) and a review page with files in trace's viewers (KiCanvas
    Before/After, text diff, pictures side by side), checks, requirements,
    recommendation, note box and a sticky decision bar (D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
2026-11-01 A specialist job whose record cannot be pushed fails instead of ending done
    keepRecord caught a failed commit or push of .trace/project.db and the runner only logged it, so the job ended
    succeeded. On testyyyu a Verification re-run re-parameterised and re-ran 18 SPICE items, recorded both Prove
    criteria as met citing those runs, and reported the gate ready to sign; its record never reached the repository (no
    branch was pushed; main still has both items failing), so the gate's evidence points at nothing.
    keepRecord now says whether the record was lost; when it was, the job fails with why and with its report, so the
    failure shows where people look (and a hand-off it answered is closed as fail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
2026-11-02 A project's GPU and remote-CPU jobs can be submitted: tagging is allowed on its job definitions
    Every Batch submit from a project's runtime was refused. SubmitJob tags the job, and Batch authorizes that
    batch:TagResource against the job definition as well as the job; ProjectGpuTag listed only job/*. On testyyyu,
    render.board and pcb.autoroute both failed with 'not authorized to perform: batch:TagResource on resource:
    ...:job-definition/trace-gpu-e0ed1629', so Layout had no autorouter and no renders for the person to approve.
    ProjectGpuTag now also names the project's own job definitions (GPU, and CPU when there is the CPU queue), under the
    same conditions: its project's tag on the request a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
2026-11-02 Board renders draw component bodies: the board's library 3D models are fetched for its export
    The tools and GPU images carry KiCad and its footprints but not kicad-packages3D (several GB), so every footprint's
    (model "${KICAD10_3DMODEL_DIR}/...") resolved to nothing and testyyyu's renders showed 12 parts with no bodies.
    Before a board's 3D export, the models it names from KiCad's library are fetched from KiCad's own repository at the
    kicad-cli's tag (10.0.8, else 10.0.0, else master): the .step a GLB reads (and the .wrl for VRML), cached on the machine
    so a part is fetched once, and staged in trace-3dmodels/ inside the folder the export runs from. Every KICADn_3DMODEL_DIR
    points there, in t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
2026-11-02 A token that may not read checks is named, so changes can be accepted in the app
    trace's fine-grained token was asked for without Checks: read, so GitHub refused the check runs and every
    change read 'trace could not read its checks' (and the screens said 'No checks yet'): Accept could never be
    ready on such an install.
    - The installer lists Checks: Read-only, and its preflight probes it and says what is lost without it.
    - A refused read (403) is said as that: who fixes it and how, and the change is blocked, not waiting.
    - Checks trace could not read show as 'not readable', never 'No checks yet'.
    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
2026-11-02 render: tracks show through the mask as lighter mask; black bodies stay black
    testyyyu's re-render (after #148 and #150) had its component bodies, but:
    - every IC and resistor body rendered as tin. A glTF material that gives no
    metallic factor is metallic 1, and dress() asked "metal and grey" before
    "dark", so KiCad's black plastic (about 0.02) became the Tin surface. A dark
    body is now black plastic; tin needs a light metal (L > 0.15).
    - the tracks were only faint relief: at alpha 0.8 a fifth of the copper showed,
    and as bare metal. The mask now mixes in a Transparent BSDF in its own hue
    (alpha 0.6), so copper under it reads as lighter mask, as on a real board.
    The mask fixture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
    [common.py, render_board.py]
2026-11-02 Read a change's checks from workflow runs and statuses when check runs are refused
    GitHub has no "Checks" permission for fine-grained personal access tokens (GitHub Apps only), so the
    previous commit's advice could not be followed. When check runs are refused, trace now reads the commit's
    GitHub Actions workflow runs (latest of each workflow) and commit statuses, which the token can read, and
    refuses only when both are refused. The installer and README no longer ask for Checks.
    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
2026-11-02 Tests: design.get no longer reports a missing export as a gap
    The app draws sheets and the board live, so the notes were removed; update the
    gaps test and regenerate the recorded web answers.
    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
2026-11-02 A chat tool call that would change the project record is refused, not reported as saved
    The web chat runs tools through the API on the project worker's scratch clone of the default branch, which is reset
    before the next call and never committed. The chat lets through tools the API classes as read, and that is by tool
    name: design.intent is read (its list action is) but its add, update and link actions write the record. So in test-2's
    Intent builder trace called design.intent add, answered that it had saved ten statements, and the record stayed empty.
    The tool runner now fingerprints the record's rows before and after each forwarded call (schema applied first, so a
    migration alone changes no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
2026-11-02 fix(web): a single $ is never maths, so currency stays text in chat
    Two dollar amounts in one paragraph ("the US$5 includes ... over US$5")
    were parsed by remark-math as an inline formula and rendered by KaTeX
    in italic maths type with the words run together. remark-math now runs
    with singleDollarTextMath: false, so only $$...$$ (inline or as a block)
    is maths. This renderer is shared by chat, the file and knowledge
    viewers, agent pages and run pages, so all of them get the fix.
    Adds markdown-impl.test.tsx: "costs US$5 per board, US$50 for ten"
    renders with literal $ and no KaTeX element (also while streaming), and
    $$x^2$$ still renders as maths.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
2026-11-02 Say when a project's agent is still being set up
    A project created in the web app gets its agent with the next installation
    update, but the app sent people straight into the Intent builder, where nothing
    could be saved and the chat only said so after a failed attempt.
    - API: project.agent (read access, as reading the project) answers whether the
    project's worker runtime exists (JobsApi.hasAgent, from
    TRACE_WORKER_RUNTIMES), and while it does not, how setting it up stands: the
    pending record under installation/pending-projects/ and, with the
    self-update on, the update's ci run on GitHub (cached 30 s). It gives the
    words to show, an estimate (about an hour from the update starting)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
2026-11-02 Tighten the agent-setup notice after review
    - project.agent gives the update's run link, and how to start the update again
    (Actions → ci → Run workflow), to admins only; everyone else is told an
    admin can start it again.
    - An agent the update added but the service never starts using: the estimate
    runs from added_at (10 minutes), then it says it is taking longer than usual
    and looks again every 5 minutes instead of every 20 s forever.
    - A request still pending more than 10 minutes after the update's run
    succeeded (GitHub's updated_at) is said plainly: the update finished without
    adding the agent, with the flat layout's project limit when that is the
    layout, and an admin can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
2026-11-02 Drafting: read the record only when it can change the step; one retry at a time
    Review of #168.
    - journey.get read the repository's record (default branch twice, the
    database once, uncached) on every look in Define. It is now skipped when
    nothing it says could change the step (no Submit and no drafting job: the
    intent step; or a next step that is not a task or trace working), and the
    requirement count is kept per default-branch commit and record version in
    the GitHub cache. Test: repeat looks after the requirements exist cost no
    further GitHub calls; the intent step costs none.
    - requirements.draft logs a decision with its attempt and time. The "just
    started" grace counts from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
2026-11-03 Process metrics: waits on people, lost jobs counted once, rework
    trace.project.wait (seconds, kind question|change|gate) is recorded once a
    person's act is saved: question answered (asked to answered), change accepted
    (ready to accepted; ready is when the head commit's last check finished) and
    gate signed (last criterion met or waived up to the signature, never negative).
    Lost jobs are stamped lost_at by the project's worker inside the index's
    conditional put (markLost) and counted once as trace.jobs outcome lost.
    trace.project.rework counts work done twice by cause. journey.time returns
    each stage's length and its wait on people. The harness bundle is rebuilt:
    it bundles src/core/telemetry.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
2026-11-03 Dashboard Process rows and Operations' processView
    CodeBuild's own SucceededBuilds/FailedBuilds for every <prefix>-ci-* runner,
    jobs by outcome (lost included), waits, rework, job time and the whole-range
    medians. Operations reads them into a Process view and the tiles Builds
    passed, Agent jobs finished, Waiting on people and Time trace was working.
    Median run time now reads a job's own duration: the runtime's Latency is how
    long an asynchronous invocation takes to be accepted (milliseconds), which is
    why it showed 0 s.
    Claude-Session: https://claude.ai/code/session_014dZPhaVEesaBCbHNrXhc1v
2026-11-03 A change request shows its impact, so it can be submitted
    The Change request step "See the impact" waits for the impact trace traced (stages that reopen, gates to re-sign,
    evidence that goes stale) and keeps its acknowledgement disabled until it has one. Nothing in the API produced it,
    so the box never enabled, the quality bar's "Impact shown and acknowledged" could never be met, and no change
    request could be submitted. Found in test-2: a person's request for 4 x M3 mounting holes was stuck at step 4.
    skill.get for change-request now returns `impact` from the journey record: the stages from the earliest one the
    change touches (requirement: Define, block: Architect, part: Capture, firmware: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
2026-11-03 changes: people's app edits listed, accepted and applied in trace; repo.rules.fix
    An admin's own edit applies once its checks pass (hook.apply after each GitHub
    event, changes.list as a fallback); someone else's waits for an admin in the app.
    Edits are made again on the newest design when it moves on. The records live
    under the journey's folder, so no IAM change. An admin fixes a repository rule
    that requires a review from the change itself.
    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
2026-11-03 stay in trace: hand in design files, edit CLAUDE.md in the app, the update's steps, GitHub links for admins only
    - design.handin (src/api/actions-handin.ts): KiCad files handed in as one commit on
    trace/handin-<slug>-<time>, same-as-design files left out, recorded as an app edit
    - files.edit (src/api/actions-files.ts): a text file (CLAUDE.md) edited in the app
    - settings.set, prompts.set (project) and journey.snapshot record their edit and answer `change`;
    prompts.get answers `pending` with the change's number
    - project.agent's update gains steps and failed_log (admins), read from the run's jobs
    - web: Get the design files (.zip) and Hand in your edits on the Design page; the update's st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
2026-11-03 web: edits and the rule fix on the change screens; downloads for files the app cannot show
    The changes list and Changes tab tag people's app edits with their kind and show
    Applying; the change page reads an edit as what it changes, has no Ask for
    changes on one, and no Accept on one trace applies itself. Admins fix a
    repository rule that asks for a review from the change. GitHub's page moves to
    the admins' More menu; a binary file downloads before and after from the app.
    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
2026-11-03 deploys: approve, skip and roll back in trace; the workflow checks the approval
    deploys.get, deploy.approve, deploy.skip and deploy.rollback (src/api/actions-deploys.ts). An approval is a record
    only the API writes, under projects/<slug>/journey/deploys/ with a conditional put; trace starts trace-deploy.yml
    with its name and the commit. The workflow's new in-trace job reads it with TRACE_AWS_ROLE and deploys only when it
    exists, names this repository and commit, has not expired, and today's checks pass. A rollback approved in trace
    runs the existing rollback job. Setting deploy.people names who may decide besides admins.
    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
2026-11-03 web: the Deploys panel on the Build tab
    A request waiting asks "Deploy <project> to <environment>?" with the changes since what runs now, trace's
    recommendation and its reason, and Deploy / Skip this one for a person who may decide. A deploy's step shows live,
    results show by whom and when, and an earlier deployed commit can be rolled back. The GitHub link is in the admins'
    More menu only. Mock answers in web/src/mock/deploys.ts.
    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
2026-11-03 Phone: next step first, Next queue, Sections sheet, locked gate reasons
    - Inbox becomes Next: one card at a time with Later and Up next; /inbox redirects
    - Project page on phones: stage as one tappable line, next step first with its
    buttons pinned above the tab bar, other sections folded into one-line rows
    - Sections sheet replaces the sideways tab row on phones, with status lines
    - After accepting: Go to next · N left
    - Gate: Sign stays locked when no criteria are reported or any is open, and
    the phone says which checks are open
    - Guided skills on phones: one step count, Ask trace in the step bar instead of
    a floating button, Submit says how many checks are left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
2026-11-03 worker: record work given up on as a stuck note the app shows
    The pick also brings the agents' facts in line: a stuck note per item at
    worker.max_attempts (what was tried, the last report, trace's
    recommendation), resolved once the item moves on. The pick job takes the
    repository's OIDC role for it; without it only GitHub says so.
    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
2026-11-03 health: the build's health and a failing job's log, read in the app
    health.get: the default branch's latest build, its failing jobs and steps
    with their log extracts, ci-doctor's judgement or the failing step in plain
    words, trace's work item on it with its attempt, and the open requests for
    a fix with the job on each. health.log: one job's log, its last 200 KB, only
    for this repository's runs.
    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
2026-11-03 web: the build's health on the project overview, and Ask trace to fix something
    A red card when the build is failing (or running again after a failure):
    what failed in plain words, the failing step's log extract, the whole log
    in a sheet, and Watch trace fix it. The fixes asked for with where each
    stands, and a dialog that turns a person's words into a task.
    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
2026-11-03 security review: edits change only their own files, approvals are used once, code owners' review kept
    - an edit records the files it may change; a pull request that changes others (a
    commit slipped in under trace's) is never applied or accepted
    - a review edit is held when opened, so automerge never merges it unaccepted
    - joining trace records only the commit onboarding pushed
    - a deploy approval deploys once, only while it is the newest, within 30 minutes
    - trace's rule keeps code owners' review when escalate_to is set, and the rule
    fix never removes it
    - the 6 MB body is judged by the parsed action
    Claude-Session: https://claude.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
2026-11-03 Lock Fabricate while changes are pending; a changed requirement returns to Define
    Nothing goes to Fabricate while the design is still changing:
    - The gates into Fabricate (Sign-off's release approval, which passes Release, and
    the order approval) cannot be signed while a change trace made is open, a
    requirement changed after the baseline is unagreed, or trace cannot check.
    journey.get shows the lock on the gate and turns the next step into settling
    the change; gate.sign asks GitHub fresh and fails closed.
    - A requirement or intent that changes after the baseline takes the project back
    to Define (core returnForChange): later signatures are superseded, the
    baseline's person criter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
2026-11-03 Silkscreen is never interrupted by solder mask: a system-wide design rule
    - New locked prompt design.silkscreen, added to every prompt an agent
    designs from: the runtime system prompt (all specialists, delegates and
    workers), Ask trace chat, the GitHub Actions item worker and the cloud
    worker. Locked, so no installation or project override can drop it.
    - kicad.drc enforces it: "Silkscreen clipped by solder mask"
    (silk_over_copper) is always an error, even when the board waives or
    excludes it, and a project that sets the check to "ignore" gets an error
    saying so.
    - Gerber clipping (subtract_soldermask) stays on as a last safety net so
    bare pads never get ink, but the design must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
2026-11-03 memory: report what memory did on every job, and let the API read short-term events
    Memory failures were silent by design (a job never fails for memory), so
    'the agents store no memories' could not be told apart from 'nothing
    extracted yet'. Each job now records a memory status (off, saved,
    partial, failed, with the reason) on its job info and span, and ends its
    log with one line saying so; the GitHub Actions path warns when writes
    fail. A worker without TRACE_MEMORY_ID now says memory is off.
    The API gains memory.events (read only: ListSessions, ListEvents) so the
    web app can show what agents saved before long-term records are
    extracted: the project's agents and the caller's own person act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
2026-11-03 Agents' metrics reach CloudWatch: name each runtime's metrics log group
    None of trace's own metrics (jobs, tool calls, cost, waits, rework) ever
    reached CloudWatch: AgentCore does not set OTEL_EXPORTER_OTLP_LOGS_HEADERS
    for a custom container, and without a log group and stream ADOT's EMF
    exporter drops every metric. Each runtime now names
    /aws/bedrock-agentcore/runtimes/<name>-metrics (stream trace-metrics,
    namespace bedrock-agentcore), which its role may already create and write;
    ADOT creates the group on its first write.
    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
2026-11-03 web: let people stop the voice from playing
    - Stop now also cancels a voice that is still loading (it used to start anyway)
    - the speaker button on a reply turns into Stop while that reply is read
    - Stop voice in the chat header while speaking; Escape stops it anywhere
    - a floating Stop voice button when the chat panel is closed
    - the player bar shows 'Getting the voice ready…' with Stop while loading
    - moving to the next queued reply no longer drops the rest of the queue
    Claude-Session: https://claude.ai/code/session_014dZPhWX4gfKby92W7b6pTV
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2026-11-03 Show the project record when reviewing a change to it
    files.url refused .trace/project.db outright, so a change touching the
    record opened its database compare and failed with "There is no file
    .trace/project.db to show." At a named commit (a change's before or
    after) the record's bytes are now answered; it stays out of the Files
    list and default-branch browsing.
    Claude-Session: https://claude.ai/code/session_014dZPhZZwugcftuVc4DNLSm
2026-11-03 web: draw traceability and block diagrams with React Flow, lighting a selected box's chain
    Traceability (Requirements tab, skill steps): selecting an intent line,
    requirement or piece of evidence lights its whole chain, upstream to the
    intent and downstream to the evidence, and fades everything else. A
    failing chain stays red when lit. Opening a requirement from the table
    lights its chain too.
    Block diagram (Design tab, architecture skill steps): selecting a block
    lights it, every block it connects to and the connections between them
    with what flows along each. The lit block stays lit after its detail
    sheet closes. The layout is wider so connection labels read clearly, and
    the view fits the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
2026-11-03 Job index: retry a job's end instead of dropping it; stay busy until it lands
    Finished jobs were shown "lost" 15 minutes after they succeeded (job-mw0cn2v7,
    job-mw05bpat: "succeeded" in their last lines). Two causes:
    - A write to the project's job index that failed (conditional puts kept losing
    to other writers, or the bucket did not answer) was dropped. When that write
    was a job's 'ended', its row stayed "running" until declared lost.
    Failed writes are now kept and retried with backoff (2 s doubling to 60 s,
    for up to 10 minutes), newer changes winning.
    - /ping answered idle as soon as a job ended, before its last write landed,
    so the session could be stopped with it unwritten. T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
2026-11-03 Lock every stage's gate while its work is pending
    A gate is no longer reviewed or signed while its stage has open changes
    (its own or an earlier stage's, or of unknown stage), while an agent job
    is still queued, running or paused, or while trace cannot check. The gate
    page shows what is pending instead of the review; gate.sign refuses with
    the same words; the next step becomes reviewing the change or watching
    the job. The gates into Fabricate keep their existing rules.
    Claude-Session: https://claude.ai/code/session_014dZPhXDNbgEaogngx4C3jU
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2026-11-03 web: expand "Requirements it covers" on the change review page
    Each requirement a change names now opens in place: its words, criterion,
    kind and priority, where it stands, and its tests, with an "Open REQ-…"
    link to the requirement itself. Up to three start open; more start folded
    with an "Open all" button. A short id ("REQ-9") links to the project's own
    id ("REQ-009"), so the link always lands on the requirement.
    Claude-Session: https://claude.ai/code/session_014dZPhYUQWKm6VpcrUKV9uX
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2026-11-03 Conflicts: the app hears of them and trace resolves them
    Merge conflicts stalled because GitHub reads every pull request as "unknown"
    for a few seconds after a push to the default branch, so the pick and update
    queue that push started skipped the very conflicts it made; they then waited
    for the hourly safety net or the worker giving up, and looked like they
    needed a person.
    - harness: settle mergeability before judging (src/harness/mergeable.ts) in
    worker-pick and update-queue
    - web hooks: take push events; a push to the default branch asks the API
    hook.conflicts and tells the project's people which changes conflict
    - API: resolveConflicts remakes trace's own edits and starts the worker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
2026-11-03 Files: view every result trace's tools keep, on phones and wide screens
    SPICE rawfiles (tran/ac/dc/noise charts, op as a table), Touchstone .sNp
    (|Sij| dB and phase on a log axis, option line honoured), numeric CSV/TSV with a
    Chart/Table switch, single-file gzip unpacked in the browser and shown with the
    inner file's viewer, KiCad ERC/DRC and findings JSON as a findings list with a
    Show the file toggle, more text result extensions as code, and a sentence for
    binary CAN logs. Charts thin to 4,000 points (min/max-preserving) and zoom inside
    their box; the VCD viewer draws at real pixels with a sticky names column.
    Pure, unit-tested converters in files/parse; mock samples for each.
    Co-Authored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
2026-11-03 web: test results and run steps on a phone
    Change page: one checks line under the title on a phone and the files folded
    into one row; every check opens a sheet (change.check) with its result,
    findings, log, and previous/next; admins get the GitHub link under More.
    Run page: Result, Steps, Log, Files tabs on a phone; steps come from the
    run's session (falling back to steps); a failed step opens to its args and
    result; run files open in the shared file viewer, with a one-line reason for
    files too large to open. Evidence: one-line coverage rows with quick filter
    chips and a runs list on a phone; the tab shows from Capture on. Data table
    phone cards get a chevron and a pressed state. Mock change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
2026-11-03 Fix blank Before pane in side-by-side board and schematic views
    KiCanvas keeps one static shader per drawing class (polygon, polyline,
    circle). When a second viewer starts on the same page it overwrites that
    shader with one compiled in its own WebGL context, so the first viewer
    (Before) draws nothing ("no valid shader program in use"). Keep the
    shader per WebGL context in a WeakMap and look it up in the constructors.
    Claude-Session: https://claude.ai/code/session_014dZPhb7y1X9B7zYFgTDu8m
2026-11-03 render.board: render as GLB on trace's Blender images; enable or explain the X3D importer
    render.board picked VRML whenever no probe was cached locally, which is always the case for a
    render on the GPU queue or tools function. Blender 4.2+ no longer bundles the X3D/VRML importer
    (and 4.0/4.1 ship it disabled under --factory-startup), so bpy.ops.import_scene.x3d was missing.
    - Unprobed remote renders now use GLB: both images ship numpy, so glTF import works.
    - A probe that shows no X3D importer also chooses GLB; probe.py reports x3d_import.
    - common.py enables the X3D add-on/extension when present, else fails with a clear message.
    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
    [common.py]
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2026-11-03 Release review counts trace's own checks before approving
    Submitting Release review checked the raw journey record for coverage,
    interference and the parts list. Those are trace's criteria, met by its
    agents' checks, which live beside the record and are merged into every
    view. Read alone, the record always showed them unmet, so the report could
    never be approved (test-2). The guard now merges the agents' checks first.
    Claude-Session: https://claude.ai/code/session_014dZPhaRm47h9F72hjqXHQb
2026-11-03 Ontology phases 1 and 2: the core and journey modules, the mapping, the graph and history
    trace's ontology (docs/ontology.md) begins: the vocabulary taken from trace's own tables, gates and records, and the
    journey record, the agents' facts and the job index readable as one graph, with CI catching any drift between the two.
    - ontology/: trace-core.ttl and trace-journey.ttl (one namespace, https://trace-eda.com/ns/trace#; 47 classes, 157
    properties, each with a plain-words label and comment), trace-si2-align.ttl pinned to Si2 commit 664164c with the
    terms that commit defines (si2/terms.txt), and the JSON-LD context written from the ontology.
    - src/ontology/: vocab.ts reads the files; map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
2026-11-04 Ontology phase 4: evidence gone out of date reads as not met, and blocks signing
    - src/core/journey.ts withStaleEvidence: a met criterion trace owns whose evidence cites a run that no longer stands
    (its lineage, src/ontology/lineage.ts) reads as not met, with why, until a check on current evidence meets it
    again. The record is not changed; a person's criterion stays the person's call. signGate takes the same staleRun,
    so a gate cannot be signed on out-of-date evidence. staleCriteria lists them.
    - src/api/evidence-freshness.ts: the cited runs' lineage against the default branch's files, one read of the run
    record; anything that cannot be read leaves the criteria as they are (never a g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
2026-11-04 Chat: draw diagrams, timing diagrams, plots, drawings and images
    Every picture in a chat message now sits in one frame with Full screen
    (pan and zoom), Download (SVG/PNG, or a plot's numbers as CSV) and Source.
    - ```mermaid diagrams move into the frame; SVG labels so PNG export works
    - ```wavedrom / wavejson / timing: timing diagrams via WaveDrom
    - ```plot / chart: line, step, bar, scatter or area charts (JSON5), with
    limit line, verdict and pass/fail badge
    - ```svg: small drawings, sanitised like SVG files
    - images open full screen with pan and zoom
    - quiet "Drawing…" placeholder while streaming; source plus a plain
    reason when a picture cannot be drawn
    - fix: markdown components wer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
2026-11-04 Overview: a paused or retired project's Next step says so
    The usual Next step card nudged people toward work a paused project refuses.
    While paused (or retired) it is replaced by a card that says nothing happens
    until it is resumed, who paused it and why, and that the banner's Resume
    button carries it on (or, for a Reviewer, who can). Ask trace to fix
    something is hidden too.
    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
2026-11-04 Stacked changes: fail closed, merge commits under a stack, safer restack
    From an independent review. open-pr now finds a branch's parent by commit
    membership (an open change's tip or any of its own commits in the branch), so a
    parent that moved on is still found; any doubt (a failed lookup, two unrelated
    open changes, too many commits) opens no PR rather than one that could carry
    unaccepted work to the default branch. A PR others are stacked on merges with a
    merge commit whatever prs.merge_method says. restack holds a PR while it
    retargets and updates it, trusts only a sure merge of its base, skips the
    compare when the base has not moved, writes nothing without TRACE_TOKEN, tells a
    conflict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
2026-11-04 Stage guide: a paused project's steps are on hold
    While a project is paused or retired, the stage guide's steps not yet done
    are greyed, unlinked and read "On hold" instead of who does them and when,
    and the step that was yours is no longer highlighted. On the Overview's
    panel and in the stage sheet.
    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
2026-11-04 Ontology phase 5: the stock and parts list criteria as shapes
    - parts.bom_check is now recorded (kind parts.bom_check, subject the parts list file or
    "rows"), and keeps every line in a new project table, parts_list_lines. The boards,
    blocking and total figures are kept as measurements.
    - Ontology: PartsListLine with its properties (trace-board 0.3.0). stock is no longer
    limited to offers. A line links to the part it names (part_key, mpnKey). The derived
    buildQuantity (journey 0.2.0) comes from the journey's build plan.
    - Shapes:
    - capture.stock: the newest check of the parts list file (failed runs and inline rows
    do not count) is for the build quantity, and no line is out, shor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
2026-11-04 Stacked pull requests: merge a base in with the merges API, not "Update branch"
    GitHub refuses pulls.updateBranch for a stacked pull request, one whose base is not the
    default branch: "Updating a stacked PR's branch via this endpoint is not supported" (403).
    The restack job in stack.yml failed that way on every push to a stack. The first case seen
    was #227 pushed, with #228 above it. The harness's restack (src/harness/stack.ts) had the
    same call for project stacks.
    Both now merge with repos.merge: base is the pull request's branch, head is the branch to
    bring in. It makes a merge commit (201), is already up to date (204), or reports a
    conflict (409). Merge commits only, as before. The "head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
2026-11-04 Ask trace: never lose a message sent while the panel is still opening
    The chat smoke test failed intermittently in CI because of a real race in the
    panel. Opening Ask trace starts a lookup for the project's last conversation;
    until it answered, the panel showed a new conversation one could type into. A
    message sent then made its own thread, and the lookup, answering late with a
    list read before that thread existed, switched the panel to the older
    conversation, so the message vanished. A message sent while a stored
    conversation was still loading was also overwritten when the load landed.
    - The panel shows a conversation only once it knows which one ("Opening your
    last conversation…" mean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
2026-11-04 Smoke user: least privilege, a sign-in checked before it is kept, clean removal
    From an independent review of the first commit:
    - the smoke user is an ordinary user and a Reviewer of the smoke project only,
    not an admin: it no longer shows up as an admin on every project, can't sign
    or count as a reviewer, and its stored sign-in can't reach the admin screens.
    Live runs skip those (TRACE_SMOKE_ADMIN=1 for an admin account)
    - live runs keep no traces, screenshots or HTML report (the repository is
    public); the job uploads results.json only, for 7 days
    - a later install keeps the user only after signing in with what is stored
    (password, then an authenticator code); otherwise it gets n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
2026-11-04 A shape's finding waivable on its own, from the gate
    - shape.check gives each finding an id: the criterion and the record it is about
    (architect.mapped@urn:trace:…:requirement:REQ-1; a finding about the whole project is
    @project). An open waiver of kind finding on that id excuses that finding only. It is
    listed as waived in findings.json and counted, and no longer holds the criterion.
    The finding's evidence ref is its id.
    - The waiver skill lists a criterion's unwaived shape findings as waivable, with the run
    that found them as evidence.
    - Gate view: each finding under its criterion has "Waive this one…", which opens the waiver
    skill on it.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
2026-11-04 Project templates in installation settings: core, store and API (plan P5.6)
    The code's catalog (moved unchanged to src/core/journey-catalog.ts, re-exported from
    journey.ts) is the default each installation is seeded with. Admins change a template
    within it:
    - name it;
    - choose its stages (in catalog order, Define first, the later stages always present);
    - choose each gate's criteria (any template's) and reword them;
    - add criteria a person signs off;
    - reword each stage's guide.
    A stage's gates, the owner of a criterion trace checks, and the template ids stay the
    code's (templateProblems says what is wrong, in words).
    - src/core/templates.ts: TemplateDoc, catalogTemplate, templateProblems,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
2026-11-04 Templates in installation settings 2/3: the admin screen, and signing off an added criterion
    - Admin › Project templates (web/src/routes/_app/admin/templates.tsx,
    components/templates/template-editor.tsx). The four templates, each "trace's own" or
    showing its version and who changed it. The editor offers:
    - the name;
    - every catalog stage with a tick (Define and the later stages fixed);
    - per gate, the catalog's criteria to tick, reword or put back to trace's words;
    - criteria a person signs off, which an admin adds, with their evidence;
    - the stage guide.
    The API says what is wrong as the admin works (templates.check). Save makes the next
    version with a reason; "Back to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
2026-11-04 templates.test: copy a stage with structuredClone (the test typecheck caught the wrong type)
    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
2026-11-04 Ontology phase 6, 2/2: the graph view's kinds from the ontology, with gates, criteria, waivers, outputs, placed parts and nets, and stale runs (P6.3, P6.4, P6.5)
    - trace:graphKind on each drawn class; scripts/graph-kinds.mjs generates the server's and the app's node kinds from it, and a test keeps both equal to the ontology
    - graph.neighbourhood draws gates, their criteria (met, waived, failing, untested), waivers, each run's outputs and the runs made from them, the board's placed parts and their nets
    - a run made from a file that changed on the default branch, and its outputs, are drawn stale with why
    Claude-Session: https://claude.ai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
2026-11-04 Ontology phase 7, 1/4: the mechanical module, and a case stale only when what it depends on changes (P7.1, P7.6)
    - ontology/trace-mech.ttl: the case, its parts, material, fasteners, mounting points, standoffs, openings and joints
    under the names case.jsonld uses, plus the fit check's problems, the process's rule results, the case settings with
    each part's clearance, and each placed part's space
    - src/ontology/mech.ts reads the newest mech.build run into the project's graph: case.jsonld as it is, fit.json's
    problems named by what they are about (so a waiver outlasts a rebuild), result.json's rules, the settings as built
    and the board facts; with a file reader, whether the build still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
2026-11-04 memory: a chat actor, memory.remember, and scoped CreateEvent for the API
    The web app's chat could not remember anything: nothing outside agent jobs
    wrote short-term events, so AgentCore never extracted facts, preferences or
    session summaries from conversations.
    - src/agents/runtime/memory.ts: a `chat` agent actor (<owner>/<repo>/chat,
    chatActor; in AGENTS so memory.events and memory.list show it) and
    chatSession(thread) for one session per chat thread.
    - src/api/actions.ts: memory.remember (write: contributors and admins; a
    read-only guest is refused). Records one user event marked as something the
    person asked to remember, under the caller's own person actor (personal) or
    the pr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
2026-11-04 Fix a cost test that failed when a stage started at second 48.5: the money check now ignores timestamps
    build-cost.test.ts checked that a non-admin's cost.get answer holds no money by matching /48\.5/ against the whole
    answer, which also matched a stage's start time such as 12:37:48.560Z. Times are now left out before the match.
    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
2026-11-04 Ontology phase 7, 2/4: the layout.fit shape, and the Case view (P7.2, P7.7)
    - ontology/shapes/layout.fit.ttl: the board fits its enclosure, or each clash is waived. Met only when there is a
    case build, it still stands (by its lineage against the repository's files), the case closes around the board, and
    every clash, gap, missing opening and failing rule is fixed or waived on its own. A problem is named by what it is
    about (case-finding:clash/J1/lid), so its waiver outlasts a rebuild
    - shape.check reads the working tree for freshness; mech.build, mech.fit and the Implementation specialist now hand
    layout.fit to shape.check instead of journey.check
    - design.get `case` (src/api/case-rea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
2026-11-04 chat: record conversations in memory, and remember on the person's Confirm
    Builds on claude/chat-memory-core (the chat actor, memory.remember and the
    API's scoped CreateEvent).
    - src/api/actions-chats.ts: chats.append and chats.reply also record each
    kept turn, best-effort, as a short-term event in session chat-<thread>: the
    conversation under the project's `chat` actor (only from people with write
    access), the person's own turns under their person actor (hash of their
    sub). Tool rows are recorded as name and outcome only, never payloads.
    Scrubbed and bounded by shortTerm.record; a memory failure is logged and
    never fails the chat; the wait is capped at 4 s.
    - src/web/agui.ts: a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
2026-11-04 memory.remember: rate limit, own-thread check, real partition; chat IAM headroom test
    Security review fixes for the chat's memory grant and memory.remember:
    - src/infra/api-grants.ts: the chat's CreateEvent statements named the memory
    in partition `aws` always. They now take the region's own partition
    (aws-cn, aws-us-gov, ...), written out as a string (RegionInfo), and the
    stack's partition reference for a region CDK does not know. Written out, so
    sixty statements still fit the API role's managed policies.
    - src/api/actions.ts memory.remember: held to the chat's soft limit on writes
    (limited, as chats.append is), and its optional `thread` must be a
    conversation on that project t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
2026-11-04 Revision renders 2/4: render.showcase — the board, the case, the board in the case and an exploded view
    python/blender/render_showcase.py renders six shots in one Blender run: the board (three-quarter, top, bottom), the closed case, the board in the base and an exploded view with a gap between each part. The board model is placed in the case frame by its own outline. Colours come from the project logo by k-means (base, accent, neutral, and a background gradient around the base), with neutral studio colours when there is no logo. The case looks like what it is made of, and a shadow catcher sits under the subject.
    render.showcase (src/tools/render/showcase.ts) names each picture <project>_r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
    [case-base.stl, case-lid.stl]
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2026-11-04 chat: record only the person's own turns; lock confirm cards to the chat's project
    Security review fix: model output could reach the project's memory without a
    Confirm. The chat recorded trace's replies and tool rows under the project-wide
    `<owner>/<repo>/chat` actor.
    - src/api/actions-chats.ts: recordTurns now records only the caller's own user
    turns from chats.append, under their own person actor (recordingActor, which
    refuses anything but a person actor), and only for people with write access
    (a guest's turns are not recorded at all). trace's replies and tool rows are
    never recorded, and chats.reply records nothing. The chat actor is written
    only by a confirmed memory.remember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
2026-11-04 Revision renders 3/4: a revision's renders start when it is cut
    When the gate that cuts a release is signed (or an admin copies the record with journey.snapshot), trace starts the rendering agent on render.showcase. It names the revision and the day it was cut, in the signer's time zone (gate.sign's time_zone, sent by the app from the browser; UTC when none is given or it is not one). The signature and the copy stand whatever happens to the job, and the answer says whether the renders started. journey.snapshot takes renders=false to skip them.
    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
2026-11-04 mock: trace offers to remember, and acknowledges a card's answer
    Asking the mock chat to remember something shows the Remember card, and a
    card's answer gets a short reply instead of the same card again. A thread id
    the client made up is now kept too, so the mock no longer reports that the
    message could not be kept.
    Claude-Session: https://claude.ai/code/session_014dZPhaSvmBqJ66sQCvL9GR
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2026-11-04 Scribe 6/9: the documentation specialist
    A new specialist kind, docs (Scribe, label agent:docs), keeps each
    project's documents current from its records. Its tools: docs.init starts
    the documents a stage needs, docs.stale names the sections a change
    touched (its files and the project database compared table by table: a
    fixed mapping, no model), and docs.write_section writes one section
    between its markers only when it passes the quality bar. It delegates the
    commit to the worker as a change stacked on the one it documents. The
    sample tour's documents task is now Scribe's.
    Claude-Session: https://claude.ai/code/session_014dZPhYw2tgRnebq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
2026-11-04 Smoke test: cover templates, replay, the Case tab, logos, gate findings and remember
    Screens and features added to main since the smoke test, each now checked:
    - Admin › Project templates: a template opens, a stage edits, Save needs a
    reason, Discard undoes it
    - Knowledge graph: a project's record replays (play moves the playhead,
    chapters jump, back to the graph)
    - Design › Case: whether the board fits, which build, its problems on the
    board and listed (or "No case yet")
    - Settings › Documents: the project logo's sample cover
    - Gates: a shape's findings under its criterion, each with "Waive this one",
    and signing off a criterion an admin added (desktop and phone)
    - Ask trace: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
2026-11-04 Scribe 7/9: Scribe starts on its own, and the release gate checks the documents
    A push to the default branch that changed a record a document is written
    from starts Scribe (hook.docs, called by the hooks function on that push:
    the commit's files and its project database against its parent's, table
    by table); a push of only the documents or Scribe's own runs starts
    nothing. Signing a gate that opens a stage with documents starts it too.
    One Scribe job per project at a time. docs.stale now compares with the
    commit the documents were last written at, so a missed event is caught by
    the next. docs.check is recorded as a run, the evidence for the release
    approval gate's new documents criterion (si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
2026-11-04 Scribe 7b: printed copies in the central bucket, release copies for each revision, and a nightly drift check
    docs.publish keeps each PDF in the central bucket under the agents' prefix
    (write-once, never deleted) and the run only where; with release, they are
    the revision's release copies. A revision cut starts Scribe on them.
    documents.get and documents.pdf show them with the journey record and the
    next check. The hooks function's nightly schedule runs hook.drift on every
    project.
    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
2026-11-04 Scribe 9/9 (proof, first findings): printing on the tools function, sections left at the stage before
    From the test-esp32 run on the live installation:
    - Mermaid's browser died on the tools function on every diagram, and the run
    blamed the diagram. The browser is now tried again with flags that leave out
    single-process mode, its own error reaches the run, and a browser failure is
    said to be the browser's.
    - A gate signed changes the journey outside the repository, so docs.stale never
    saw it: it takes also, and gate.sign and a revision cut name the journey.
    Only the Journey section says the stage; Overview follows the board and
    Firmware the pin plan and protocol specs.
    - A writing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
2026-11-04 The project-database merge applies every area's rules, in the harness too
    The update queue's project-database merge (src/harness/db-conflict.ts) loads
    no area, so dbmerge merged every area table (requirements, gates, questions,
    pin plan, architecture…) as a plain union: INSERT OR IGNORE kept the change's
    row and dropped the newer one from the default branch. Merging main into an
    older change therefore reverted work accepted since it was branched.
    Seen on test-esp32: REQ-39855b's criterion was changed and accepted (change
    #9, 3.1-3.6 V); the docs change #8, branched before it, was brought up to date
    by the harness, kept the old "+/-3 %" row, and accepting it reverted the
    requirement and re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
2026-11-05 Infra: re-stage the image lock before synth; turn off the CI runner's report auto-discovery
    The agent image's `npm ci` failed with EUSAGE after the ontology commit added n3: agent/package-lock.json is a
    gitignored copy that only `npm run build` refreshes, and `tracectl upgrade --no-pull` from a clone deployed the stale
    one, so the stack rolled back.
    - src/infra/lockfile.ts: stageImageFiles() runs scripts/stage-image.mjs in a clone; assertImageLockInSync() fails the
    synth in seconds, naming the packages, when the lock the images install from does not match package.json
    - src/infra/app.ts: both run before the stack hashes the image sources
    - src/infra/runner.ts: CODEBUILD_CONFIG_AUTO_DISCOV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
2026-11-05 Agents screen: a map of agents and hand-offs, summarised across projects
    Replaces the Agents table with a picture of who is doing what:
    - Agents by state, and (All projects) a "Projects at a glance" tile per
    project: its agents by state, jobs, hand-offs and what it has on Next.
    - A project filter in the address (?project=owner/name).
    - "Needs you or stuck": questions and stuck reports for the projects in
    view, answered or dismissed in place.
    - The map (React Flow, in the Canvas frame): each agent a box with one
    line per project (job, step, progress), its queue and today's runs;
    hand-offs as arrows per pair of agents counting the hand-offs on each.
    Selecting a box lights its arrows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
2026-11-05 Docs: Mermaid draws in the tools function, and a browser that cannot start no longer stops a print
    docs.publish could not draw any Mermaid diagram on the live install (log #34, #94): the full Chromium died in
    single-process mode, and the only reason the run gave was Chromium's note that there is no D-Bus. The documentation
    specialist then stopped to ask the person to fix trace.
    - The tools image draws with Chromium's headless shell (no display, D-Bus or GPU needed), found by
    tracebridge.docs.find_browser and driven in its own mode; its build draws one diagram
    (python -m tracebridge.docs smoke) so an image that cannot draw fails its build.
    - Chromium's container noise (D-Bus, GPU, crashp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
    [__main__.py]
2026-11-05 New project's agent: a shorter update, an honest estimate, and an event when it lands
    A project created in the web app waits for an installation update that adds its own
    cloud resources (worker runtime and role, memory, knowledge base, runner). In the
    test-esp32 run that showed as "about 60 min left", took 15, and the card still said
    "queued on GitHub" half an hour after it finished (log #2, #3, #4, #5, #6, #80).
    - projects.create starts trace's ci workflow with add_projects: the tests are skipped
    (main passed them in its pull requests) and the update runs at once; a 422 from an
    older workflow falls back to a plain run
    - project.agent estimates from this installation's own recent update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
2026-11-05 Cost: spend by job, an honest budget line, and a warning before a stage overruns
    Run 2 of test-esp32 (issue log #72, #100, #113) spent US$21 by Architect and US$53 by
    Prove on a US$100 budget, mostly reworks, duplicate jobs and repeated docs runs, and the
    gate said "US$0 left" with nothing showing where the money went.
    - The gate's budget line names what takes the budget (the build's forecast: 10 boards at
    US$8 is US$80 of the US$100) and says how far over, never a clamped US$0. The build is
    counted once: forecast until Fabricate, then committed, never both.
    - cost.get gives spend by job (src/core/cost-jobs.ts): each job's specialist, request,
    stage (the stage the project was in when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
2026-11-05 Keep answered questions until a job applies them
    A person's answer was carried on by a job that lived only in its worker's
    queue. When that job was lost, stopped with its runtime or never reached the
    index, the answer was dropped without a sign, and the change it blocked was
    still recommended for accepting (test-esp32 log #131, #122).
    - Each answer a job must apply is kept in the journey record
    (answer_followups, src/core/answer-followups.ts) until a job on its branch
    that started after the answer succeeds.
    - journey.get starts a new carry-on on the same branch, as a new attempt,
    when the expected job failed, was stopped by anything but a person, was
    lost, sat queued with no word, o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
2026-11-05 Gates count the accepted design only, rule checks count warnings, and evidence lists what was checked
    From the test-esp32 end-to-end run:
    - #51: "The electrical rule check is clean, or each finding is waived" read met
    on "0 errors" while the same report had 82 warnings to fix or waive. A met
    capture.erc or layout.drc is now read again from the newest report in the
    default branch's record: every finding not waived (errors and warnings both)
    holds it, it reads not met with why, each finding is listed (waivable on its
    own from the gate), and the evidence names the run and its counts.
    - #43, #57: criteria read met on runs an agent made on its branch before the
    change holding them wa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
2026-11-05 Work order: design first, documents from it; case alongside a docs review; no review over an open question
    - A stage's documents wait for its design work (designWorkLeft): a gate opening a stage, a push and the nightly
    drift check start no Scribe while a criterion of the stage (but the documents' own) is unmet, and say what they
    wait for. The push or the person's act (a guided review, an answer, a waiver, a sign-off) that lands the last of
    it starts Scribe (test-esp32 #58, #98, #120).
    - Layout's case starts once the layout is accepted (FOLLOW_ON, from the push hook), once a stage, not behind the
    documents. A change that meets no criterion follows the stage's criteria in its steps, an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
2026-11-05 Agents: stream each tool call into the job's live log as it happens
    A job's log showed its own steps (cloning, "running the impl specialist", its end)
    but none of Claude's tool calls, so a layout worker that routed for an hour showed
    four lines and then nothing (#125, #117, #45): nobody could tell work from a hang.
    Each tool call is now one line ("tool: kicad.erc (hw/board.kicad_pro)"), a failed
    tool says so, and a tool still running says so every 5 minutes.
    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
2026-11-05 Changes test: changes meeting no criterion follow the stage's criteria; stage guide icon type fix
    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
2026-11-05 Docs-follow test: put the runs Prove's criteria cite in the accepted record
    'a stage opening starts its design work, and its documents wait for it' (from #292) fails on main: it signs Prove on runs that the default branch's record doesn't hold. Since #287, the gates count only the accepted design, so signing refuses. The two pull requests passed apart and fail together. The test now writes those runs into the fake default branch's project database.
    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
2026-11-05 Harness acts as trace's GitHub app, on its own rate limit
    trace's workflows acted as one person's token (TRACE_TOKEN) and shared its hourly
    quota; with ten pull requests and many agents busy it ran out, and open-pr and
    automerge failed on "API rate limit exceeded for user ID ..." (test-esp32 run 2,
    #126 and #128).
    The harness steps given TRACE_TOKEN (open-pr, automerge, update-queue,
    ci-doctor) now mint an installation token of trace's GitHub app for the
    repository alone (vars.TRACE_APP_ID, secrets.TRACE_APP_KEY), and act through
    it. Not set up, not installed on the repository, or refused: TRACE_TOKEN, as
    before, with a notice. A request the app may not make is made with TRACE_TOKEN
    instead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
2026-11-05 Recommendations are answers: an option that needs a detail asks for it; a tight fit says its margin
    - An agent's option that asks the person to supply something ("Name the module to buy") is refused unless it
    says what detail it needs (`needs`); the label is then the answer.
    - An option with `needs` is answered only with that detail: the record refuses it without, the answer reads
    "<label>: <detail>", the Question answer bar's "The answer resolves what it blocks" is not met until it is
    given, the decision card opens a field for it, and the inbox offers no one-tap answer for it.
    - A recommended option that sets a quantity against a hard limit with under 5 % (or 1 mm) of room is refused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
2026-11-05 Harness asks trace's token broker for the app's token; no key in the repository
    Marc chose the broker (docs/agent-identity.md): the GitHub app's private key
    lives only in Secrets Manager, never in a repository secret. So the harness no
    longer signs a JSON web token with TRACE_APP_KEY: it asks the installation's
    token broker (vars.TRACE_GITHUB_APP_BROKER, a Lambda function URL with IAM
    sign-in), signing the request with SigV4 and the job's AWS credentials, which
    each job gets from the repository's token role (vars.TRACE_GITHUB_APP_ROLE) by
    GitHub OIDC just before the harness step. The request names no repository:
    the broker picks it from the role.
    The fallback to TRACE_TOKEN (no broker, no c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
2026-11-05 trace's token broker: a GitHub app token for the caller's own repository
    Piece 1 of docs/agent-identity.md (brought onto main here). The Lambda
    <prefix>-github-app-token, behind a function URL with IAM sign-in, mints an
    installation token of trace's GitHub app for ONE repository, good for an
    hour. It picks the repository from the caller's role
    (requestContext.authorizer.iam.userArn: a project's worker, GitHub OIDC or
    token role, looked up in the registry of onboarded repositories), never from
    the request. The app's key is read from Secrets Manager (<prefix>/github-app)
    and nowhere else.
    Each project gets a token role (<prefix>-gt-<hash>-<region>): GitHub OIDC
    from any run of its own reposit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
2026-11-06 Withdraw a waiver, or take it again; show each waiver once on Decisions
    test-esp32 #149: a waiver taken by mistake (the wrong severity, a reason with
    the risk pasted in) could not be corrected or withdrawn; the API had only
    waiver.add. Its author or an admin now withdraws it with a reason kept in the
    decisions log (waiver.withdraw), or takes it again (waiver.add / the Waiver
    skill with `replaces`), which records the new one and withdraws the old in one
    step. What it waived counts again. A waiver a live signature acknowledged is
    refused with the reason: reopen that stage first. Waivers recorded from an
    answer behave the same.
    #150: the Decisions page matched a waiver to its log entry by titl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
2026-11-06 New project's setup notice: follow the update that matters, and say only what is true
    In the test run the update that added test-esp32's agent finished at 19:35, and at
    20:06 the notice still said "queued", nothing started, "about 13 min left" and
    "trace is looking now" (log #5).
    - project.agent follows the run that serves the request: the first one after it that
    succeeded, else the first still going, else the newest; not simply the newest, which
    a merge to main after the update replaced with a run queued behind it
    - it asks GitHub for the ci workflow's runs on the self-update's branch only, so the
    repository's other runs never push the update out of the page
    - a run GitHub still list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
2026-11-06 Intent builder: an interface's fields follow the person's edit
    "Interfaces fully specified" reads the type, connector, protocol, rate and
    direction stored beside each interface statement, but Edit only changed the
    words, so rewording every interface with all its values left the check unmet
    and only a new job could fix it (test-esp32 #20).
    An edit to an interface statement now records its fields with the decision:
    the fields the person set beside the words, then what the new words say
    (read the way an agent fills them: USB-C receptacle, USB 2.0 full speed,
    12 Mbit/s, both directions, or "rate: 400 kHz"), then the fields as they were.
    The record's view lays them over the agent's while the dec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
2026-11-06 Changes: say when checks cannot start, why, and who fixes it
    A project's checks sat queued for 20 hours on its CodeBuild runner, whose
    every build failed in DOWNLOAD_SOURCE ("GitHub rejected the runner credential
    ... administration=write. Re-authorize the CodeConnections connection"), while
    the change cards said "Checks running, 0 of 2 done" and the Overview "trace is
    working" (test-esp32 log #146, #147).
    - src/api/stuck-checks.ts: a workflow run queued 30 minutes or more is stuck.
    Why comes from the repository's TRACE_CODEBUILD_PROJECT and, where the API
    may read them, the runner project's newest builds (CodeBuild's own words: a
    connection lacking administration access is named as th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
2026-11-06 Spend less per stage: a spend and turn limit per job that stops and asks; documents written once per due change
    Each specialist job now runs with a spend limit (agents.<kind>.max_usd, the Agent SDK's maxBudgetUsd: docs US$5,
    impl US$25, the others US$10) and the documentation specialist with 60 turns instead of 120. A job that reaches
    either limit pauses with its work committed and its conversation kept, and Resume carries it on; before, a job at its
    turn limit failed and its work was done again, and nothing stopped a stuck job spending (test-esp32 #72, #100). A
    worker a specialist delegates to is held to the same spend limit.
    The Documentation agent no longer starts for a push whose checks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
2026-11-06 Say what a skill's Submit came to on the skill's page (test-esp32 #89)
    Submitting Requirements review looked like it did nothing, twice: the page
    went back to the Overview, which still said "Every requirement is accepted or
    struck: not met" and "your draft is kept". A refusal was a toast that went
    by; a submission recorded with a gate criterion it sets still not met (a
    requirement left under an open question, which the bar lets through) said
    nothing about it at all.
    skill.submit now answers what it recorded (the decisions, in words) and every
    gate criterion it set, each one not met with why (the requirements by id) and
    the skill's step that fixes it; while one is still not met the draft is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
2026-11-06 Say what a change holds in its title and summary, never a merge or a job id (test-esp32 #152, #154, #14, #59, #18, #27, #37)
    A change that held only a specialist's record was titled, and summarised, by
    its job id; one brought up to date was titled by its merge commit; a verify
    record's results and an architecture change's options were only in the
    database diff; a change two jobs made was said by the second alone; 22 added
    requirements read as "names none"; and a layout's resistors R4/R5 were said to
    be requirements the project lacks.
    - change-contents: merge commits are skipped like records; a records-only
    change is "The <kind> specialist's record: <what it holds>", from its record
    diff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
2026-11-06 Questions right: fold by criterion, link by id, out of date, plain stuck words (test-esp32 #158, #107, #108, #35, #25)
    - A question about a criterion an open question is about (named in its words or what
    it blocks, or waived by an option) is folded into it, whichever agent asks; journey.ask
    tells the second agent whose question it is and to wait on its answer (#158).
    - Each "Answer it" opens its own question: skill.get takes the question id (the
    Overview link and the reader's question links carry ?question=<id>) (#107).
    - A question whose premise moved on is marked out of date with why: every criterion it
    is about met or waived since it was asked, or (journey.get, which knows the ope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
2026-11-06 Gate page: each criterion counts its own waivers, ratings and findings in plain words, evidence says what it checked
    From the test-esp32 run (#155, #156, #157, #44, #52, #129, #70):
    - A waiver counts for its own criterion only: journey.get says which one (the criterion it names, or the one its
    finding is of), and the gate page's "Met (n waived)" counts those, not the stage's waivers on the first row.
    - A waiver's rating reads as the person chose it in the Waiver form (cosmetic, degraded, failure, safety), each with
    its own icon and style; safety no longer looks like failure.
    - What a waiver is on reads in plain words ("the finding of “The board fits its enclosure…” on requirement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
2026-11-06 Save evidence opened again after an earlier open stopped counting
    journey.criterion.open skipped the write when any open of the person's was on
    record. Since #320 an open counts only after the gate was last signed or
    returned and after the criterion was last checked, so an older open no longer
    counts but still blocked the new one: the action answered ok with the old
    version, the gate stayed at "evidence opened for 0 of 3", and gate.sign was
    refused (test-esp32-e2e, Architect gate). It now skips only when the earlier
    open still counts (openedBy, with the agents' checks merged).
    The bucket store also saves a change that wrote a row while saying
    changed: false, so a write is never dropped whil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
2026-11-06 Web push: register the service worker on every start
    The worker was registered only from turnOn (a tap on a Push switch) or from
    keepFresh when this device had turned push on before. A device that had never
    turned push on had no worker at all, so the live smoke check found no
    registration after opening Preferences, Notifications.
    keepFresh now registers the worker on every start whenever the browser has
    push, before its re-subscribe check; the Notifications group registers it when
    it opens; and a failed registration is tried again instead of being cached.
    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
2026-11-06 Question answer: "Use <option>" arrives chosen, and one Send in the page
    The Overview's next step "Use <recommended option>" opened the question-answer
    skill with nothing chosen, so the option had to be picked again. Its address
    now carries the option (`&option=<id>`, read from the question the step is
    about), and the skill takes it once, when it is one of the question's options,
    and goes on to what is left. Choose again still clears it.
    The quality bar drew its desktop and phone bars both, one hidden by CSS, so
    the page held two "Send the answer" buttons and the hidden one, listed first,
    did nothing when pressed. Only the bar for the screen's width is drawn now.
    Fixes #198
    Co-Authored-By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
2026-11-06 Overview: an answered question stops being the next step at once
    Right after sending an answer, the Overview still showed the answered question
    as the next step with its "Use …" button, while Waiting on people already said
    0: the answer was applied to the cached journey's questions but not to its
    next step, which stayed until journey.get came back. applyWrite now replaces a
    next step about the answered (or dismissed) question, by its ref or by the
    question its button opens, with "Answered. trace carries on with it." until the
    refetch says what comes next. The mock's question.answer does the same to its
    journey, so mock mode shows the step after an answer.
    Fixes #199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
2026-11-06 Changes: one count of checks on the card, the heading and the recommendation
    The Overview's change card and the change page's heading said "2 checks
    passed" (GitHub's status, counting each workflow as one check), the page listed
    five checks ("2 more checks"), and the recommendation said "All 3 checks
    passed (automerge, check and tests pass)" (test-esp32 #201). change.get now
    counts the checks its page lists (each workflow read as its jobs), so the card
    and heading (both read change.get) and the recommendation say one count; and
    the count's words say the skipped ones ("3 checks passed, 2 skipped"), so it
    adds up to the list.
    Claude-Sess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
2026-11-06 Jobs are titled by a headline, never their prompt cut short (test-esp32 #196)
    The scoped reopen (requirements changed, a stage reopens and redoes only what
    the change reaches) started its job with no title, and the job index took the
    request's first 200 characters: the Sign-off gate page and the Overview named
    it "Sign-off is open again because ... only par".
    - A task can carry a headline (TaskPayload.headline), set when it is started;
    the scoped reopen sets "<Stage>: redo what the requirement change reaches"
    (or "finish what is left after the requirement change").
    - The one place a task's title is made (core plain-words jobHeadline, used by
    the runtime's job index and the API's agent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
2026-11-06 Release report: interference, parts list and open waivers; review evidence is the report's run
    verify.report's report.md covered coverage and tests only, and its open items said "None" while 17 waivers
    stood (test-esp32 #207). It now reads from the record:
    - Interference (EMC): the newest emc.precheck with its findings, the newest spectrum, field-solver and signal
    integrity runs, all labelled pre-compliance estimates, and whether signoff.emc or its findings are waived.
    - Parts list: the newest parts.bom_check, its lines, cost for the boards checked and stock, against the build
    quantity of the build plan.
    - Open waivers: every waiver not closed, most severe first, with what it is on and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
2026-11-06 Gate record: a long evidence chip wraps under its criterion (test-esp32 #195)
    On a signed gate's record, a criterion beside a long chip ("kicad_drc: 0
    errors, 0 unconnected, 0 parity, 2 warnings") wrapped one word a line: the
    text was flex-1 with no minimum width, and the chip kept its full width. The
    text and chip now share a wrapping row beside the status; the text keeps a
    readable minimum width (14rem, or the row), and the chip wraps under it and
    shrinks to the row, its label truncating. The mock's architecture record
    gains such a criterion.
    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
2026-11-07 Say "trace is updating" during an API redeploy, and accept safely through it (#223)
    While a deploy replaces the API runtime, AgentCore answers 424 with none of
    trace's words. The web backend passed it through, and the app showed a bare
    "424" (the toast added "Nothing changed", which the API never said).
    - src/web/call.ts: a 424, 502, 503 or 504 from the runtime without trace's own
    refusal becomes 503 api_updating with words, and the runtime's body is logged.
    - web/src/lib/http.ts: an answer with a status and no words is said in words
    (UPDATING for 424/502/503/504), never a bare status.
    - Reads (every query) try again for about a minute while trace is updating,
    with growing waits; anyt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
2026-11-07 Reload once when a deploy replaced a page's code, or say a new version is ready (#216)
    After a web deploy, an open tab's next page load failed with "Failed to fetch
    dynamically imported module …/assets/_app-….js" and the router's bare
    "Something went wrong!".
    - lib/new-version.ts: a chunk-load failure (every browser's words, Vite's
    vite:preloadError) reloads the tab once to the same address. The time of
    that reload is kept in sessionStorage (with try/catch); another failure
    within a minute does not reload again, so a tab never loops.
    - components/route-error.tsx: the router's default error page. A chunk
    failure says "Loading the new version of trace…" while it reloads, or "A n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
2026-11-07 Renders: name files after the project; vendor 3D bodies; off-board parts (#215, #214)
    render.showcase named its files after the folder the agent ran in. It now takes
    the project's name from the record: the name given (new project_name input),
    the journey's name, the KiCad project's, the repository's, and the folder only
    as a last resort. The result's name says which.
    A footprint whose model KiCad's 3D library lacks (J1, HRO TYPE-C-31-M-12), or
    that names none, now gets its vendor's model: the STEP EasyEDA keeps for its
    LCSC code, placed by matching EasyEDA's pads to KiCad's. The export reads a
    copy of the board naming it. Without the network, an LCSC code or matching
    pads, the part stays wi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
    [board.kicad_pcb, easyeda-C165948.json]
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2026-11-07 Live smoke: the read-aloud test sets spoken replies on, and the preferences test waits for its saves
    The read-aloud and dictation controls show only while the "Spoken replies" preference is on. The live smoke
    account is shared with the preferences test, which flips that switch and flips it back. The switch updates before its
    save lands, so a run that moves on early can leave the account with spoken replies off; every live run since then
    failed "read-aloud and dictation controls are there" (element not found).
    - chat.smoke.ts: the read-aloud test turns Spoken replies on in /me first when it is off, and waits for the save.
    - admin.smoke.ts: the preferences test waits for each of its two saves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
2026-11-07 Gate page: a refused signature says why in words (test-esp32 #179)
    The sign dialog folded the record's refusal ("Open the evidence for ...")
    under Technical detail, so the signer saw only "The gate was not signed."
    The refusal is now the alert's text; other failures keep their detail.
    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
2026-11-07 pcb.length_match: no vacuous pass; tolerance by signal class (test-esp32 #163, #187)
    A pair the check found but gave no tolerance (the test board's USB D+/D-) counted as passing, so "Matched-length
    groups are within tolerance" was met with nothing checked. Now:
    - a pair with no tolerance, or a pair on the board by name that nothing checked and ignore does not name, makes the
    run not met, with reasons ("/USB_DP//USB_DN has no matched-length rule"); a board with no pairs or groups says
    there is nothing to match
    - a pair's tolerance falls back to its signal class: USB 2.0 Low/Full Speed 15 mm (100 ps; edges of 4 to 20 ns),
    High Speed 1.27 mm (50 mil), each row with its basis; a USB pair'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
2026-11-07 Overview: a slow first load says so, with Try again (test-esp32 #171)
    After a deploy the Overview showed grey placeholders alone for 15 s and
    more. A read retries for about a minute while trace is updating, and the
    API runtime may take 50 s to answer. After 8 s, or once a try has failed,
    the Overview says what is happening and offers Try again.
    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
2026-11-07 Lead a stuck report's summary with its point, not an aside
    The plain summary dropped every sentence that cited a check's id, so a
    stuck report whose only plain sentence started 'Also:' showed that aside
    on the Overview (test-esp32 #170). Brackets that cite internals are now
    taken out of a sentence instead of dropping it, criterion ids and hashes
    count as internals, and an aside never leads.
    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
2026-11-07 Check an off-board part's pin order against the connector it plugs into, at Capture (test-esp32 #169)
    The OLED module's datasheet (ea9a571f p2) gives pin 1 VCC, pin 2 GND, the reverse of J2's
    GND, VCC, SCL, SDA, and no check caught it: a straight cable would reverse its supply.
    An off-board part now records what it plugs into (its block's mates: the connector, its
    pin order from its datasheet, and where). design.pins check, the record's pin plan and
    Pin plan review compare it pin for pin with the connector's rows, naming both orders; a
    supply pin that differs blocks, and Pin plan review gains the check "Every off-board
    part's pins match its connector". journey.check refuses capture.datasheet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
2026-11-07 tracectl check: a pull request of trace's records only has nothing to check
    A record-only change (a specialist's .trace/project.db) stacked on the
    case change showed '1 check failing: build': its build checked the whole
    design, so the case fit failure of the change below it was reported on
    it (test-esp32 #141). In a pull request's run, tracectl check now
    compares the merge with its base commit and, when only .trace/ changed,
    says so and passes. The change below carries its own failure, and the
    default branch is checked in full after the merge.
    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
2026-11-07 Fixed architecture criteria follow the requirements they quote (test-esp32 #173)
    After the budget change, the deciding criteria still read "Cost against 8 USD/board and 100 USD
    project": the fixed list is a copy of the criteria's words, so a criterion the agent reworded
    from the new requirement kept its old words. Fixed criteria now keep their ids and weights (the
    choice stands) and take their current words, saying the name they were fixed with. A criterion
    naming a requirement that changed after its words were written says its numbers may be old,
    with Ask trace to reword it.
    Claude-Session: https://claude.ai/code/session_014dZPhWuP7Ky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
2026-11-07 A job's last log line shares endedAt's clock read, so its stream ends on ✗/✓
    The job runner read the clock once for endedAt and again for its last log line. The run log writer orders a stream by
    time, so when the two reads fell a millisecond apart, "failed: <why>" landed after the stream's end line "✗ <why>".
    test/agents/log-stream.test.ts failed this way in CI on #342 and #366 (expected '✗ no token', got 'failed: no token').
    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
2026-11-07 journey.check refuses met on a cited run that did not pass
    A criterion recorded met had only the agent's word that its evidence run
    passed: the length tool now fails a pair with no tolerance, and nothing
    stopped an agent citing that failed run for met (test-esp32 #233).
    checkEvidence now returns the runs cited, and journey.check refuses met
    when one failed, errored or has not finished, unless a person waived what
    failed (an open waiver of the criterion or of one of its findings, such as
    an ERC run failing on errors each waived).
    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
2026-11-07 Pin plan check: a boot strap something drives needs an external pull (test-esp32 #104)
    design.pins check (and Pin plan review's boot check) now finds a boot strapping pin
    (reserved: boot) whose net carries another part but no resistor to a supply or
    ground: its level at reset rests on the part's weak internal pull. The ESP32's IO0
    on the auto-reset transistor's collector is the case the log found. A strap left
    unconnected or tied to a rail is not a finding. The implementation specialist's
    Capture step says to add the pull, or give the reason for leaving it out.
    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
2026-11-07 Gate: the cost line as short items, not one paragraph
    The gate's cost line ran spent, the AWS bill, the build budget with the
    forecast's source, the order estimate with its limits and the allowance into one
    paragraph of about ninety words (#236). gateSpendItems gives one item each: a
    head on its own line ("Build budget US$200 for boards, parts and case: US$28.80
    left") with what explains it under it, one short line each. The gate shows them
    as a list. gateSpendLine is now the items as plain text.
    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
2026-11-07 Changes: say whether a job fixes a failing change, and who asked for a hand-off's change (test-esp32 #234)
    - A failing change's line said "trace is fixing it" whatever was running. A job of trace's working on a change
    already makes it "trace is still working on this change", so a failing one has none: it now says "No job is
    fixing it now: ask for changes and trace fixes it", as the recommendation does. In run 2 the ci-red pick-up came
    13 hours after the failure, all that time saying "trace is fixing it".
    - A change made by a hand-off (one specialist asking another, journey.handoff) said only "From the EMC
    specialist". change.get now gives `handoff` (who asked, what, what it blocks),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
2026-11-07 FPGA: a failed synthesis says why, downstream and in the tests
    CI once saw fpga.pnr fail with "run … (fpga.synth) has no netlist.json (it has:
    yosys.log)" (#235). That run had neither netlist.json nor stat.txt, only its log: the
    synthesis itself had failed, and the test went on to place and route without
    looking at whether it passed, so yosys's reason was never shown.
    - fpga.pnr, fpga.timing and fpga.bitstream on a run that did not pass say so, with
    its summary, instead of naming a missing file.
    - A synthesis without an ERROR line says how yosys ended (a signal named: SIGKILL is
    out of memory or the time limit) and the last line of its log.
    - The flow tests check every synthesis passe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
2026-11-07 Traceability: an intent line left out on purpose says so, not "not covered"
    An intent line marked "don't care" showed in the diagram as "not covered", and
    no check or item mentioned it, so nothing said why it was grey (test-esp32
    #31). A line with no requirement is now "not covered" only while nothing says
    why: one marked "don't care" says "left out: don't care", one left out in the
    review says "left out" with its reason. The Requirements page and
    requirements.trace's summary no longer count a don't-care line as uncovered,
    as the review's "covered" check already did not.
    Claude-Session: https://claude.ai/code/session_014dZPhWuP7KyHGvdN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
2026-11-07 Design tab notes and a running job's step in plain words (test-esp32 #40)
    The Design tab's notes named tools to a person ("the parts check
    (parts.search) answers it", "proposes it with design.pins"), and "trace is
    doing" showed the runtime's own line: the repository, the branch and "max
    120 turns, 40 tools".
    - design.get notes and the pin plan checks: what is missing and who does
    it, never a tool's name
    - jobViews: stepWords says who is working ("The Implementation specialist is
    working"); Watch still shows the log line
    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
2026-11-07 Question answer: typing an answer no longer moves the "Does it last?" choices
    The side panel drew what is written so far above the answer's fields and the
    "Does it last?" choices, so each line typed moved them down and a click aimed
    at "Just this once" missed (test-esp32 #36). What is written so far is now
    drawn last, and the answer box keeps its height (it scrolls, and can be pulled
    taller), so what is below it on a narrow screen stays put too.
    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
2026-11-07 Changes: a record that changes one intent statement is titled by it (test-esp32 #87)
    The fix to one intent statement was titled "trace: the verify specialist's
    record (job-…)". Since #319 it reads "The verification specialist's record:
    1 intent statement", which still does not say what changed.
    - oneRowTitle: a records-only change that adds or changes one intent
    statement or requirement (and nothing else but its intent link) is
    titled "Changes intent statement INT-8dd269: (4) Wi-Fi 2.4 GHz …"
    - used for its page and the list, as betterTitle's `one`
    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
2026-11-07 Schematics open on the circuit: local labels no longer reach to the page corner
    A schematic sheet still opened with its parts small inside the page frame
    (test-esp32 #242, the bridge sheet). The fit to what is drawn (#402) took in
    the box of every local net label, and KiCanvas gave each one a box from the
    sheet's origin: a local label has no shape, and KiCanvas still drew its empty
    shape as a line, whose box is (0, 0). The bridge sheet's box ran from the
    page's top-left corner to x 175, y 153 mm instead of from x 53, y 65.
    The vendored KiCanvas now draws no line for an empty label shape. The fit
    also leaves out free text and pictures, so a sheet's heading note in the top
    corner does not pul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
2026-11-07 New project's agent: the add-projects update deploys again (test-esp32 R7)
    An add_projects run skips the test jobs on purpose, and GitHub's implied success() on update-installation
    asks every job before it, so the update was skipped too: the run read as success, the setup banner ticked
    every line, and the new project's agent was never added. update-installation and smoke-live now run on
    always() and their direct need's result. A skipped deploy job is shown as failed, and the run with it.
    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
2026-11-07 Database diff: an added row read as words, in a wider column (test-esp32 R10)
    A change's database diff listed an added or removed row as every stored value
    joined on one line: Unix-second times, raw JSON, {} [] and "empty" values,
    0/1 flags, broken mid-word in a narrow column.
    - readable(): times (by column name, or a number that clearly is one) as local
    date and time; JSON as compact words; 0/1 in a yes-or-no column as yes/no;
    NULL, "", {} and [] as empty. Used for added, removed and changed fields.
    - rowFields(): an added or removed row's filled-in fields, one a line, without
    the key the Row column already shows.
    - The table list sits beside the rows only when the pane is wide enoug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
2026-11-07 Intent builder: trace's chat edits a record statement as the panel does
    Asked to fix the quality bar's flags on statements already in the record (a
    missing connector or rate, a quantity without a unit, an untestable line),
    the chat offered a Verification job, while the Draft intent panel's own Edit
    changes them as the person's decision (test log R12).
    - A decide_intent frontend tool beside note_intent: accept, edit (words and
    an interface's fields), reject with a reason, or undo, on any statement the
    panel shows. It writes the same draft.decisions the panel writes, so the
    statement shows as Not submitted, the quality bar checks it and Submit
    intent records it like the person's own e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
2026-11-07 Intent builder: a chat edit keeps an earlier edit's interface fields
    decide_intent read the statement as the panel shows it, with the draft
    edit's fields already laid over (withDecided), and sent only the fields
    that differed from it. A "direction only" edit after a panel edit with
    connector, rate and direction therefore replaced the decision with
    { direction } alone: connector and rate fell back to "not given" and the
    quality bar dropped (test log R17). The earlier edit's fields are now
    kept under the new edit's changes (mergedFields), in decide_intent and
    in withIntentDecision. Undo still drops the whole edit.
    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
2026-11-07 Stuck notes retire once what they waited on lands; no job ids or tool lines in person-facing words
    - A stuck note is retired once the project's stage moved past it, or once
    every other job it names has ended and left no open change.
    - Job ids an agent's words name (job-…, queued~…, job <12 hex>) read as
    the job's title, or "another job".
    - The recommended option's button is "Use <label>" only for a short
    label, else "Use the recommendation" (the app still preselects it).
    - A job's card shows what kind of step a tool call is, not the tool's
    name and arguments; Watch keeps the line.
    - The answer toast no longer names a branch; the stray 0 under
    "trace recommends" is gone.
    test-e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
2026-11-07 Requirements drafting: the intent list says what a person stated
    The drafter read a pitch and a bus rate that a person typed in the Intent
    builder's Edit as the interface record's, and marked them inferred. Each
    statement in design.intent list now has `person`: who, whether the words
    are theirs, and the interface fields they gave (those their decision holds
    that differ from the agent's). The drafting request says those values are
    the person's and not marked inferred. The earlier request stays known.
    The Requirements review source line no longer doubles the full stop when
    the intent words end with one ("JLCPCB..").
    Claude-Session: http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
2026-11-07 Traceability: a long drawing opens readable, at its top
    Requirements review's diagram opened fitted whole: with many rows every box
    was too small to read in the frame (21-71 %). A drawing that would open
    below 80 % now opens as wide as the frame allows (80-100 %), at its top,
    and the person drags it up and down. The Fit button still shows the whole
    drawing. readableViewport is pure and tested.
    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
2026-11-07 A hand-off's change is the answering specialist's, in the asker's stage
    The analog specialist answered the Implementation specialist's hand-off on
    its branch; the asker then carried on there, so the change was credited to
    the newest job on the branch: "Made by the Implementation specialist", and
    "The Implementation specialist asked the Implementation specialist for this".
    Its question named no gate criterion, so its Stage read "-"
    (test-esp32-run2 R29). The asker's carry-on job no longer takes over a
    branch a task holds, and a hand-off job's change takes the stage of the job
    that asked when it names none itself.
    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
2026-11-07 Say the record's ids in an agent's words as people say them
    Agents cite what they read by id, and the app showed it as it was
    (test-esp32-run2 R29, R30, R31):
    - A question or stuck note named a gate criterion by id: "so
    architect.stock is not met", "It blocks the architect.stock criterion".
    Wherever a question is shown (the journey's questions, the next step, the
    inbox, Question answer, Pin plan review) a criterion reads as its own
    words. The record keeps the ids, which say what a question is about.
    - Architecture choice's "Read each option" (and the Design tab) quoted
    "Parts check 84ac569329e8472d" and "(answer aq472364d7dd6243)": a run
    reads as what it is ("the parts check", o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
2026-11-07 The block diagram opens readable, as the traceability view does
    Architecture choice's "Read each option" opened the block diagram fitted
    whole, at 65 %, its blocks unreadable (test-esp32-run2 R31). Fixed bounds
    (the layout held still between options) now take FlowFit's `readable` from
    #422 too: below 0.8 the diagram opens at 0.8 from its top left corner, and
    the person drags it; Fit still shows it whole.
    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
2026-11-08 Count a module pin-order waiver for capture.datasheets (run2 R42)
    Marc's answer waived the J2 pin-order finding (mate:J2:…:order), but
    journey.check still refused capture.datasheets on the failed pin plan
    check, so the specialist asked him to confirm the same waiver again. A
    mate: finding's waiver now counts for capture.datasheets, as mateConflicts
    already treats it, and reads as "the pin plan check's pin order finding on
    J2 (the … module)".
    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
2026-11-08 Keep a line's indent when an id is said in words
    plainRecordRefs collapsed every run of spaces, which took the indent off a
    stuck agent's quoted stack trace once questions went through it.
    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
2026-11-08 Have trace add the KiCad libraries a check says are left out (run2 R43)
    The new schematic's ERC had 67 warnings, all "the current configuration
    does not include the symbol/footprint library 'X'", and the next step
    asked a person to waive 50 of them. They are fixed by listing the stock
    libraries in the project's sym-lib-table and fp-lib-table, as run 2 of
    test-esp32 did. kicad.erc now lists the missing libraries with what to do
    (library_tables), and when every open finding is one, the next step asks
    trace to add them instead of asking for waivers.
    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
2026-11-08 Say a pin plan finding in words, and a waived one as done (run2 R44)
    Every step of Pin plan review showed the waived J2 finding as "its
    datasheet ea9a571f p2 …" with "Fix it in the plan or the schematic, or
    waive it." The finding now reads "its datasheet, page 2" and, once
    waived, "Waived: nothing to do here."
    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
2026-11-08 A rule check with warnings left does not meet its criterion (run2 R45)
    The schematic gate showed ERC "Met · 0 errors, 67 warnings": the agent's
    met check cited an old ERC run with 67 warnings first and the clean run
    after it. journey.check now refuses capture.erc or layout.drc met on a
    cited ERC or DRC run with warnings left (they count: test-esp32 #51),
    unless a person waived the criterion's findings, so only the clean run is
    cited and the gate says what it was met on.
    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
2026-11-08 Title a job by its work, not a brief's opening context (run2 R48)
    The Layout worker's card read "The schematic is proven (design proven gate
    signed)": the first plain sentence of the specialist's brief (#430). A
    sentence that only says which gate was signed is now skipped, as the
    stage jobs' "The … gate was signed" already were.
    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
2026-11-08 tracectl check: a case build whose every problem a person waived passes
    Run 2 (R54): PR #15's required check failed on a C6 gap under the display window, the very finding the layout gate
    asked a person to waive, so the change could not pass while the waiver was the agreed answer, and the agent asked a
    second question about it. The check now reads the project's open waivers on layout.fit findings, matched by the
    problem's record (the check runs under the repository's name, the app under its installation's), passes a build
    whose every problem is waived, and says how many are waived.
    Claude-Session: https://claude.ai/code/session_014dZPhW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
2026-11-08 Case fit in CI: problems waived in the journey can be listed in case.json
    #448 had tracectl check read the journey's waivers, but in CI the journey is in the installation's store, not the
    repository's project.db, so PR #15 in test-esp32-run2 still failed on the waived C6 gap (R54). case.json gains
    `waived` (problem key -> what was waived, by whom), set with mech.settings once a person has waived it; the check
    passes a build whose every problem is waived in the journey or listed there. The layout gate counts only the
    journey's waivers. mech.build's next step and the docs say so.
    Claude-Session: https://claude.ai/code/session_014dZPhWuP7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
2026-11-08 Release review: the coverage waiver covers untested requirements; a budget states the expected cost
    Run 2 (R59): with "every requirement is verified or waived" waived for revision A (trace's recommendation: nothing
    more can be checked before boards exist), the release review's bar still said "23 requirements untested"; and with
    a US$100 budget for 10 boards it asked for a unit cost no one had set. An open waiver of signoff.coverage now meets the
    untested check, saying so and where the items are checked (a failing requirement still needs its own); a build budget
    states the expected cost when there is no unit cost.
    Claude-Session: https: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
2026-11-08 Release review: show the emission spectra made with the newest precheck
    Run 2 (R60): the USB cable's common-mode estimate passed at 0.05 % mode conversion and failed by 18 dB at 1 %, and the
    release review's EMC step showed neither (it read emc.run and emc.si only). It now lists the emc.spectrum runs made
    with the newest precheck, newest first, one over the limit marked so.
    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
2026-11-08 Release review: recommend release under the coverage waiver; say an emission estimate over the limit
    Run 2 (R59/R60 follow-up): with "every requirement is verified or waived" waived for revision A on trace's own
    recommendation, Decide still recommended returning to Sign-off because "23 requirements are untested or failing".
    Untested requirements under an open signoff.coverage waiver are no longer a concern (failing ones still are); an
    emission estimate over the limit is one, unless signoff.emc is waived.
    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
2026-11-08 kicad.fab: find copper Gerbers of a board that renamed its copper layers
    checkFab looked for copper only by KiCad's default layer names (-F_Cu, -B_Cu), so a board that names its copper
    layers top_layer and bottom_layer failed its fab package with "no copper Gerbers were written" although both copper
    files were there (test-esp32-run2, revision A). Copper is now also found by the Gerber job file's FileFunction, the
    file's own X2 FileFunction attribute or a Protel copper extension (.gtl, .gbl, .g1...).
    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
2026-11-08 GitHub rate limits: say whose limit is used up and when to try again
    When trace's shared GitHub token ran out of requests, accepting a change and opening a change page answered
    "internal error: GitHub GET pull 22: 403", which reads as trace failing and drops GitHub's own reason. A 403 or
    429 that is a rate limit (no requests left, a Retry-After, or GitHub saying "rate limit") now throws a GitHubError
    marked rateLimited, whose message says whose limit it is and when to try again (from x-ratelimit-reset or
    Retry-After); the API answers it as a plain error, not an internal one. Other refusals are unchanged.
    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
2026-11-08 Close an out-of-date question without answering it
    A question about PR #15 stayed under Waiting on people hours after #15 merged, marked only "may no longer need an
    answer"; answering it would have started the asking agent's job again for nothing (test-esp32-run2 R62). A new
    action, question.close, closes a question that is out of date (outOfDate: what it is about is met or waived since,
    or the changes it names are no longer open) with the answer "No answer needed: <why>", and starts no agent; it is
    refused while the question still stands. The project overview shows "Close it: no answer needed" beside the
    out-of-date note.
    Claude-Sessi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
2026-11-08 worker-dispatch: do not dispatch an item that moved on since it was picked up
    In test-esp32-run2, the worker picked up PR #23's merge conflict at 12:41:54; trace merged the project record into
    it itself at 12:41:56 (record-merge); the dispatch step sent it to the Implementation specialist at 12:42:26 anyway,
    and the agent was paid to report that the merge was already pushed (R64). worker-dispatch now reads the pull
    request again first: closed, its head moved on from the commit it was picked up at, or (a conflict) mergeable now,
    it says so on the item and dispatches nothing. An issue, or a PR it cannot read, is dispatched as before.
    Cla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
2026-11-08 Requirements drafting: every criterion has a number, inspections count
    Run 3's Verification specialist drafted REQ-026 with "The schematic and BOM contain no real-time clock chip …
    (inspection)"; Requirements review's "one testable criterion each" refused it, so the person had to reword trace's
    own draft. verify.requirements now lists criteria without a number (without_number) on add and update, with how to
    fix one ("0 real-time clock chips"), and the drafting request says an inspection counts what it checks. The earlier
    request text is still known as a drafting job.
    Claude-Session: https://claude.ai/code/session_014dZPhWuP7KyHGvdNxx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
2026-11-08 Specialists: do not ask what the requirements already state
    Run 3's Implementation specialist asked "Which budget should the comparison use?" while quoting REQ-027, which
    says it in words (USD 100 for PCB, assembly, parts and extended-part fees, not shipping, case or OLED). The question
    cost a job and the person's wait. The journey instructions now say to read the accepted requirements and the intent
    before asking, to act on what they state and cite it, and to ask only what they leave open or what the work shows
    is wrong. Harness bundle rebuilt.
    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
2026-11-09 Question answer: link the runs a question cites, so its pictures show
    The question view sends a cited run as its id only. questionRuns and the evidence chip need the run's address, so
    "Do you approve the renders?" showed no renders and the chip said "trace cited a run without saying what it
    shows" (test-esp32-run3 S13; the R49 fix only worked against the mock, which added addresses the API never sends).
    The page now adds each run's address from the project, and the mock sends runs as the API does.
    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
2026-11-09 Owned work: judge 'met' as the gate does before skipping a start
    The layout gate read "every connection is routed" and the DRC criterion as not met: an agent's check met them on run
    0e6c55a3, which no accepted record (or any branch) holds. trace's own start for them was skipped as "met" on every
    look, since it read the agent's check without the accepted-design view, so the Overview said "trace started work"
    with nothing running (test-esp32-run3 S16). The start now reads the criterion through withStaleEvidence, as the gate
    does.
    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
2026-11-09 Changes: name a required check that never ran, not a review
    Change 10 in test-esp32-run3 was blocked: GitHub never started the build workflow on its pull request, so the
    required "tests pass" check was missing. The page said "Its checks passed, but this repository asks for a review trace
    cannot give. An admin can fix the rule", and the project's ruleset asks for no review (test-esp32-run3 S17). change.get
    now knows the project's required check (build.required_check) and, when it is not among the checks that reported, says
    so and how to run it.
    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
2026-11-09 Case drawings: the cad function's whole allowance, and each step timed
    The low level design's case drawing was killed at 600 s twice on the project's cad function (test-esp32-run3 S19),
    which left the Sign-off documents criterion stuck: the same 268-face case draws in about 35 s here (four exact
    hidden-line projections, 4-13 s each). docs.figures now gives the drawing the function's whole allowance
    (FUNCTION_MAX_SECONDS, 840 s), and the drawing prints how long each step took to stderr, so a drawing that still runs
    out says where.
    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
2026-11-09 Draw the case in about a second: no deep edge copies, no OpenCascade fonts
    The documents agent's case drawing was killed at the cad function's 840 s limit
    twice after the side view (test-esp32-run3 S19). build123d's Shape.moved copies
    each edge deeply (about 12 ms an edge): placing the views took 25 s on a laptop
    and far longer on the function. OpenCascade's own move is instant. The
    dimensions no longer use build123d's Draft, whose text loads the system fonts
    through OpenCascade; they are plain edges with their values written as SVG text.
    A timing line follows the placed views too.
    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
2026-11-09 A pull request of another repository is not one of the project's changes
    A question whose job title cited "trace PR #482" was marked "Out of date:
    Change #482 is no longer open" and offered "Close it: no answer needed"
    (test-esp32-run3 S20). A PR number qualified by trace or an owner/repo is not
    read as the project's change.
    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
2026-11-10 The waivers one answer took are one entry in the decisions log
    Accepting the case question's answer took six waivers, and Recently showed six
    entries each repeating the whole 700-character reason (test-esp32-run3 S15).
    Waivers side by side with the same person, rating and reason now read as one
    entry naming each thing waived.
    Also: run-images.test.ts made its directory a project (an empty project.db), so
    openProject no longer fell back to the per-user scratch database, where a second
    run failed on a duplicate run id.
    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
